arnaldojr/Cubesat/Diagrama em Blocos/Block Diagram.pptx

Solar Panel

Células Solares

Sensor Temperatura

+X

Solar Panel

Células Solares

Sensor Temperatura

-X

Board Charger

CH Ideal

Sensor Tensão/
Corrente

Board Control

Carregador bateria

BATERIA 8.4v
Ion-Lithium

Conversor Boost 12v/1A

Conversor Buck 5v/2A

Conversor Buck 3v3/3A

CH Ideal

Sensor tensão/
corrente

BUS
Power

Solar Panel

Células Solares

Sensor Temperatura

+Y

CH Ideal

CH Ideal

Sensor tensão/
corrente

Solar Panel

Células Solares

-Y

Sensor Temperatura

CH Ideal

Sensor temp.

CH Ideal

CH Ideal

DIODO

Sensor tensão/
corrente

Sensor tensão/
corrente

CH Ideal

MUX. Analógico

Conversor
Buck-Boost
Backup

CAM

Comunicação

Suporte para Desenvolvimento

Tx / Rx

LEDs

CHAVEs

PLACA CARREGADOR

Conversor Buck 5V uC

uC

PLACA DE CONTROLE

## Slide 2

Solar Cell

Temperature Sensor

+X

Solar Cell

Temperature Sensor

-X

Board Charger

CH Ideal

Sensor Tensão/
Corrente

Board Control

Carregador bateria

BATERIA 8.4v
Ion-Lithium

Conversor Boost 12v/1A

Conversor Buck 5v/2A

Conversor Buck 3v3/3A

CH Ideal

Sensor tensão/
corrente

BUS
Power

Solar Cell

Temperature Sensor

+Y

CH Ideal

CH Ideal

Sensor tensão/
corrente

Solar Cell

-Y

Temperature Sensor

CH Ideal

Sensor temp.

CH Ideal

CH Ideal

DIODO

Sensor tensão/
corrente

Sensor tensão/
corrente

CH Ideal

MUX. Analógico

Conversor
Buck-Boost
Backup

CAM

Comunicação

Suporte para Desenvolvimento

Tx / Rx

LEDs

CHAVEs

PLACA CARREGADOR

Conversor Buck 5V uC

uC

PLACA DE CONTROLE

## Slide 3

Solar Panel

Células Solares

Sensor Temperatura

+X

Solar Panel

Células Solares

Sensor Temperatura

-X

CH Ideal

Sensor voltage/ current

Board Control

Charger battery

BATTERY8.4v
Ion-Lithium

Conversor Boost 12v/1A

Conversor Buck 5v/2A

Conversor Buck 3v3/3A

CH Ideal

Sensor tensão/
corrente

BUS
Power

Solar Panel

Células Solares

Sensor Temperatura

+Y

CH Ideal

CH Ideal

Sensor tensão/
corrente

Solar Panel

Células Solares

-Y

Sensor Temperatura

CH Ideal

Sensor temp.

CH Ideal

CH Ideal

DIODO

Sensor tensão/
corrente

Sensor tensão/
corrente

CH Ideal

MUX. Analog

Converter
Buck-Boost
Backup

CAM

Comunicação

Suporte para Desenvolvimento

Tx / Rx

LEDs

CHAVEs

BOARD CHARGER

Conversor Buck 5V uC

uC

PLACA DE CONTROLE

## Slide 4

Solar Panel

Células Solares

Sensor Temperatura

+X

Solar Panel

Células Solares

Sensor Temperatura

-X

Board Charger

CH Ideal

Sensor Tensão/
Corrente

Carregador bateria

BATERIA 8.4v
Ion-Lithium

Boost Conberter 12v/1A

Buck Converter 5v/2A

Buck Converter 3v3/3A

CH Ideal

Sensor voltage/ current

BUS
Power

Solar Panel

Células Solares

Sensor Temperatura

+Y

CH Ideal

CH Ideal

Sensor voltage/ current

Solar Panel

Células Solares

-Y

Sensor Temperatura

CH Ideal

Sensor temp.

CH Ideal

CH Ideal

DIODE

Sensor voltage/ current

Sensor voltage/ current

CH Ideal

MUX. Analógico

Conversor
Buck-Boost
Backup

CAN

Comunication

Development Support

Tx / Rx

LEDs

Buttons

PLACA CARREGADOR

Buck Converter 5V uC

uC

BOARD CONTROL

## Slide 5

Solar Cell

Temperature Sensor

+X

Solar Cell

Temperature Sensor

-X

CH Ideal

Sensor voltage/ current

Charger battery

BATTERY8.4v
Ion-Lithium

Boost Conberter 12v/1A

Buck Converter 5v/2A

Buck Converter 3v3/3A

CH Ideal

Sensor voltage/ current

BUS
Power

Solar Cell

Temperature Sensor

+Y

CH Ideal

CH Ideal

Sensor voltage/ current

Células Solares

-Y

Sensor Temperatura

Temperature Sensor

CH Ideal

Sensor temp.

CH Ideal

CH Ideal

DIODE

Sensor voltage/ current

Sensor voltage/ current

Solar Cell

CH Ideal

MUX. Analog

Converter
Buck-Boost
Backup

CAN

Comunication

Development Support

Tx / Rx

LEDs

Buttons

BOARD CHARGER

Buck Converter 5V uC

uC

BOARD CONTROL

Analog Data

Digital Control

Comunication

Main Power

Backup Power

## Slide 6

+ Vfotocell

GND fotocell

VCC Sensor temp

Sinal Sensor temp

GND Sensor temp

+X

conector

+ Vfotocell

GND fotocell

VCC Sensor temp

Sinal Sensor temp

GND Sensor temp

Conector 1

-X

+ Vfotocell

GND fotocell

VCC Sensor temp

Sinal Sensor temp

GND Sensor temp

conector

+ Vfotocell

GND fotocell

VCC Sensor temp

Sinal Sensor temp

GND Sensor temp

Conector 2

+Y

+ Vfotocell

GND fotocell

VCC Sensor temp

Sinal Sensor temp

GND Sensor temp

conector

GND fotocell

+ Vfotocell

VCC Sensor temp

Sinal Sensor temp

GND Sensor temp

Conector 3

-Y

+ Vfotocell

GND fotocell

VCC Sensor temp

Sinal Sensor temp

GND Sensor temp

conector

+ Vfotocell

GND fotocell

VCC Sensor temp

Sinal Sensor temp

GND Sensor temp

Conector 4

12 V Backup

5 V Backup

Conector 5

CONECTOR BATERIA

12 V Backup

5 V Backup

3 V 3 backup

Vbat

Vcc

Aux_6

Aux

12 V

5 V

BUS saída

3 V 3

V nreg

GND

CAM H

CAM L

GND

CAM

CONTROLE

Conector 1

DEBUG BOT

Serial

3 V 3 backup

Vbat

GND

Vcc

GND

MUX_AD

Aux_6

MUX_AD

Aux_7

Aux

Aux_7

Aux_1

Aux_2

Bot1

Bot2

Aux_3

Bot3

GND

Aux_4

Tx

VCC

Aux_5

GND

Rx

+BAT

ICSP

GND

PGD

PGC

CARREGADOR

## Slide 7

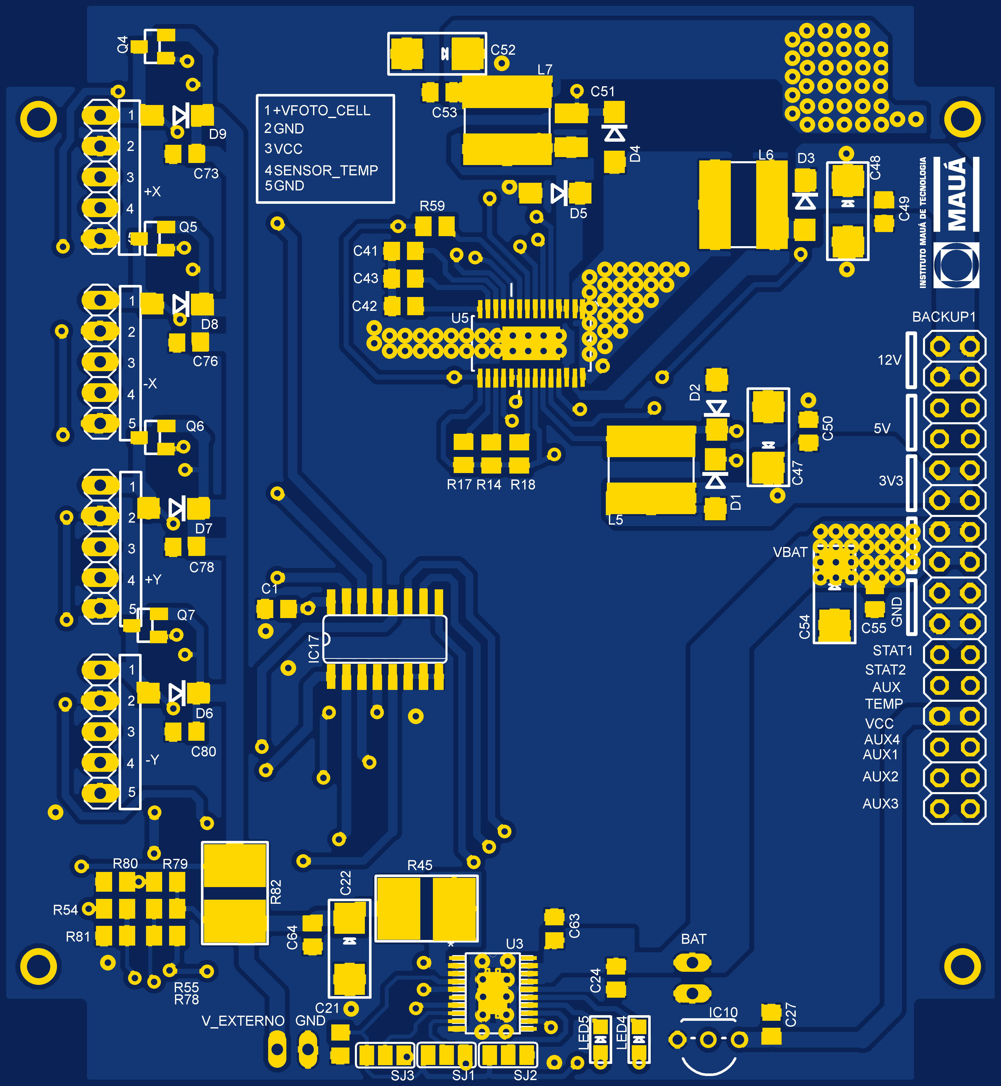
[picture p1: figure]

CH IDEIAL

DC/DC 5V

DC/DC Backup

DC/DC 12V

CH IDEIAL

BUS

DC/DC 3v3

CH IDEIAL

Mux. Analog

CH IDEIAL

Sensor
voltage/ current

Battery Charger

Sensor Temp.

## Slide 8

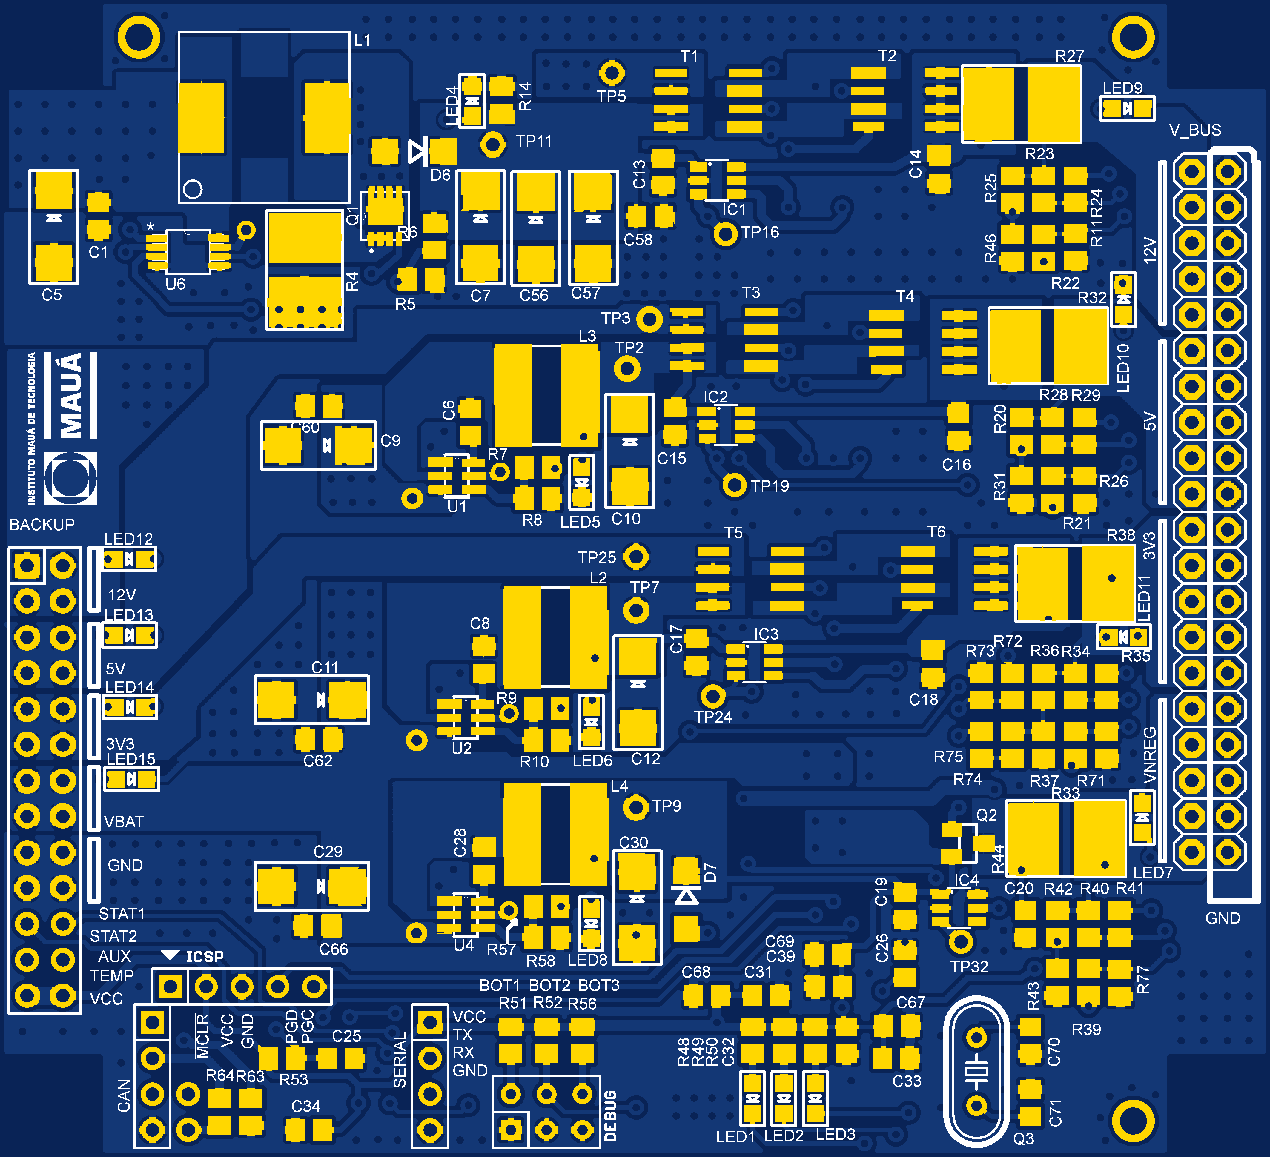
[picture p2: figure]

DC/DC 12V

DC/DC 5V

CH IDEIAL

Sensor
voltage/ current

BUS

CH IDEIAL

Sensor
voltage/ current

BACKUP

DC/DC 3V3

CH IDEIAL

Sensor
voltage/ current

DCDC 5V PIC

DIODE

CH IDEIAL

Sensor
voltage/ current

CAN
COMUNICATION

Development Support

PIC
