arnaldojr/Cubesat/Diagrama em Blocos/Diagrama em blocos.pptx

Painel Solar

Células Solares

Sensor Temperatura

+X

Painel Solar

Células Solares

Sensor Temperatura

-X

Placa do Carregador

CH Ideal

Sensor Tensão/
Corrente

Placa de Controle

Carregador bateria

BATERIA 8.4v
Ion-Lithium

Conversor Boost 12v/1A

Conversor Buck 5v/2A

Conversor Buck 3v3/3A

CH Ideal

Sensor tensão/
corrente

BUS
Power

Painel Solar

Células Solares

Sensor Temperatura

+Y

CH Ideal

CH Ideal

Sensor tensão/
corrente

Painel Solar

Células Solares

-Y

Sensor Temperatura

CH Ideal

Sensor temp.

CH Ideal

CH Ideal

DIODO

Sensor tensão/
corrente

Sensor tensão/
corrente

CH Ideal

MUX. Analógico

Conversor
Buck-Boost
Backup

CAM

Comunicação

Suporte para Desenvolvimento

Tx / Rx

LEDs

CHAVEs

PLACA CARREGADOR

Conversor Buck 5V uC

uC

PLACA DE CONTROLE

## Slide 2

Células Solares

Sensor Temperatura

+X

Células Solares

Sensor Temperatura

-X

Placa do Carregador

CH Ideal

Sensor Tensão/
Corrente

Placa de Controle

Carregador bateria

BATERIA 8.4v
Ion-Lithium

Conversor Boost 12v/1A

Conversor Buck 5v/2A

Conversor Buck 3v3/3A

CH Ideal

Sensor tensão/
corrente

BUS
Power

Células Solares

Sensor Temperatura

+Y

CH Ideal

CH Ideal

Sensor tensão/
corrente

Células Solares

-Y

Sensor Temperatura

CH Ideal

Sensor temp.

CH Ideal

CH Ideal

DIODO

Sensor tensão/
corrente

Sensor tensão/
corrente

CH Ideal

MUX. Analógico

Conversor
Buck-Boost
Backup

CAM

Comunicação

Suporte para Desenvolvimento

Tx / Rx

LEDs

CHAVEs

PLACA CARREGADOR

Conversor Buck 5V uC

uC

PLACA DE CONTROLE

## Slide 3

Painel Solar

Células Solares

Sensor Temperatura

+X

Painel Solar

Células Solares

Sensor Temperatura

-X

CH Ideal

Sensor Tensão/
Corrente

Placa de Controle

Carregador bateria

BATERIA 8.4v
Ion-Lithium

Conversor Boost 12v/1A

Conversor Buck 5v/2A

Conversor Buck 3v3/3A

CH Ideal

Sensor tensão/
corrente

BUS
Power

Painel Solar

Células Solares

Sensor Temperatura

+Y

CH Ideal

CH Ideal

Sensor tensão/
corrente

Painel Solar

Células Solares

-Y

Sensor Temperatura

CH Ideal

Sensor temp.

CH Ideal

CH Ideal

DIODO

Sensor tensão/
corrente

Sensor tensão/
corrente

CH Ideal

MUX. Analógico

Conversor
Buck-Boost
Backup

CAM

Comunicação

Suporte para Desenvolvimento

Tx / Rx

LEDs

CHAVEs

PLACA CARREGADOR

Conversor Buck 5V uC

uC

PLACA DE CONTROLE

## Slide 4

Painel Solar

Células Solares

Sensor Temperatura

+X

Painel Solar

Células Solares

Sensor Temperatura

-X

Placa do Carregador

CH Ideal

Sensor Tensão/
Corrente

Carregador bateria

BATERIA 8.4v
Ion-Lithium

Conversor Boost 12v/1A

Conversor Buck 5v/2A

Conversor Buck 3v3/3A

CH Ideal

Sensor tensão/
corrente

BUS
Power

Painel Solar

Células Solares

Sensor Temperatura

+Y

CH Ideal

CH Ideal

Sensor tensão/
corrente

Painel Solar

Células Solares

-Y

Sensor Temperatura

CH Ideal

Sensor temp.

CH Ideal

CH Ideal

DIODO

Sensor tensão/
corrente

Sensor tensão/
corrente

CH Ideal

MUX. Analógico

Conversor
Buck-Boost
Backup

CAM

Comunicação

Suporte para Desenvolvimento

Tx / Rx

LEDs

CHAVEs

PLACA CARREGADOR

Conversor Buck 5V uC

uC

PLACA DE CONTROLE

## Slide 5

Células Solares

Sensor Temperatura

+X

Células Solares

Sensor Temperatura

-X

CH Ideal

Sensor Tensão/
Corrente

Carregador bateria

BATERIA 8.4v
Ion-Lithium

Conversor Boost 12v/1A

Conversor Buck 5v/2A

Conversor Buck 3v3/3A

CH Ideal

Sensor tensão/
corrente

BUS
Power

Células Solares

Sensor Temperatura

+Y

CH Ideal

CH Ideal

Sensor tensão/
corrente

Células Solares

-Y

Sensor Temperatura

CH Ideal

Sensor temp.

CH Ideal

CH Ideal

DIODO

Sensor tensão/
corrente

Sensor tensão/
corrente

CH Ideal

MUX. Analógico

Conversor
Buck-Boost
Backup

CAM

Comunicação

Suporte para Desenvolvimento

Tx / Rx

LEDs

CHAVEs

PLACA CARREGADOR

Conversor Buck 5V uC

uC

PLACA DE CONTROLE

Dado Analógico

Controle Digital

Comunicação

Potência Principal

Potência Backup

## Slide 6

+ Vfotocell

GND fotocell

VCC Sensor temp

Sinal Sensor temp

GND Sensor temp

+X

conector

+ Vfotocell

GND fotocell

VCC Sensor temp

Sinal Sensor temp

GND Sensor temp

Conector 1

-X

+ Vfotocell

GND fotocell

VCC Sensor temp

Sinal Sensor temp

GND Sensor temp

conector

+ Vfotocell

GND fotocell

VCC Sensor temp

Sinal Sensor temp

GND Sensor temp

Conector 2

+Y

+ Vfotocell

GND fotocell

VCC Sensor temp

Sinal Sensor temp

GND Sensor temp

conector

GND fotocell

+ Vfotocell

VCC Sensor temp

Sinal Sensor temp

GND Sensor temp

Conector 3

-Y

+ Vfotocell

GND fotocell

VCC Sensor temp

Sinal Sensor temp

GND Sensor temp

conector

+ Vfotocell

GND fotocell

VCC Sensor temp

Sinal Sensor temp

GND Sensor temp

Conector 4

12 V Backup

5 V Backup

Conector 5

CONECTOR BATERIA

12 V Backup

5 V Backup

3 V 3 backup

Vbat

Vcc

Aux_6

Aux

12 V

5 V

BUS saída

3 V 3

V nreg

GND

CAM H

CAM L

GND

CAM

CONTROLE

Conector 1

DEBUG BOT

Serial

3 V 3 backup

Vbat

GND

Vcc

GND

MUX_AD

Aux_6

MUX_AD

Aux_7

Aux

Aux_7

Aux_1

Aux_2

Bot1

Bot2

Aux_3

Bot3

GND

Aux_4

Tx

VCC

Aux_5

GND

Rx

+BAT

ICSP

GND

PGD

PGC

CARREGADOR

## Slide 7


CH IDEIAL

DC/DC 5V

DC/DC Backup

DC/DC 12V

CH IDEIAL

BUS

DC/DC 3v3

CH IDEIAL

Mux. Analógico

CH IDEIAL

Sensor
tensão /corrente

Carregador de Bateria

Sensor Temp.

## Slide 8


DC/DC 12V

DC/DC 5V

CH IDEIAL

Sensor
tensão /corrente

BUS

CH IDEIAL

Sensor
tensão /corrente

BACKUP

DC/DC 3V3

CH IDEIAL

Sensor
tensão /corrente

DCDC 5V PIC

DIODO

CH IDEIAL

Sensor
tensão /corrente

CAM COMUNICAÇÃO

SUPORTE PARA DESENVOLVIMENTO

PIC
