arnaldojr/Cubesat/05. Cubesat_Potencia_Controle-rev1/eagleUp/eagleUp_Cubesat_Potencia_Controle-rev3_board_bottom.png

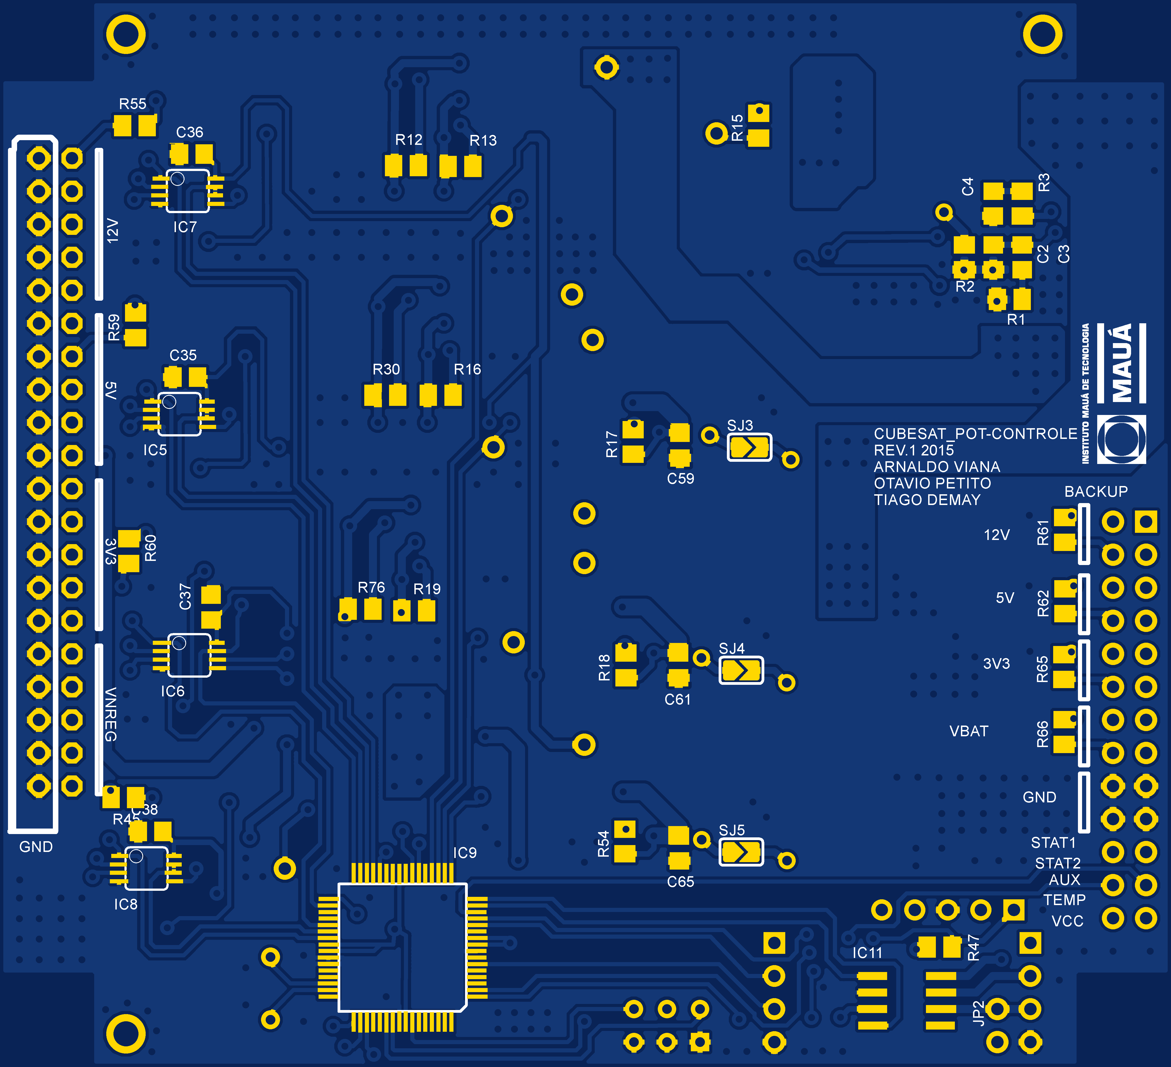
05. Cubesat_Potencia_Controle-rev1/eagleUp/eagleUp_Cubesat_Potencia_Controle-rev3_board_bottom.png
