arnaldojr/Cubesat/04. Cubesat_Potencia-rev1 #ESQUEMATICO COMPLETO#/BOM_Cubesat_Potencia-rev1.xlsx

LISTA DE COMPRA DE COMPONENTES ELETRÔNICOS |  |  |  |  |  |  |  |  |  |  | QUANTIDADE DE KITS
Qty UNITARIA | VALOR | COMPONENTE | Package | Parts | DESCRIÇÃO | FABRICANTE | PART_NUMBER | DATASHEET | VENDOR | QUANTIDADE | 4
1 | 3300pF | CAPACITOR | SMD 0805 | C40 | CERAMIC CAPACITOR 3300PF, 50V, X7R, 10%, 0805 | MULTICOMP | MC0805B332K500CT | http://www.newark.com/pdfs/datasheets/spc/Ta-1100.pdf | http://www.newark.com/multicomp/mc0805b332k500ct/ceramic-capacitor-3300pf-50v-x7r/dp/06R3830 | 4
1 | 0.022uF | CAPACITOR | SMD 0805 | C45 | CAP, MLCC, X7R, 0.022UF, 100V, 0805 | Vishay | VJ0805Y223KXBBC31 | http://www.farnell.com/datasheets/1805048.pdf | http://www.newark.com/vishay/vj0805y223kxbbc31/cap-mlcc-x7r-0-022uf-100v-0805/dp/52X6516 | 4
1 | 1000pF | CAPACITOR | SMD 0805 | C44 | CAPACITOR, European symbol | Vishay | VJ0805Y102KXBBC31 | http://www.farnell.com/datasheets/1805048.pdf | http://www.newark.com/vishay/vj0805y102kxbbc31/cap-mlcc-x7r-1000pf-100v-0805/dp/52X6506 | 4
37 | 100nF | CAPACITOR | SMD 0805 | C1, C6, C8, C13, C14, C15, C16, C17, C18, C19, C20, C21, C25, C27, C28, C31, C32, C33, C34, C35, C36, C37, C38, C39, C49, C50, C53, C55, C46, C51, C58, C59, C60, C61, C62, C63, C64, C65, C66 | CAP, MLCC, X7R, 0.1UF, 50V, 0805 | Vishay | VJ0805Y104KXABE31 | http://www.farnell.com/datasheets/1805048.pdf | http://uk.farnell.com/vishay/vj0805y104kxabe31/cap-mlcc-x7r-0-1uf-50v-0805/dp/2407376 | 148
1 | 10nF | CAPACITOR | SMD 0805 | C4 | CAP, MLCC, X7R, 0.01UF, 50V, 0805 | Vishay | VJ0805Y103KNAAO | http://www.farnell.com/datasheets/1805046.pdf | http://uk.farnell.com/vishay/vj0805y103knaao/cap-mlcc-x7r-0-01uf-50v-0805/dp/2407329 | 4
4 | 10uF | CAPACITOR | CASE R | C26, C67, C68, C69 | CAP, TANT, 10UF, 16V, CASE R | Vishay | TP8R106M016C | http://www.farnell.com/datasheets/1821045.pdf | http://uk.farnell.com/vishay/tp8r106m016c/cap-tant-10uf-16v-case-r/dp/2425577 | 16
3 | 1500pF | CAPACITOR | SMD 0805 | C41, C42, C43 | CAPACITOR, European symbol | Vishay | VJ0805A152JXBMT | http://www.farnell.com/datasheets/1706682.pdf | http://www.newark.com/vishay-vitramon/vj0805a152jxbmt/ceramic-capacitor-1500pf-100v/dp/46C8460 | 12
1 | 1uF | CAPACITOR | SMD 0805 | C24 | TANT, 1UF, 20V, CASE W | Vishay | TP8W105M020C | http://www.farnell.com/datasheets/1821045.pdf | http://www.newark.com/vishay/tp8w105m020c/cap-tant-1uf-20v-case-w/dp/79X2114?ost=TP8W105M020C | 4
1 | 2.2nF | CAPACITOR | SMD 0805 | C2 | CAP, MLCC, X7R, 2200PF, 100V, 0805 | Vishay | VJ0805Y222KXBBC31 | http://www.farnell.com/datasheets/1805048.pdf | http://www.newark.com/vishay/vj0805y222kxbbc31/cap-mlcc-x7r-2200pf-100v-0805/dp/52X6514?ost=VJ0805Y222KXBBC31 | 4
1 | 220nF | CAPACITOR | SMD 0805 | C23 | CAP, MLCC, X7R, 0.22UF, 25V, 0805 | Vishay | VJ0805Y224KNXAT | http://www.farnell.com/datasheets/1805046.pdf | http://www.newark.com/vishay/vj0805y224knxat/cap-mlcc-x7r-0-22uf-25v-0805/dp/52X6517?ost=VJ0805Y224KNXAT | 4
8 | 22uF | CAPACITOR | CASE C | C9, C11, C22, C29, C47, C48, C52, C54 | CAP, TANT, 22UF, 16V, CASE C | Vishay | TR3C226K016C0350 | http://www.farnell.com/datasheets/1923401.pdf | http://uk.farnell.com/vishay/tr3c226k016c0350/cap-tant-22uf-16v-case-c/dp/2353165 | 32
1 | 47nF | CAPACITOR | SMD 0805 | C3 | CAP, MLCC, X7R, 0.047UF, 50V, 0805 | Vishay | VJ0805Y473KXABC31 | http://www.farnell.com/datasheets/1805048.pdf | http://uk.farnell.com/vishay/vj0805y473kxabc31/cap-mlcc-x7r-0-047uf-50v-0805/dp/2407375 | 4
7 | 47uF | CAPACITOR | CASE C | C10, C12, C30, C5, C7, C56, C57 | CAP, TANT, 47UF, 16V, CASE C | Vishay | TR3C476K016C0350 | http://www.farnell.com/datasheets/1923401.pdf | http://uk.farnell.com/vishay-sprague/tr3c476k016c0350/cap-tant-47uf-16v-case-c/dp/1754090 | 28
1 | LT1941 | CIRCUITO INTEGRADO | TSSOP | U5 | IC, DC/DC CONVERTER, SMD, TSSOP28 | Linear Technology | LT1941EFE#PBF | http://www.farnell.com/datasheets/1717045.pdf | http://uk.farnell.com/linear-technology/lt1941efe-pbf/ic-dc-dc-converter-smd-tssop28/dp/1273793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 | 4
4 | LTC4412HV | CIRCUITO INTEGRADO | SOT-23 | IC1, IC2, IC3, IC4 | IC, POWER PATH CONTROLLER, TSOT23-6 | Linear Technology | LTC4412ES6#TRMPBF | http://www.farnell.com/datasheets/1898070.pdf | http://uk.farnell.com/linear-technology/ltc4412es6-trmpbf/ic-power-path-controller-tsot23/dp/1663917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 | 16
1 | MCP2551 | CIRCUITO INTEGRADO | 8-SOIC | IC11 | CAN TRANSCEIVER, 1MBPS, 1/1, 5.5V, 8-SOIC | Microchip Technology | MCP2551-I/SN | http://www.farnell.com/datasheets/657417.pdf | http://www.newark.com/microchip/mcp2551-i-sn/can-transceiver-1mbps-1-1-5-5v/dp/69K7604 | 4
1 | PIC18F66K80 | CIRCUITO INTEGRADO | TQFP64-10X10X1MM | IC9 | MCU, 8BIT, PIC18, 64MHZ, TQFP-64 | Microchip Technology | PIC18F66K80-I/PT-ND | http://www.farnell.com/datasheets/1524494.pdf | http://uk.farnell.com/microchip/pic18f66k80-i-pt/mcu-8bit-pic18-64mhz-tqfp-64/dp/1823178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 | 4
1 | BQ24005_PWP_20C | CIRCUITO INTEGRADO | PWP20_2P4X3P4-M | U3 | CARREGADOR DE BATERIA | Texas Instruments | BQ24005PWP | http://www.farnell.com/datasheets/1762401.pdf | http://uk.farnell.com/texas-instruments/bq24005pwp/ic-battery-charger-liion-1-2a/dp/1106058?ost=BQ24005PWP | 4
1 | LM3488MM/NOPB | CIRCUITO INTEGRADO | VSSOP | U$1 | IC, N-CH CONTROLLER, VSSOP-8 | Texas Instruments | LM3488MM/NOPB | http://www.farnell.com/datasheets/1882647.pdf | Texas Instruments | 4
4 | LMP2012 | CIRCUITO INTEGRADO | VSSOP | IC5, IC6, IC7, IC8 | OP AMP, 3MHZ, 4V/US, VSSOP-8 | Texas Instruments | LMP2012MM/NOPB | http://www.farnell.com/datasheets/1882777.pdf | http://uk.farnell.com/texas-instruments/lmp2012mm-nopb/op-amp-3mhz-4v-us-vssop-8/dp/2382791 | 16
3 | TPS563209DDCT | CIRCUITO INTEGRADO | SOT-23 | U1, U2, U4 | SYNC BUCK REGULATOR, 650KHZ, SOT-23-6 | Texas Instruments | TPS563209DDCT | http://www.farnell.com/datasheets/1861870.pdf | http://uk.farnell.com/texas-instruments/tps563209ddct/sync-buck-regulator-650khz-sot/dp/2455147 | 12
6 | B340A-13-F | DIODO | DO-214AC | D1, D2, D3, D4, D5, D6 | SCHOTTKY DIODE, 3A, 40V, DO-214AC | DIODES INC. | B340A-13-F | http://www.farnell.com/datasheets/1911813.pdf | http://www.newark.com/diodes-inc/b340a-13-f/schottky-diode-3a-40v-do-214ac/dp/12T1465 | 24
1 | 10uH | INDUTOR | 6.86mm x 6.47mm x 3mm | L6 | INDUCTOR, 3A, 10UH | Vishay | IHLP2525CZER100M01 | http://www.farnell.com/datasheets/1911028.pdf | http://uk.farnell.com/vishay-dale/ihlp2525czer100m01/inductor-3a-10uh/dp/1692722 | 4
1 | 2.2uH | INDUTOR | 5.49mm x 5.18mm x 2mm | L2 | INDUCTOR, 2.2UH, 5.5A, 20% | Vishay | IHLP2020BZER2R2M11 | http://www.farnell.com/datasheets/1854284.pdf | http://uk.farnell.com/vishay-dale/ihlp2020bzer2r2m11/inductor-2-2uh-5-5a-20/dp/1741312 | 4
4 | 3.3uH | INDUTOR | 6.86mm x 6.47mm x 3mm | L3, L4, L7, L5 | NDUCTOR, SMD, 3.3UH | Vishay | IHLP2525CZER3R3M01 | http://www.farnell.com/datasheets/18204.pdf | http://uk.farnell.com/vishay-dale/ihlp2525czer3r3m01/inductor-smd-3-3uh/dp/1187066 | 16
1 | 33uH | INDUTOR | 10.8mm x 10.8mm x 4.16mm | L1 | SHIELDED, 33UH, 3.7A, 20% | Vishay | IHLE4040DCER330M5A | http://www.farnell.com/datasheets/1885593.pdf | http://uk.farnell.com/vishay/ihle4040dcer330m5a/inductor-shielded-33uh-3-7a-20/dp/2469472 | 4
3 | LED | LED | SMD 0805 | LED1, LED2, LED3 | LED VERDE | KINGBRIGHT | KP-2012CGCK | http://www.farnell.com/datasheets/1683496.pdf | http://uk.farnell.com/kingbright/kp-2012cgck/led-0805-50mcd-green/dp/2290331 | 12
1 | CSD16323Q3 | MOSFET CANAL N | 8SON | Q1 | MOSFET, N CH, 25V, 60A, 8SON | Texas Instruments | CSD16323Q3 | http://www.farnell.com/datasheets/1847549.pdf | http://uk.farnell.com/texas-instruments/csd16323q3/mosfet-n-ch-25v-60a-8son/dp/1778306 | 4
1 | FDN360P | MOSFET CANAL P | SUPER-SOT3 | Q2 | MOSFET, P, SMD, SSOT-3 | FAIRCHILD SEMICONDUCTOR | FDN306P | http://www.farnell.com/datasheets/264983.pdf | http://uk.farnell.com/fairchild-semiconductor/fdn306p/mosfet-p-smd-ssot-3/dp/1471047 | 4
6 | Si9933CDY | MOSFET DUPLO CANAL P | SO8 | T1, T2, T3, T4, T5, T6 | MOSFET, PP-CH, 20V, 4A, SO8 | Vishay | SI9933CDY-T1-GE3 | http://www.farnell.com/datasheets/1911736.pdf | http://uk.farnell.com/vishay/si9933cdy-t1-ge3/mosfet-pp-ch-20v-4a-so8/dp/1779275 | 24
5 | 0.1R | RESISTOR | SMD 2818 | R27, R32, R38, R44, R45 | METAL STRIP, 0.033OHM, 7W, 1% | Vishay | WSHM2818R0330FEB | http://www.farnell.com/datasheets/1885592.pdf | http://uk.farnell.com/vishay/wshm2818r0330feb/resistor-metal-strip-0-033ohm/dp/2469459 | 20
4 | 470R | RESISTOR | SMD 0805 | R47, R48, R49, R50 | 470R, 0.125W, 1%, 0805, SMD | Vishay | CRCW0805470RFKEA | http://www.farnell.com/datasheets/1720486.pdf | http://uk.farnell.com/vishay-draloric/crcw0805470rfkea/resistor-470r-0-125w-1-0805-smd/dp/1469932 | 16
1 | 100R | RESISTOR | SMD 0805 | R3 | Thick Film, 100R, 0.125W, 1%, 0805 | Vishay | CRCW0805100RFKEA | http://www.farnell.com/datasheets/1720486.pdf | http://uk.farnell.com/vishay-draloric/crcw0805100rfkea/resistor-100r-0-125w-1-0805-smd/dp/1469862 | 4
5 | 100k | RESISTOR | SMD 0805 | R14, R15, R17, R18, R59 | HICK FILM RESISTOR, 100KOHM, 125mW, 1% | Vishay | CRCW0805100KFKEB | http://www.farnell.com/datasheets/1824995.pdf | http://www.newark.com/vishay-dale/crcw0805100kfkeb/thick-film-resistor-100kohm-125mw/dp/65J1373 | 20
16 | 10k | RESISTOR | SMD 0805 | R8, R10, R31, R42, R43, R53, R54, R55, R58, R61, R36, R37, R73, R51, R52, R56 | THICK FILM, 0.125W, 1%, 0805 | Vishay | CRCW080510K0FKTA | http://www.farnell.com/datasheets/1533075.pdf | http://uk.farnell.com/vishay-draloric/crcw080510k0fkta/thick-film-chip-resistor/dp/1652909 | 64
1 | 10k7 | RESISTOR | SMD 0805 | R65 | THICK FILM RESISTOR, 10.7KOHM, 125mW, 1% | Vishay | CRCW080510K7FKEA | http://www.farnell.com/datasheets/1824995.pdf | http://www.newark.com/vishay-dale/crcw080510k7fkea/thick-film-resistor-10-7kohm-125mw/dp/52K9800 | 4
1 | 115k | RESISTOR | SMD 0805 | R67 | THICK FILM RESISTOR, 115KOHM, 125mW, 1% | Vishay | CRCW0805115KFKEA | http://www.farnell.com/datasheets/1824995.pdf | http://www.newark.com/vishay-dale/crcw0805115kfkea/thick-film-resistor-115kohm-125mw/dp/52K9832 | 4
1 | 120R | RESISTOR | SMD 0805 | R64 | THICK FILM RESISTOR, 120 OHM, 125mW, 1% | Vishay | CRCW0805120RFKEA | http://www.farnell.com/datasheets/1824995.pdf | http://www.newark.com/vishay-dale/crcw0805120rfkea/thick-film-resistor-120-ohm-125mw/dp/52K9845 | 4
1 | 13k3 | RESISTOR | SMD 0805 | R68 | THICK FILM RESISTOR, 13.3KOHM, 125mW, 1% | Vishay | CRCW080513K3FKEA | http://www.farnell.com/datasheets/1824995.pdf | http://www.newark.com/vishay-dale/crcw080513k3fkea/thick-film-resistor-13-3kohm-125mw/dp/52K9855 | 4
2 | 17K4 | RESISTOR | SMD 0805 | R69, R72 | THICK FILM RESISTOR, 17.4KOHM, 125mW, 1% | Vishay | CRCW080517K4FKEA | http://www.farnell.com/datasheets/1824995.pdf | http://www.newark.com/vishay-dale/crcw080517k4fkea/thick-film-resistor-17-4kohm-125mw/dp/52K9914 | 8
1 | 1k | RESISTOR | SMD 0805 | R5 | 1K, 0.125W, 1%, 0805 | Vishay | CRCW08051K00FKEA | http://www.farnell.com/datasheets/1720486.pdf | http://uk.farnell.com/vishay-draloric/crcw08051k00fkea/resistor-1k-0-125w-1-0805-smd/dp/1469847 | 4
2 | 1k5 | RESISTOR | SMD 0805 | R62, R20 | THICK FILM RESISTOR, 1.5KOHM, 125mW, 1% | Vishay | CRCW08051K50FKEB | http://www.farnell.com/datasheets/1824995.pdf | http://www.newark.com/vishay-dale/crcw08051k50fkeb/thick-film-resistor-1-5kohm-125mw/dp/65J1295 | 8
8 | 220k | RESISTOR | SMD 0805 | R24, R29, R35, R41, R11, R26, R71, R77 | THICK FILM, 0.125W, 1%, 0805 | Vishay | CRCW0805220KFKEA | http://www.farnell.com/datasheets/1697337.pdf | http://uk.farnell.com/vishay-draloric/crcw0805220kfkea/resistor-0805-220k-1/dp/1469653 | 32
8 | 22k | RESISTOR | SMD 0805 | R21, R22, R23, R28, R33, R34, R39, R40 | THICK FILM, 0.125W, 1%, 0805 | Vishay | CRCW080522K0FKEA | http://www.farnell.com/datasheets/1720486.pdf | http://uk.farnell.com/vishay-draloric/crcw080522k0fkea/resistor-22k-0-125w-1-0805-smd/dp/1469896 | 32
2 | 2K49 | RESISTOR | SMD 0805 | R66, R70 | THICK FILM RESISTOR, 2.49KOHM, 125mW, 1% | Vishay | CRCW08052K49FKEA | http://www.farnell.com/datasheets/1914725.pdf | http://www.newark.com/vishay-dale/crcw08052k49fkea/thick-film-resistor-2-49kohm-125mw/dp/52K9959 | 8
1 | 2k2 | RESISTOR | SMD 0805 | R60 | THICK FILM RESISTOR, 2.2KOHM, 125mW, 1% | Vishay | CRCW08052K20FKEA | http://www.farnell.com/datasheets/1824995.pdf | http://www.newark.com/vishay-dale/crcw08052k20fkea/thick-film-resistor-2-2kohm-125mw/dp/52K9951 | 4
3 | 3.4k | RESISTOR | SMD 0805 | R1, R74, R75 | THICK FILM, 0.125W, 1%, 0805 | Vishay | CRCW08053K40FKEA | http://www.farnell.com/datasheets/1697337.pdf | http://uk.farnell.com/vishay-draloric/crcw08053k40fkea/resistor-0805-3k4-1/dp/2138953 | 12
1 | 0.033R | RESISTOR | SMD 2818 | R4 | METAL STRIP, 0.033OHM, 7W, 1% | Vishay | WSHM2818R0330FEB | http://www.farnell.com/datasheets/1885592.pdf | http://uk.farnell.com/vishay/wshm2818r0330feb/resistor-metal-strip-0-033ohm/dp/2469459RL | 4
3 | 33.2k | RESISTOR | SMD 0805 | R9, R25, R46 | THICK FILM, 0.125W, 1%, 0805 | Vishay | CRCW080533K2FKEA | http://www.farnell.com/datasheets/1697337.pdf | http://uk.farnell.com/vishay-draloric/crcw080533k2fkea/resistor-0805-33k2-1/dp/1469917 | 12
2 | 56.2k | RESISTOR | SMD 0805 | R7, R57 | THICK FILM, 0.125W, 1%, 0805 | Vishay | CRCW080556K2FKEA | http://www.farnell.com/datasheets/1533075.pdf | http://uk.farnell.com/vishay-draloric/crcw080556k2fkea/resistor-0805-56k2-1/dp/1653020 | 8
6 | 680k | RESISTOR | SMD 0805 | R13, R16, R19, R12, R30, R76 | THICK FILM, 0.125W, 1%, 0805 | Vishay | CRCW0805680KFKEA | http://www.farnell.com/datasheets/1697337.pdf | http://uk.farnell.com/vishay-draloric/crcw0805680kfkea/resistor-0805-680k-1/dp/2139102 | 24
1 | 71.5k | RESISTOR | SMD 0805 | R2 | THICK FILM, 0.125W, 1%, 0805 | Vishay | CRCW080571K5FKEA | http://www.farnell.com/datasheets/1533075.pdf | http://uk.farnell.com/vishay-draloric/crcw080571k5fkea/resistor-0805-71k5-1/dp/1653034 | 4
1 | 8.45k | RESISTOR | SMD 0805 | R6 | THICK FILM, 0.125W, 1%, 0805 | Vishay | CRCW08058K45FKEA | http://www.farnell.com/datasheets/1697337.pdf | http://uk.farnell.com/vishay-draloric/crcw08058k45fkea/resistor-0805-8k45-1/dp/2138971 | 4
1 | TMP35 | SENSOR DE TEMPERATURA | SOT23-5 | IC10 | IC, SENSOR, TEMP, TO-92-3 | ANALOG DEVICES | TMP36GT9Z | http://www.farnell.com/datasheets/1793789.pdf | http://uk.farnell.com/analog-devices/tmp36gt9z/ic-sensor-temp-to-92-3/dp/1438760?ost=1438760 | 4
