arnaldojr/Cubesat/08. Cubesat_Potencia_Painel_Solar/Cubesat_Potencia_Painel_Solar.dxf

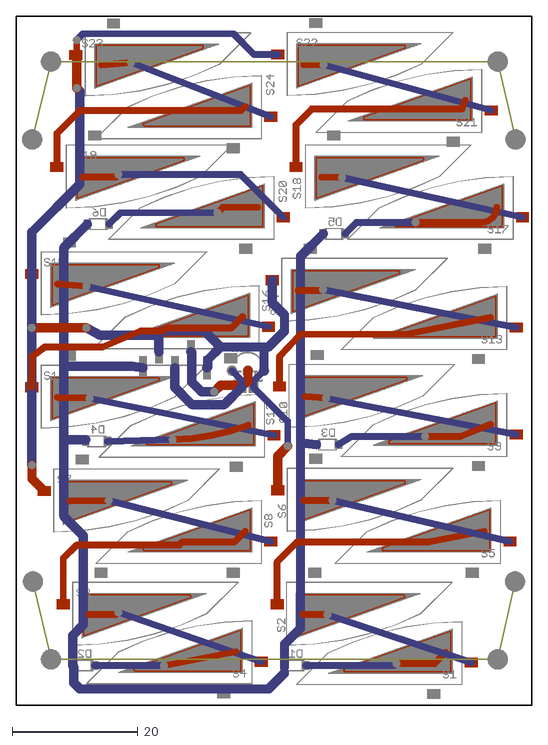
[picture p4: CAD file, 2018-11-02]
08. Cubesat_Potencia_Painel_Solar/Cubesat_Potencia_Painel_Solar.dxf
82.0 x 109.5
