arnaldojr/Cubesat/04. Cubesat_Potencia-rev1 #ESQUEMATICO COMPLETO#/Cubesat-rev1.pdf

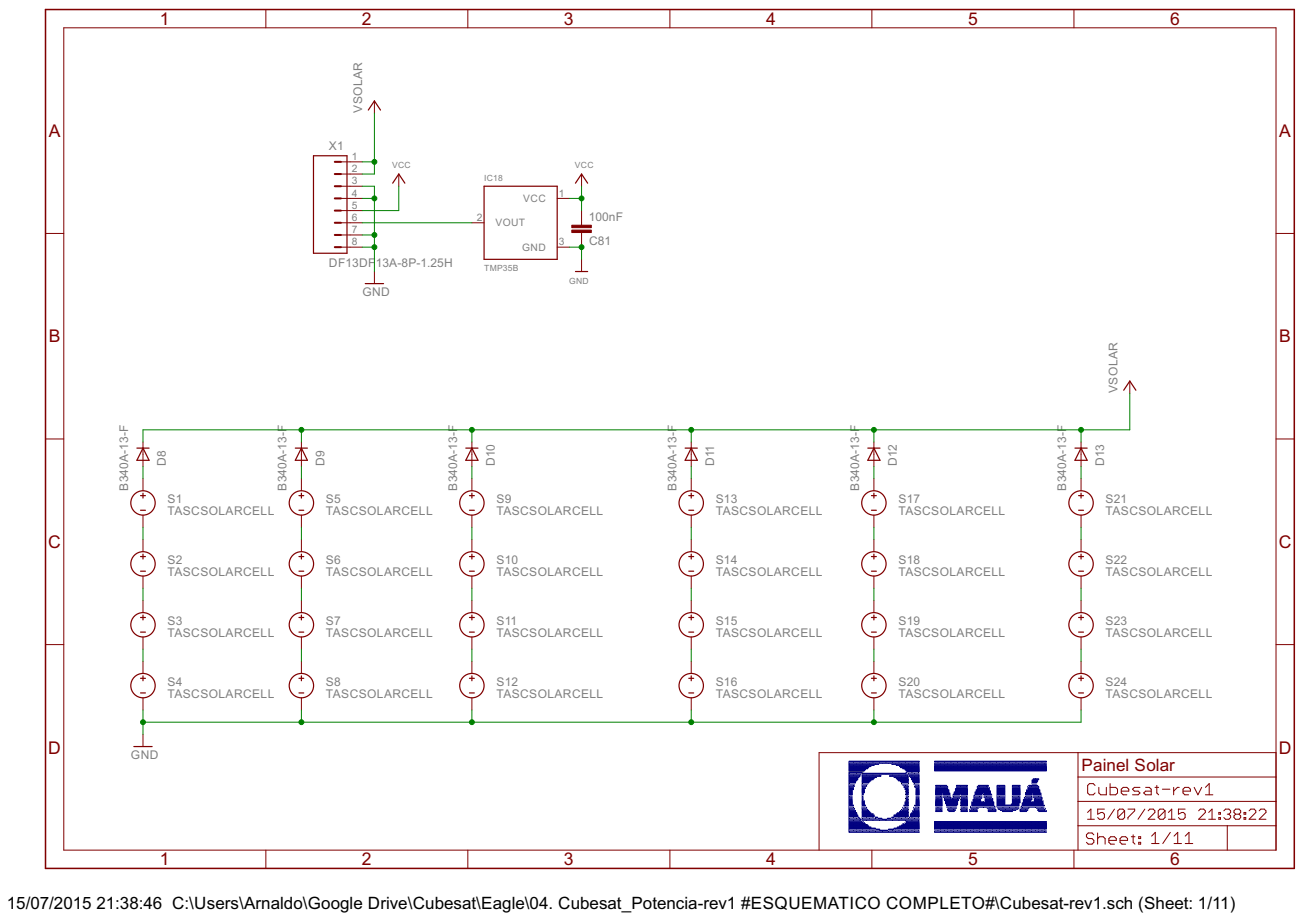
[picture p5: page 1]

15/07/2015 21:38:46 C:\Users\Arnaldo\Google Drive\Cubesat\Eagle\04. Cubesat_Potencia-rev1 #ESQUEMATICO COMPLETO#\Cubesat-rev1.sch (Sheet: 1/11)

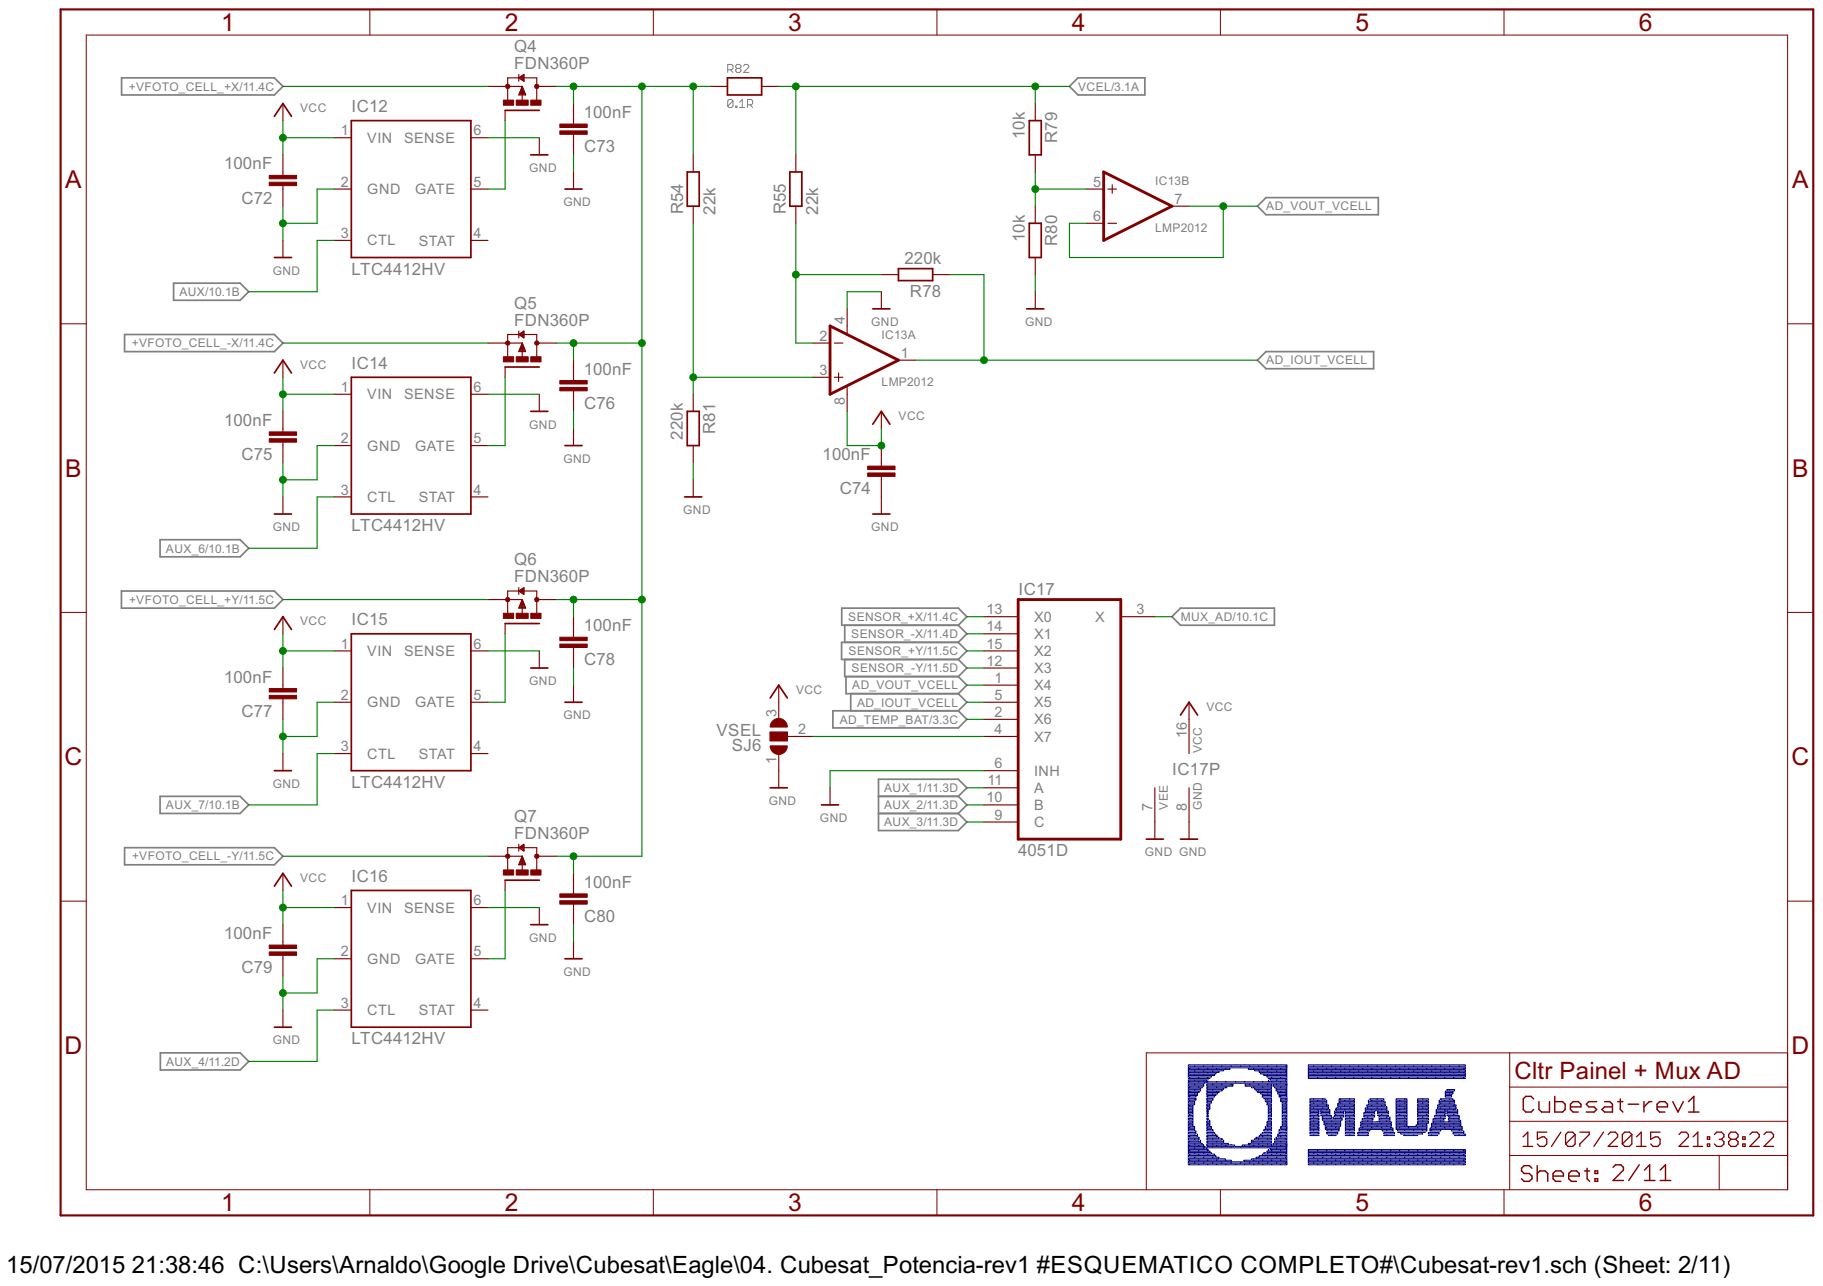
[picture p6: page 2]

15/07/2015 21:38:46 C:\Users\Arnaldo\Google Drive\Cubesat\Eagle\04. Cubesat_Potencia-rev1 #ESQUEMATICO COMPLETO#\Cubesat-rev1.sch (Sheet: 2/11)

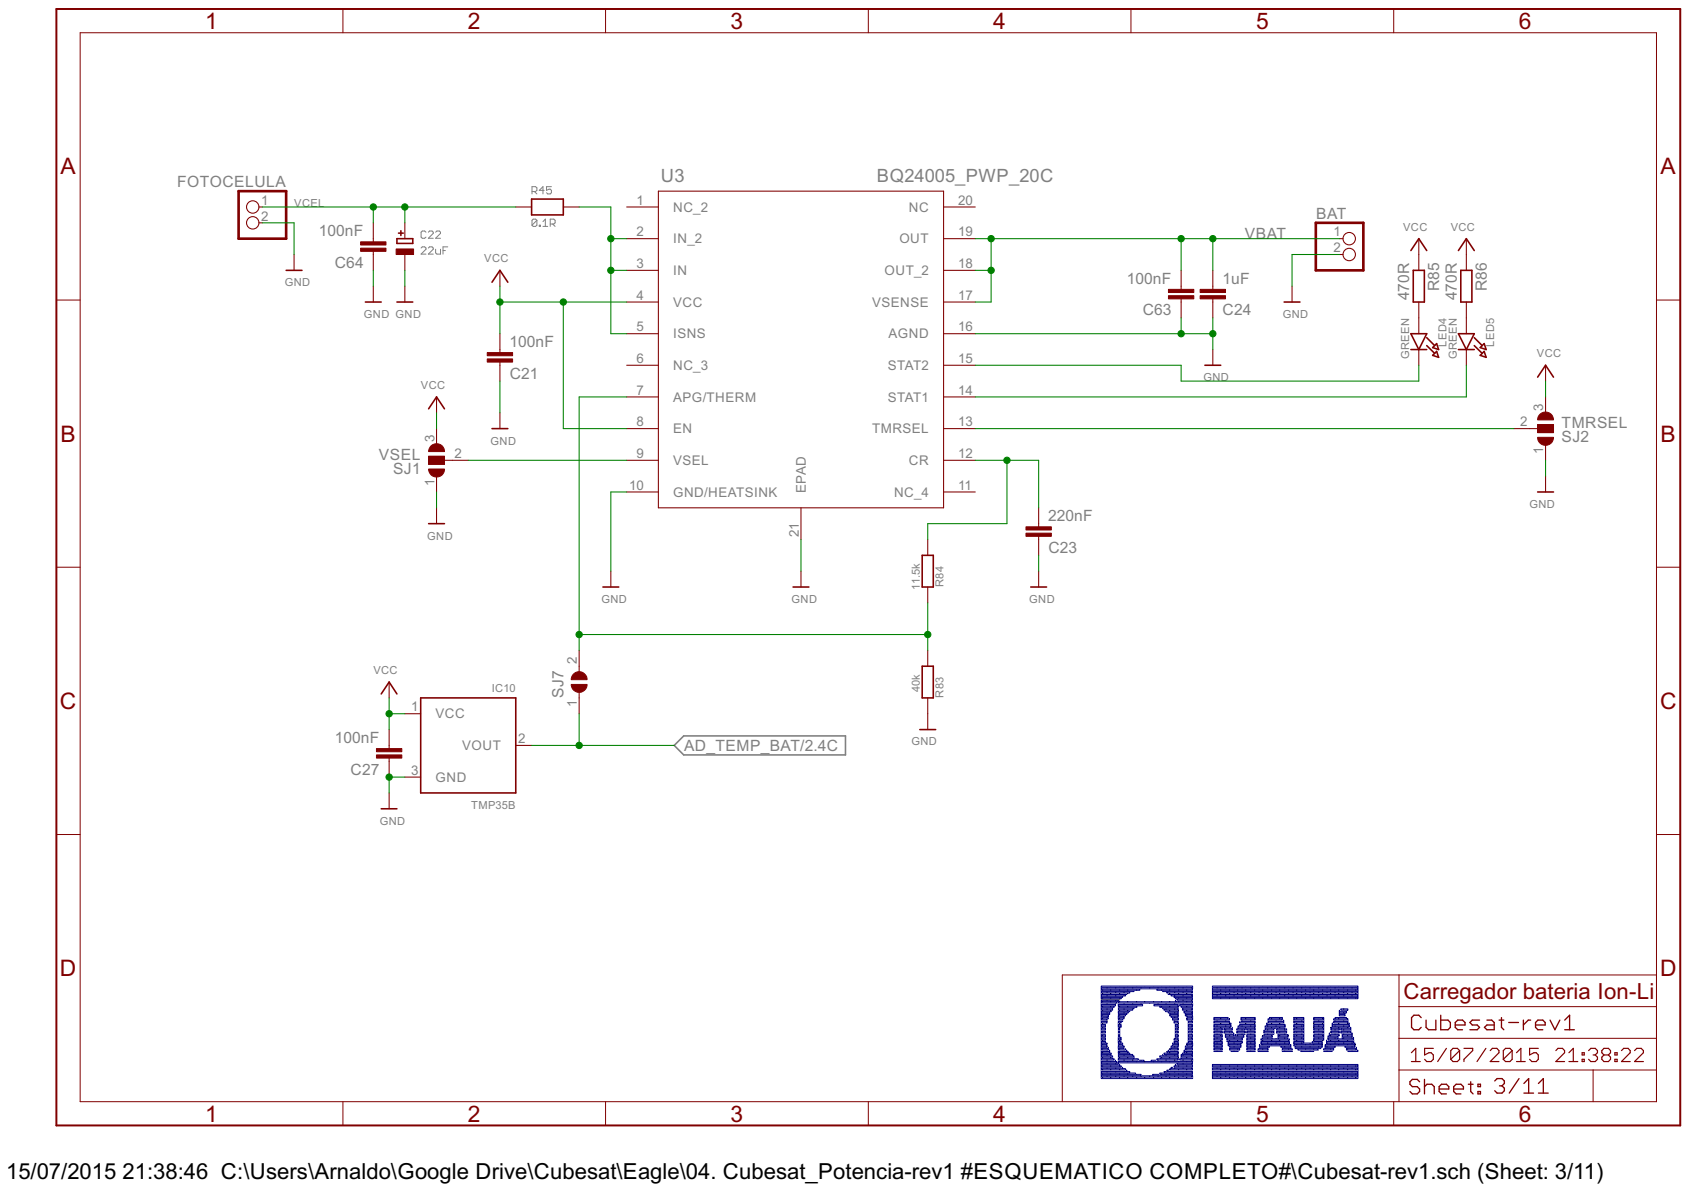
[picture p7: page 3]

Carregador bateria Ion-Li

15/07/2015 21:38:46 C:\Users\Arnaldo\Google Drive\Cubesat\Eagle\04. Cubesat_Potencia-rev1 #ESQUEMATICO COMPLETO#\Cubesat-rev1.sch (Sheet: 3/11)

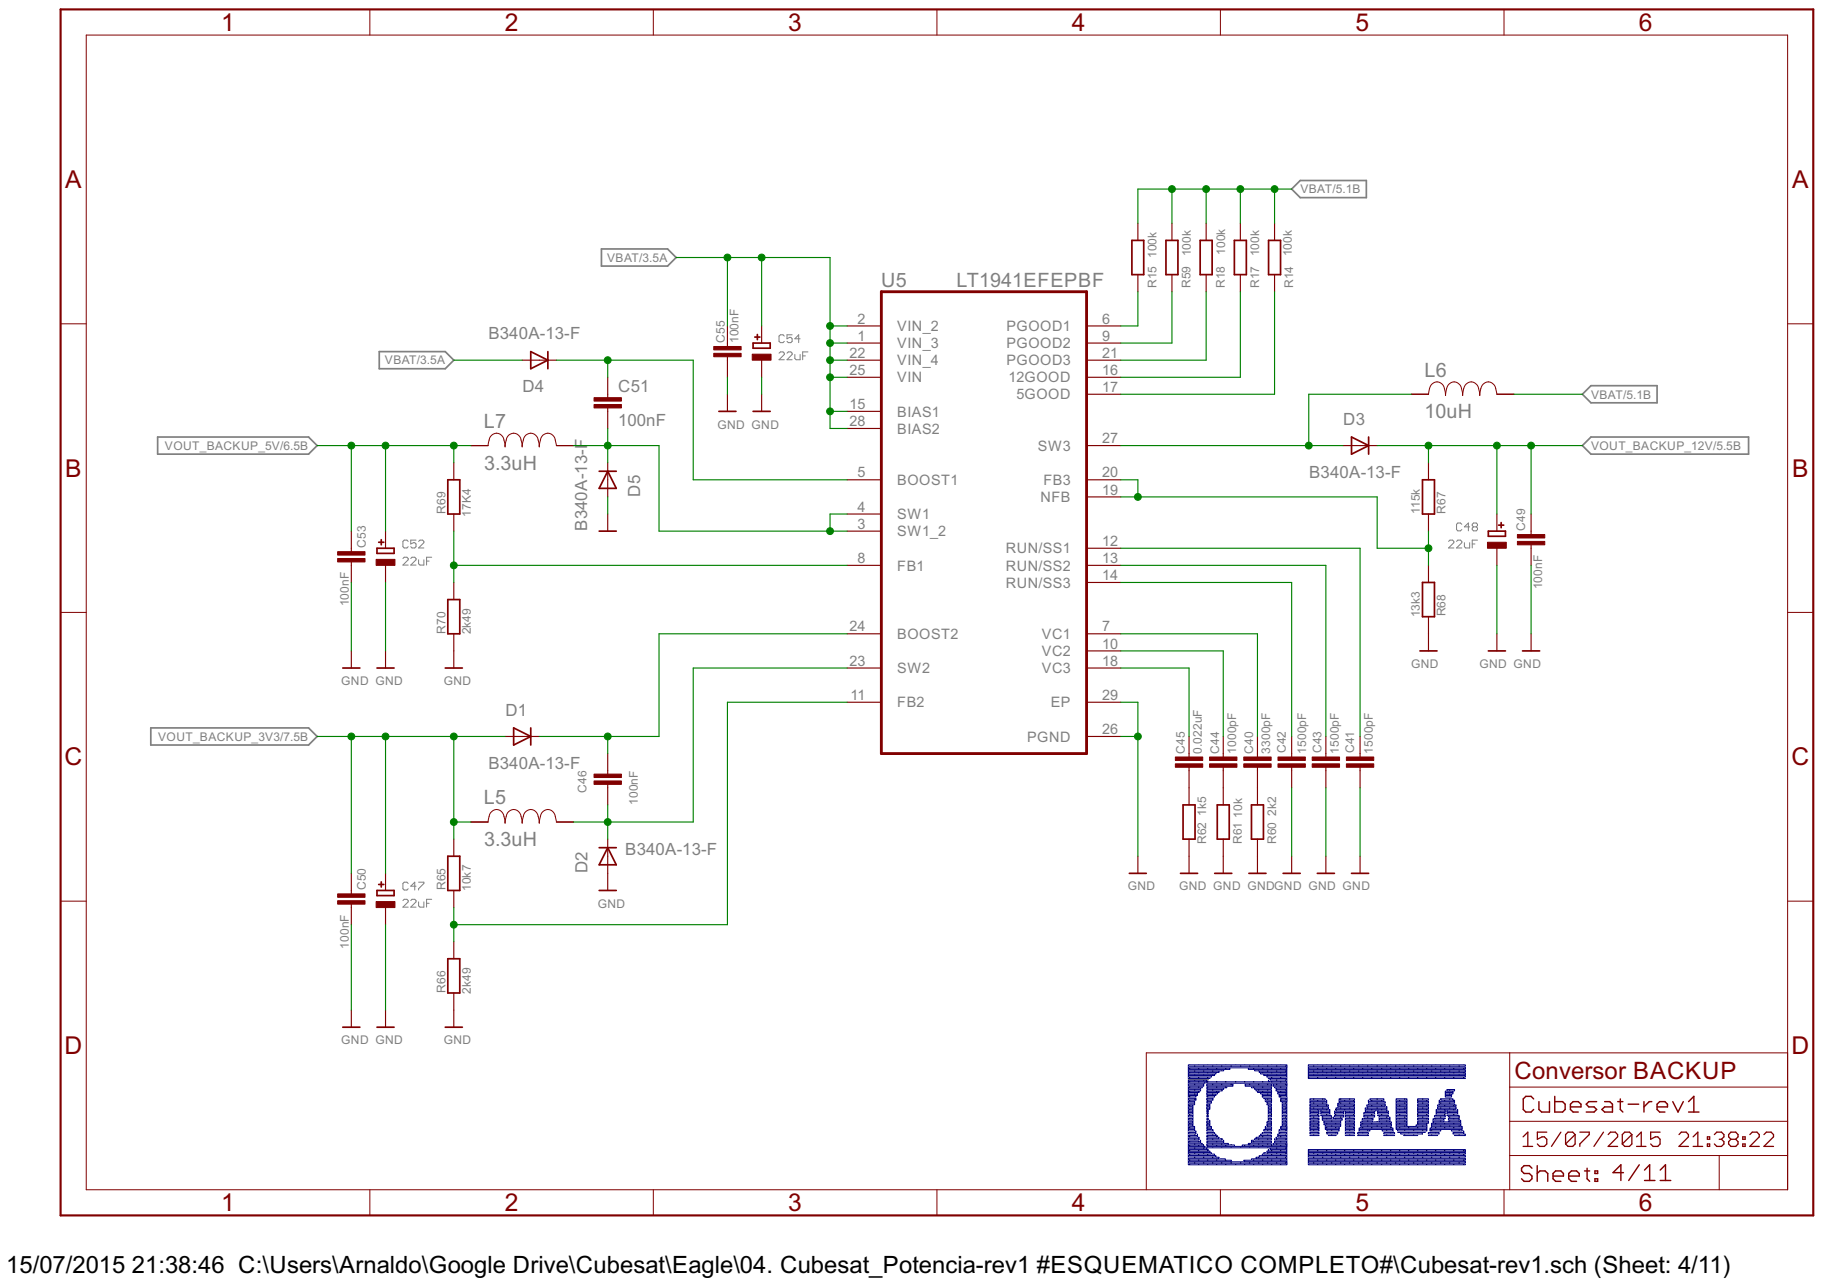
[picture p8: page 4]

15/07/2015 21:38:46 C:\Users\Arnaldo\Google Drive\Cubesat\Eagle\04. Cubesat_Potencia-rev1 #ESQUEMATICO COMPLETO#\Cubesat-rev1.sch (Sheet: 4/11)

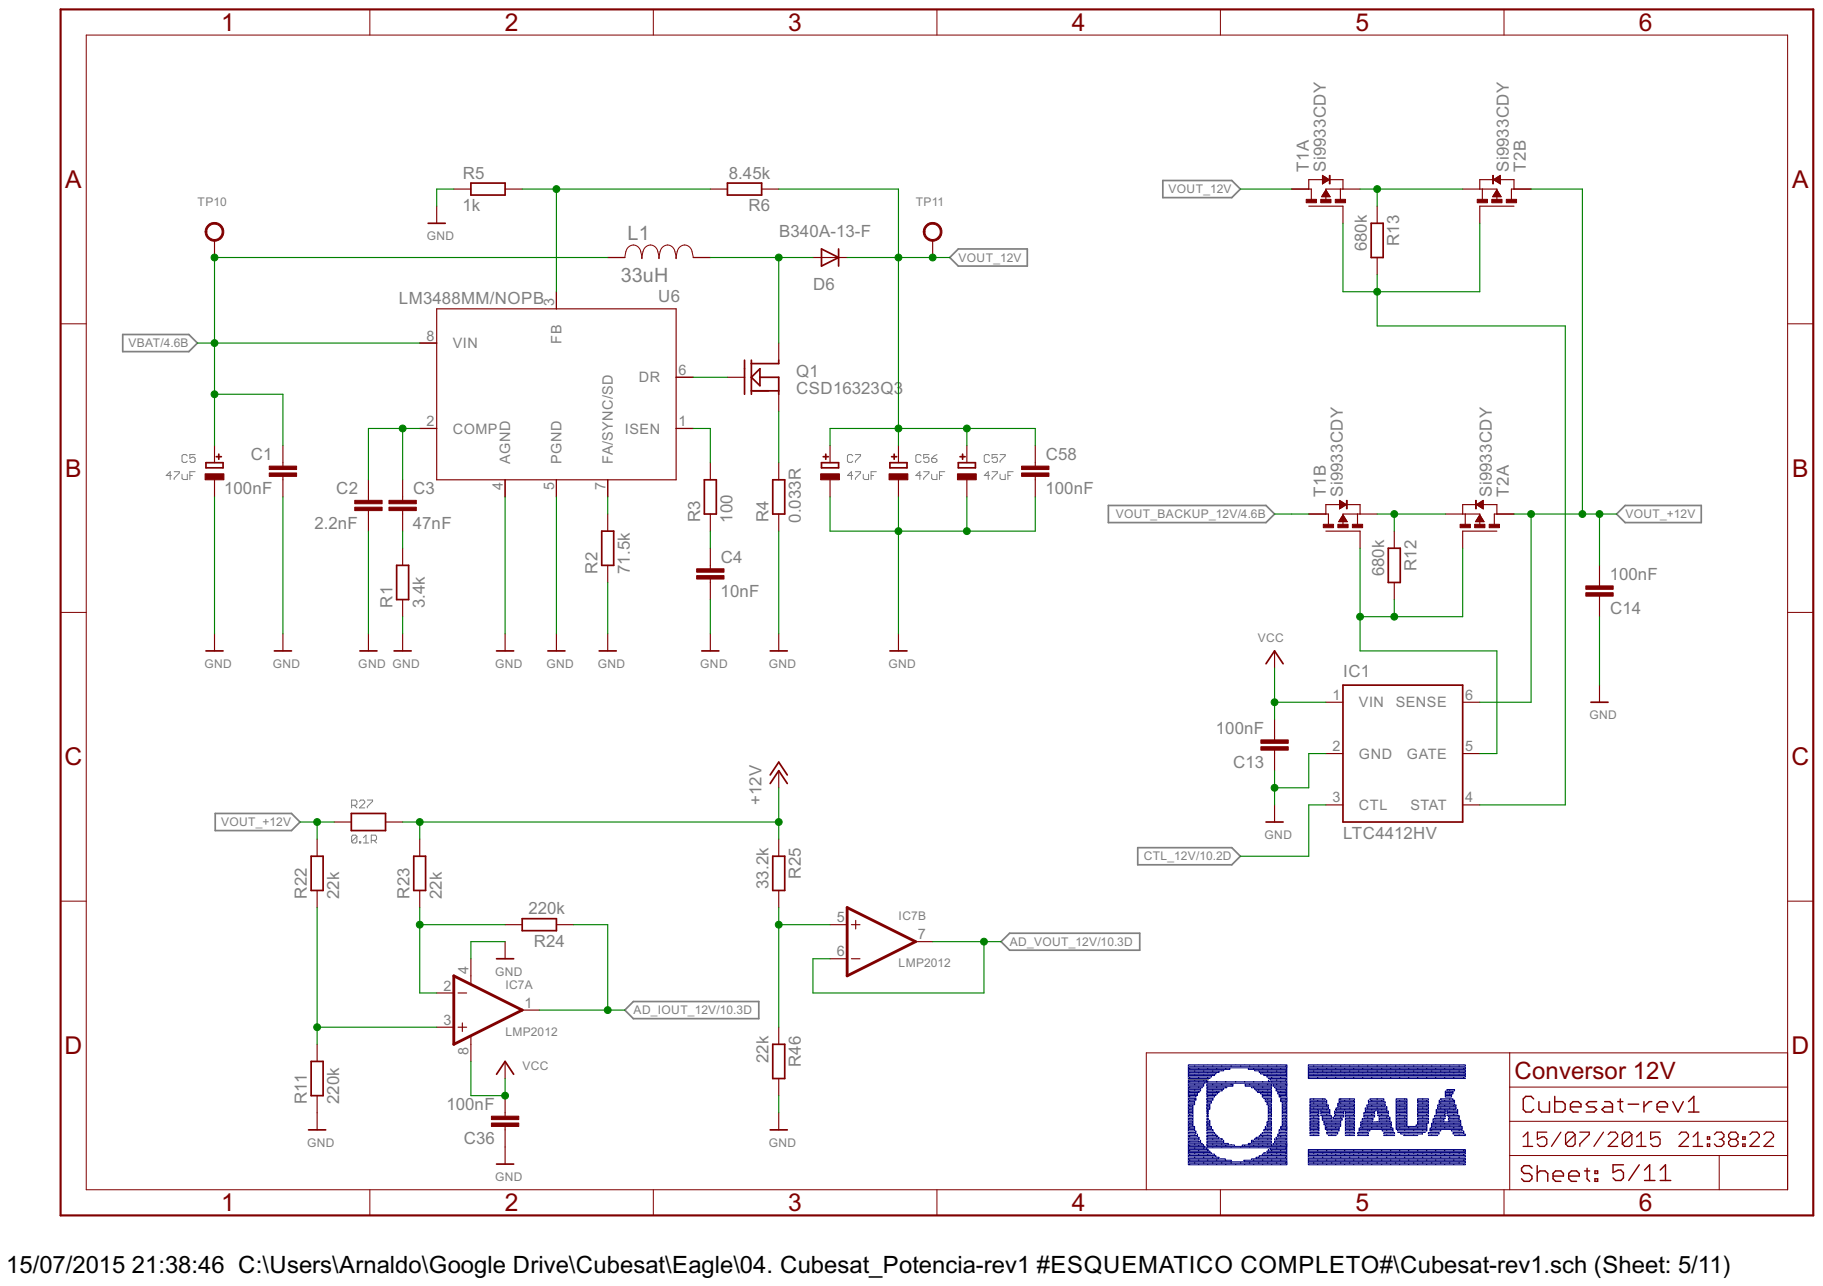
[picture p9: page 5]

15/07/2015 21:38:46 C:\Users\Arnaldo\Google Drive\Cubesat\Eagle\04. Cubesat_Potencia-rev1 #ESQUEMATICO COMPLETO#\Cubesat-rev1.sch (Sheet: 5/11)

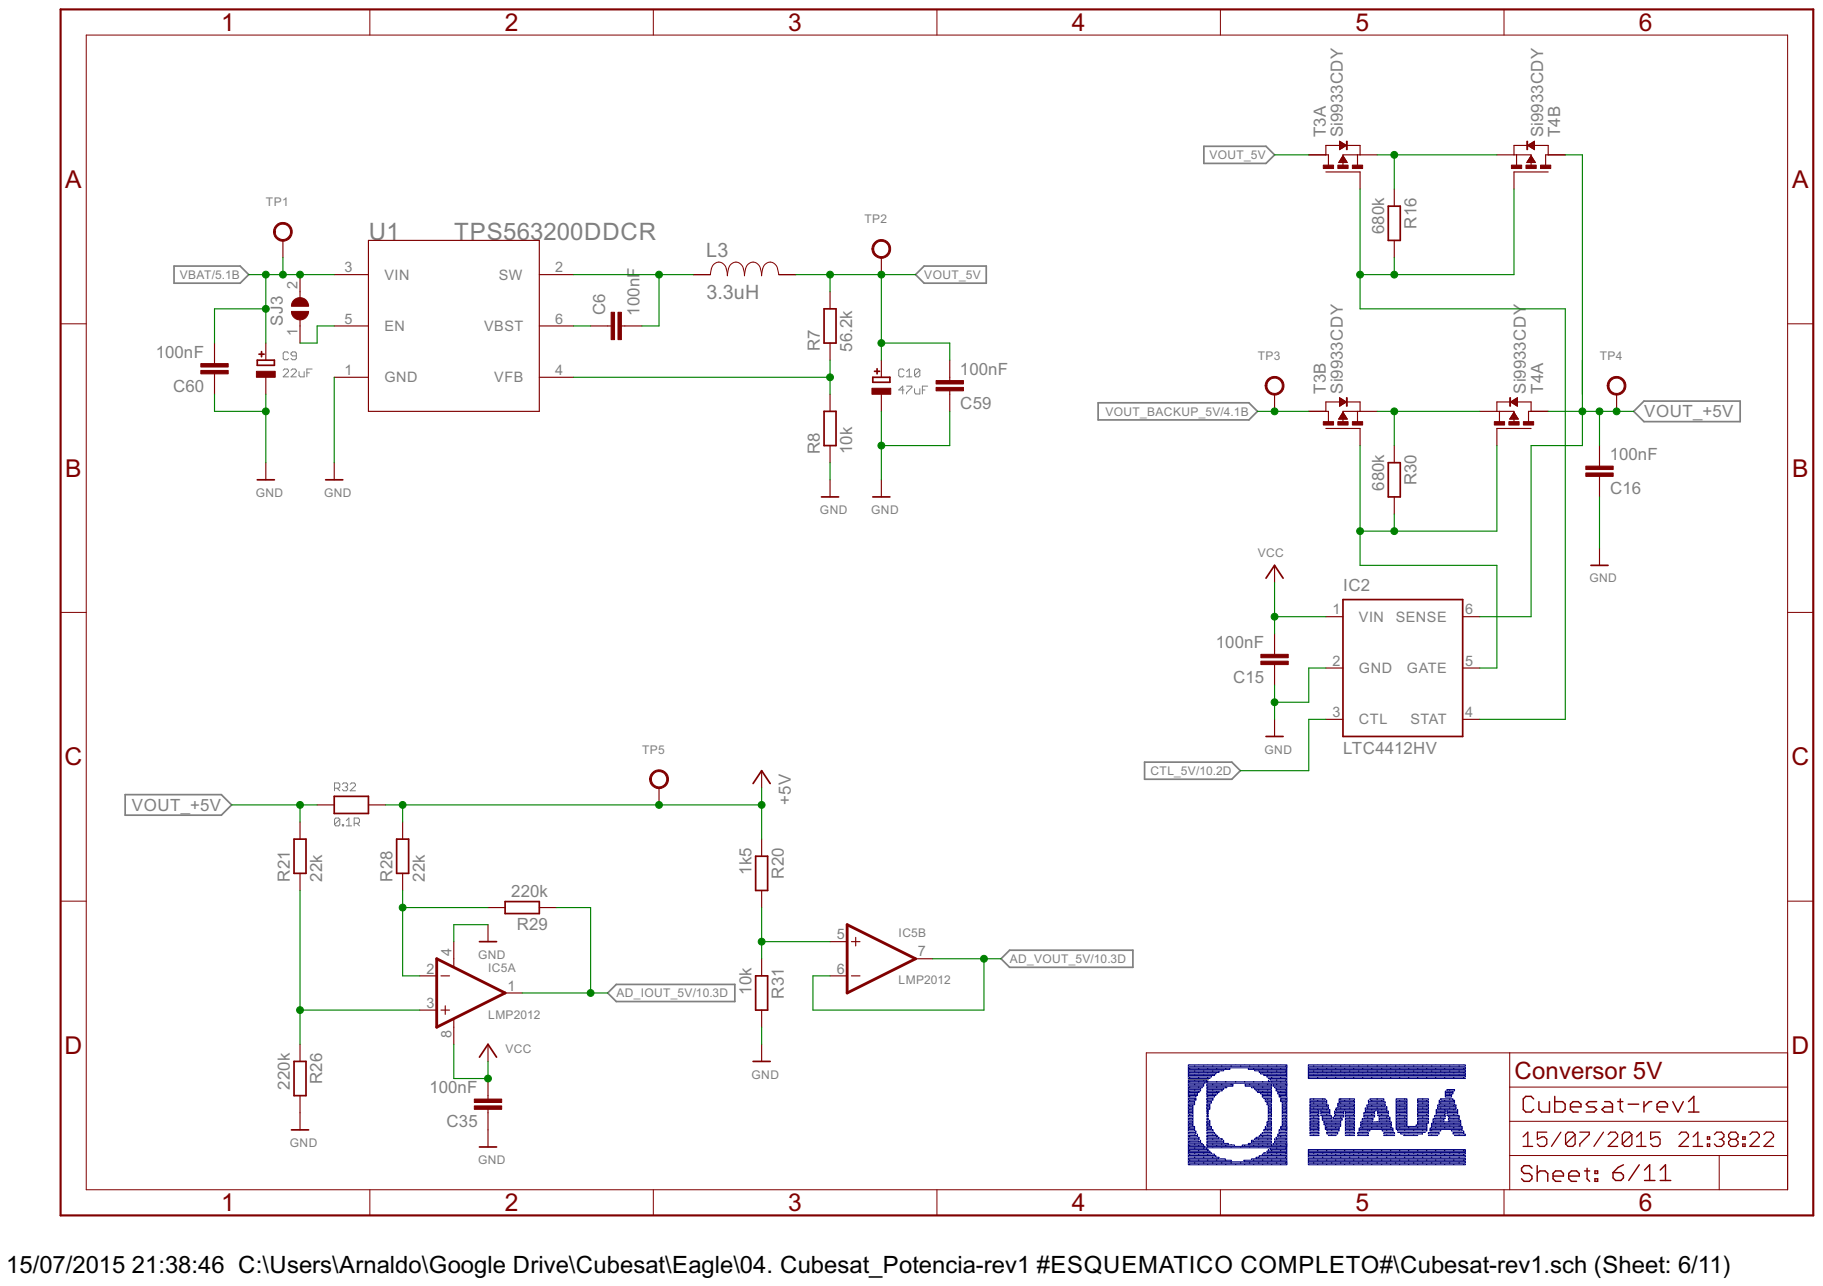
[picture p10: page 6]

15/07/2015 21:38:46 C:\Users\Arnaldo\Google Drive\Cubesat\Eagle\04. Cubesat_Potencia-rev1 #ESQUEMATICO COMPLETO#\Cubesat-rev1.sch (Sheet: 6/11)

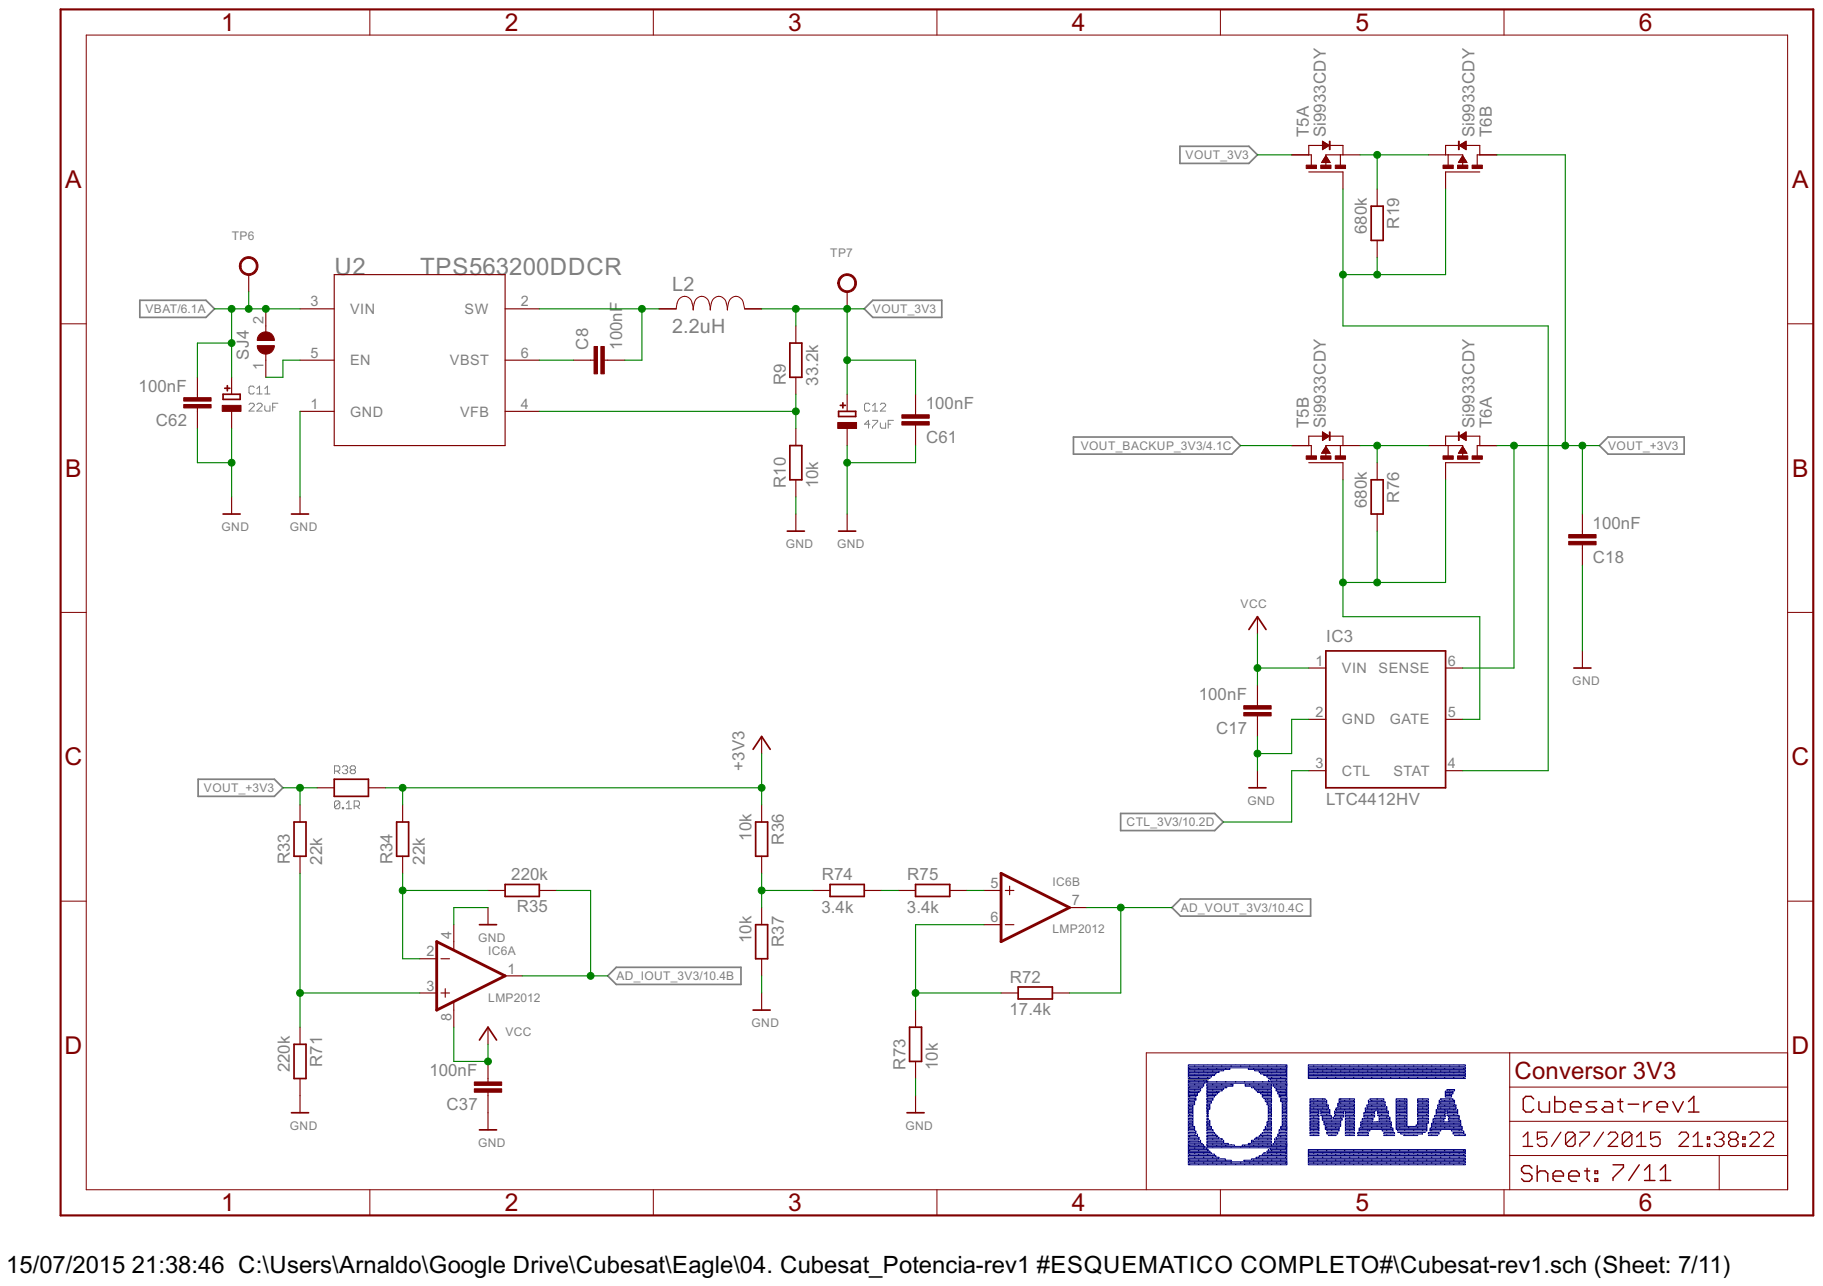
[picture p11: page 7]

15/07/2015 21:38:46 C:\Users\Arnaldo\Google Drive\Cubesat\Eagle\04. Cubesat_Potencia-rev1 #ESQUEMATICO COMPLETO#\Cubesat-rev1.sch (Sheet: 7/11)

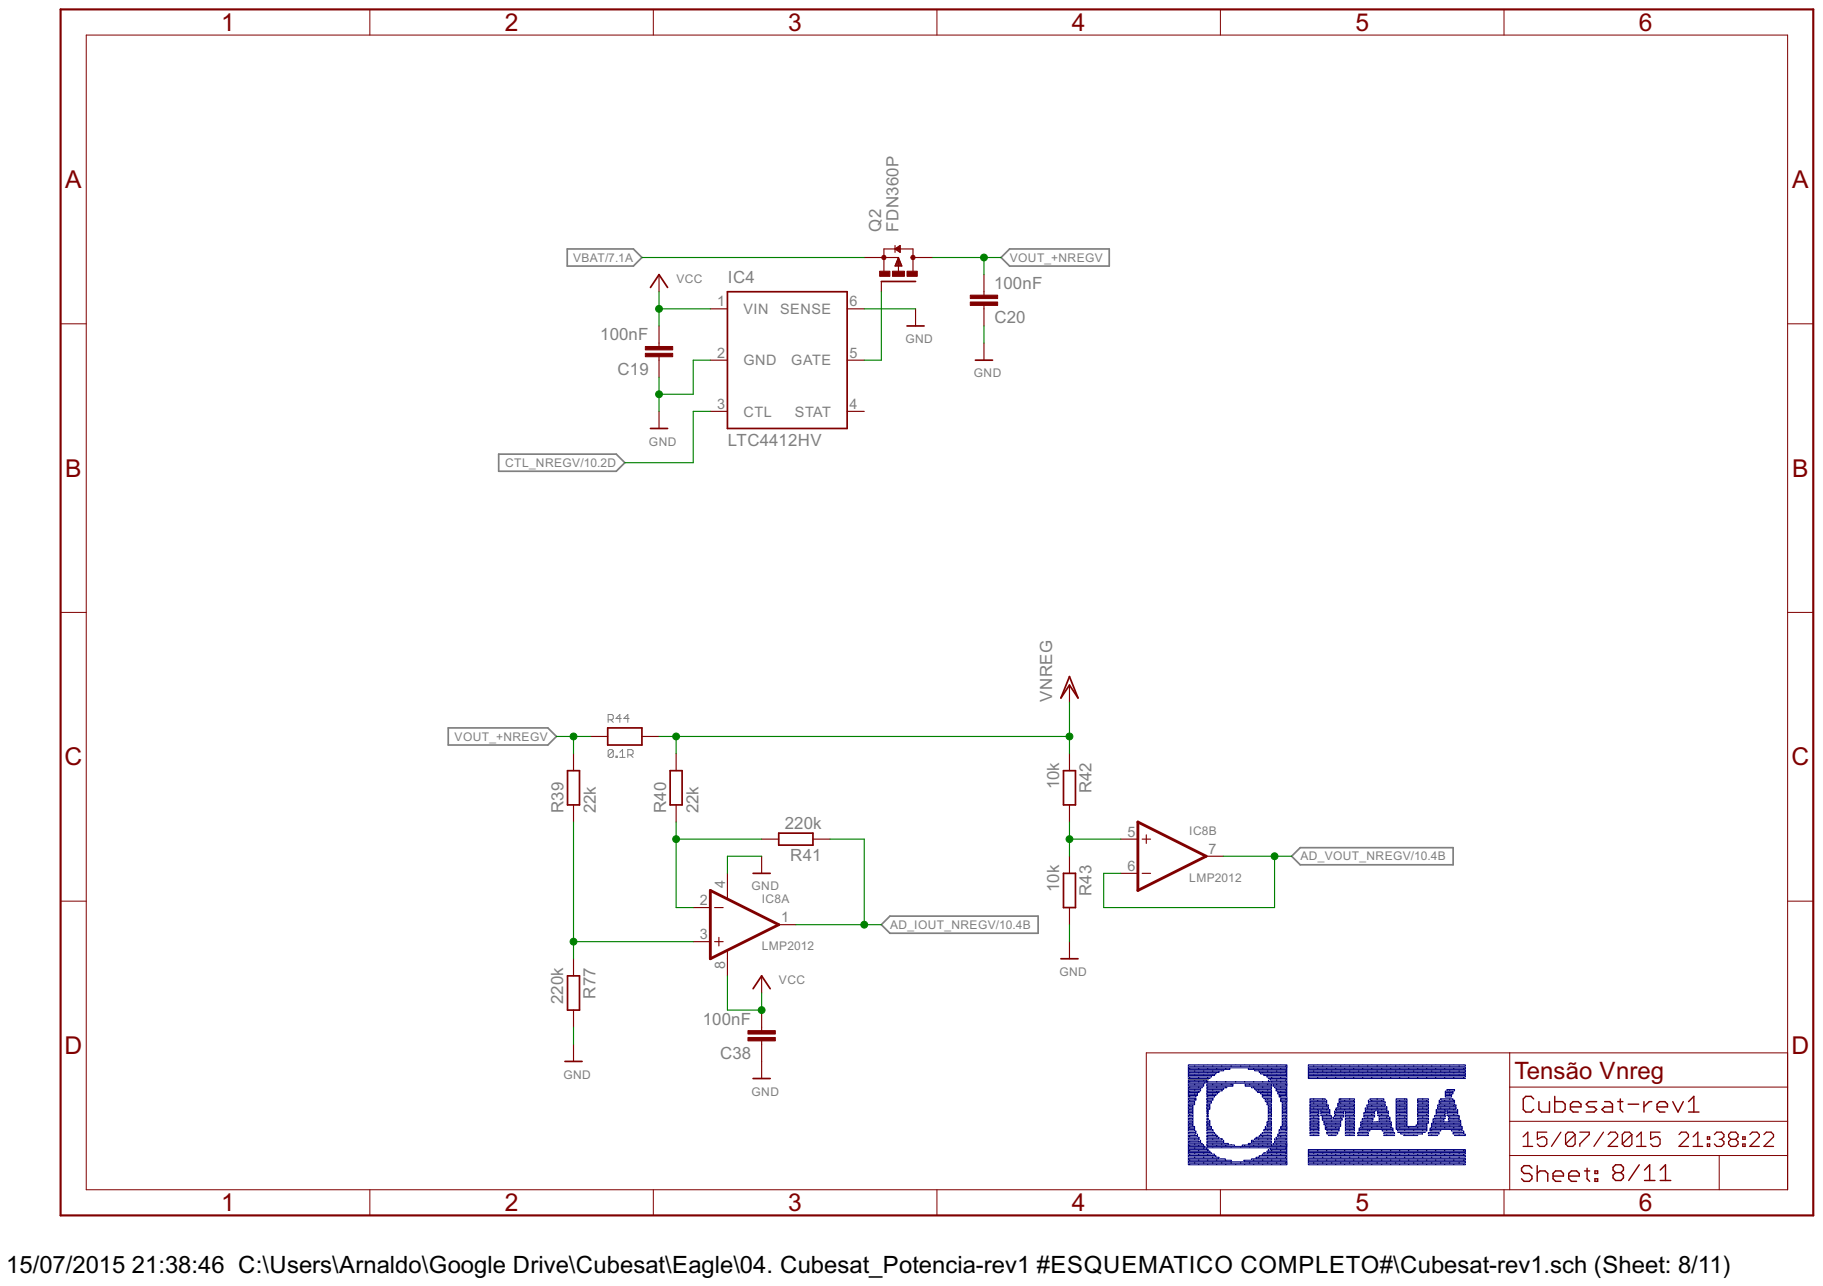
[picture p12: page 8]

15/07/2015 21:38:46 C:\Users\Arnaldo\Google Drive\Cubesat\Eagle\04. Cubesat_Potencia-rev1 #ESQUEMATICO COMPLETO#\Cubesat-rev1.sch (Sheet: 8/11)

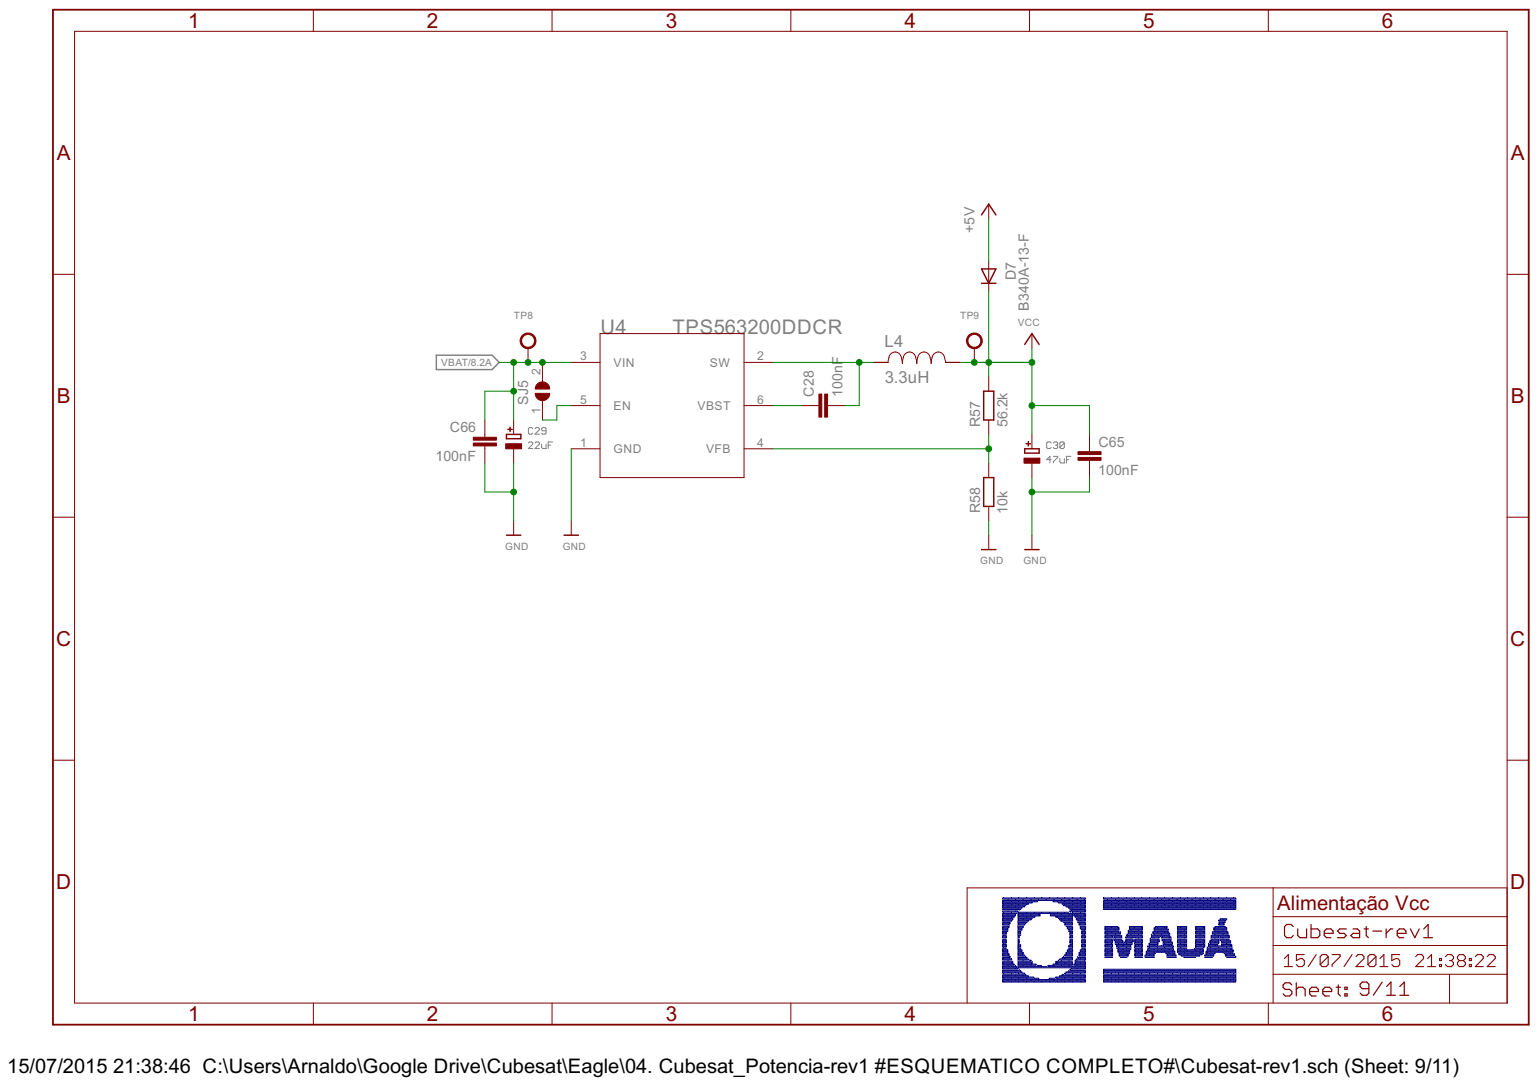
[picture p13: page 9]

15/07/2015 21:38:46 C:\Users\Arnaldo\Google Drive\Cubesat\Eagle\04. Cubesat_Potencia-rev1 #ESQUEMATICO COMPLETO#\Cubesat-rev1.sch (Sheet: 9/11)

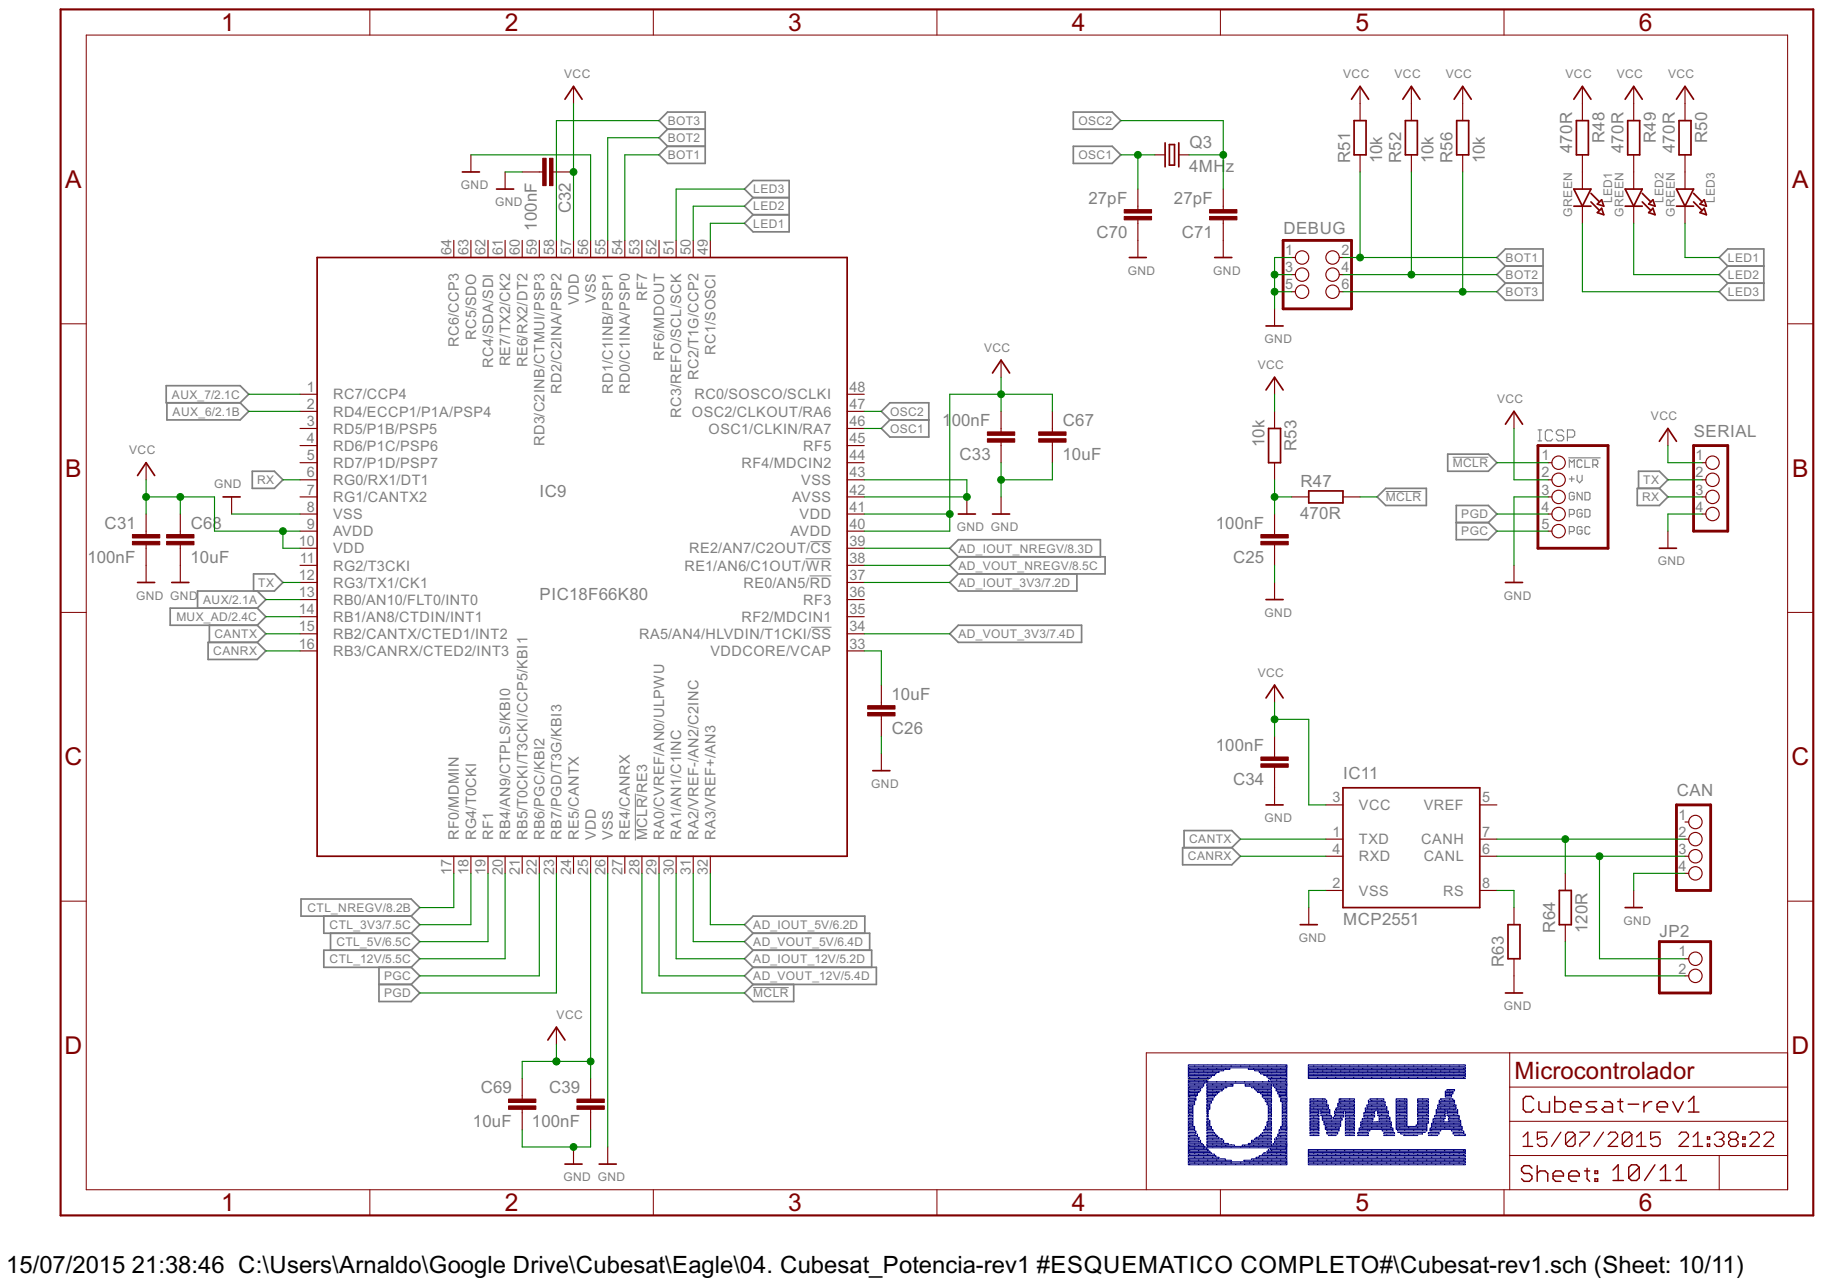
[picture p14: page 10]

VCC

15/07/2015 21:38:46 C:\Users\Arnaldo\Google Drive\Cubesat\Eagle\04. Cubesat_Potencia-rev1 #ESQUEMATICO COMPLETO#\Cubesat-rev1.sch (Sheet: 10/11)

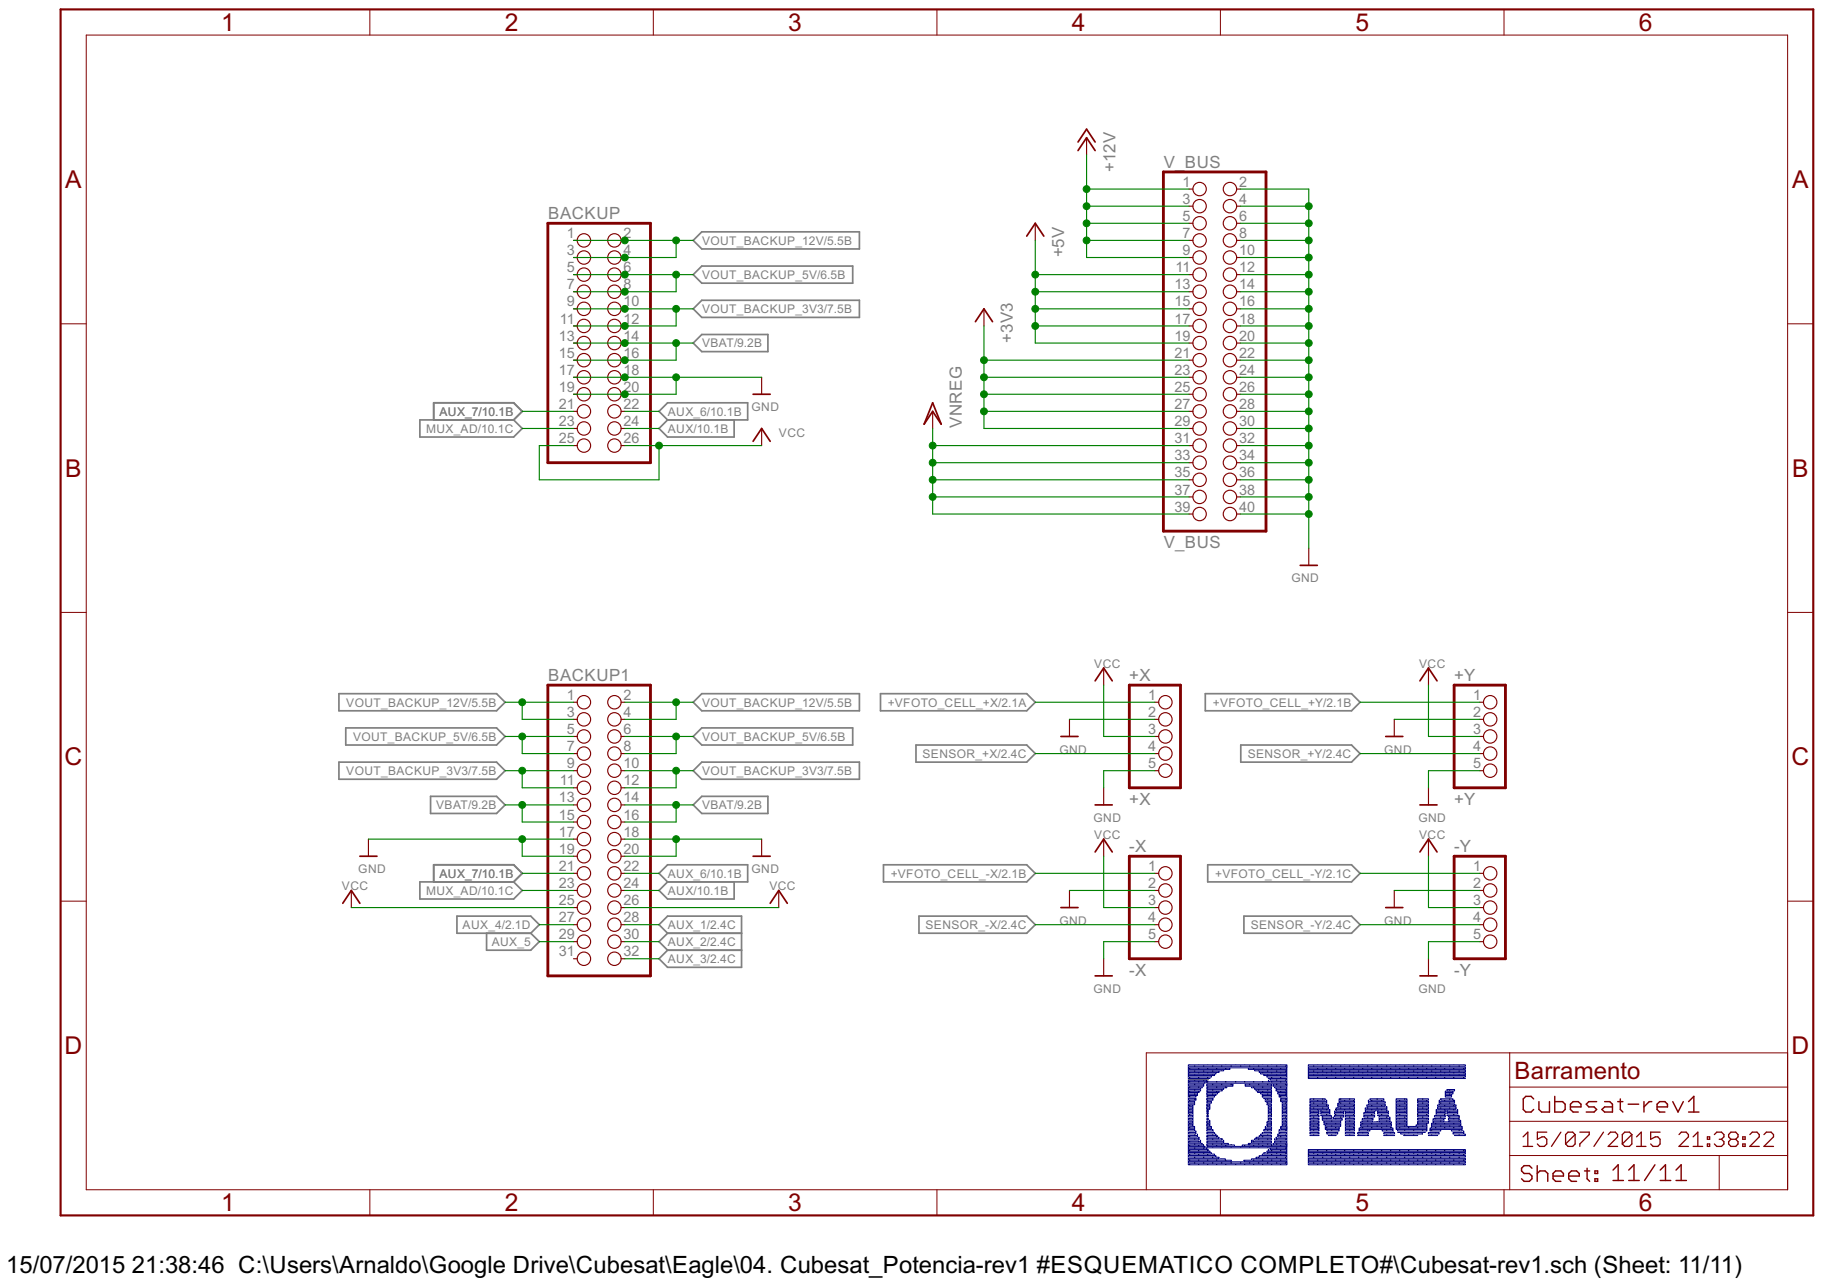
[picture p15: page 11]

15/07/2015 21:38:46 C:\Users\Arnaldo\Google Drive\Cubesat\Eagle\04. Cubesat_Potencia-rev1 #ESQUEMATICO COMPLETO#\Cubesat-rev1.sch (Sheet: 11/11)
