arnaldojr/Cubesat/06. Cubesat_Potencia_Backup-rev1/Cubesat_Potencia_Backup-rev2.brd

## EAGLE design 06. Cubesat_Potencia_Backup-rev1/Cubesat_Potencia_Backup-rev2.brd (2018-11-02)

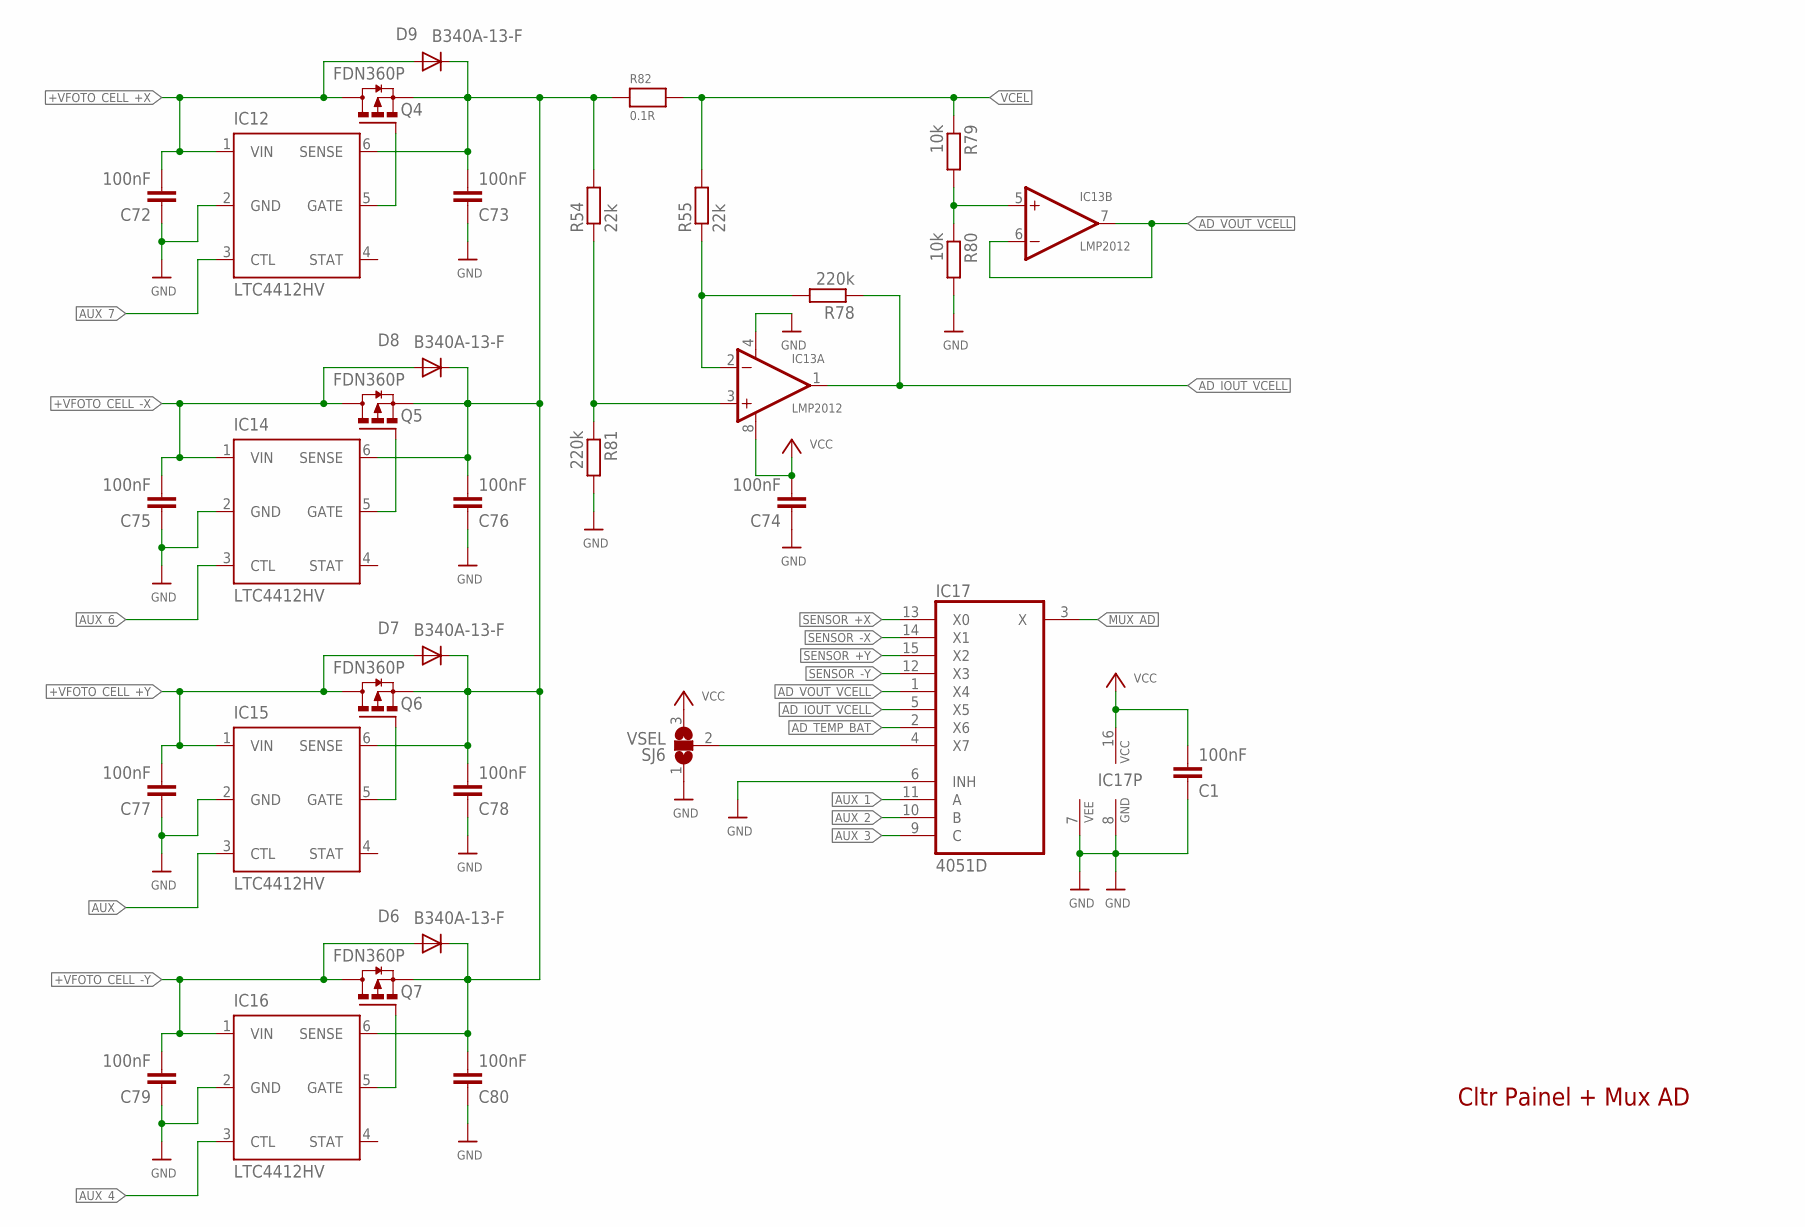
[picture p16: schematic Cubesat_Potencia_Backup-rev2.sch, sheet 1, Controle Painel Solar+ Mux AD]

Parts:
C1, C72, C73, C74, C75, C76, C77, C78, C79, C80: 100nF; C0805
D6, D7, D8, D9: B340A-13-F; DO214AC
IC12, IC14, IC15, IC16: LTC4412HV; TSOT23-6
IC13: LMP2012; MSOP08; MPN OPA2237EA/250
IC17: 4051D; SO16
Q4, Q5, Q6, Q7: FDN360P; SUPER-SOT3
R54, R55: 22k; M0805
R78, R81: 220k; M0805
R79, R80: 10k; M0805
R82: 0.1R; _2818
SJ6: VSEL; SJ_2

Connections:
+VFOTO_CELL_+X: C72.2, D9.A, IC12.1 (VIN), Q4.3 (D); also elsewhere on the board
+VFOTO_CELL_+Y: C77.2, D7.A, IC15.1 (VIN), Q6.3 (D); also elsewhere on the board
+VFOTO_CELL_-X: C75.2, D8.A, IC14.1 (VIN), Q5.3 (D); also elsewhere on the board
+VFOTO_CELL_-Y: C79.2, D6.A, IC16.1 (VIN), Q7.3 (D); also elsewhere on the board
AD_IOUT_VCELL: IC13.1 (OUT), IC17.5 (X5), R78.1
AD_TEMP_BAT: IC17.2 (X6); also elsewhere on the board
AD_VOUT_VCELL: IC13.6 (-IN), IC13.7 (OUT), IC17.1 (X4)
AUX: IC15.3 (CTL); also elsewhere on the board
AUX_1: IC17.11 (A); also elsewhere on the board
AUX_2: IC17.10 (B); also elsewhere on the board
AUX_3: IC17.9 (C); also elsewhere on the board
AUX_4: IC16.3 (CTL); also elsewhere on the board
AUX_6: IC14.3 (CTL); also elsewhere on the board
AUX_7: IC12.3 (CTL); also elsewhere on the board
GND: C1.1, C72.1, C73.1, C74.1, C75.1, C76.1, C77.1, C78.1, C79.1, C80.1, IC12.2 (GND), IC13.4 (V-), IC14.2 (GND), IC15.2 (GND), IC16.2 (GND), IC17.6 (INH), IC17.7 (VEE), IC17.8 (GND), R80.2, R81.2, SJ6.1; also elsewhere on the board
MUX_AD: IC17.3 (X); also elsewhere on the board
unnamed: IC12.5 (GATE), Q4.1 (G)
unnamed: IC13.5 (+IN), R79.2, R80.1
unnamed: IC13.2 (-IN), R55.1, R78.2
unnamed: IC13.3 (+IN), R54.1, R81.1
unnamed: C73.2, C76.2, C78.2, C80.2, D6.C, D7.C, D8.C, D9.C, IC12.6 (SENSE), IC14.6 (SENSE), IC15.6 (SENSE), IC16.6 (SENSE), Q4.2 (S), Q5.2 (S), Q6.2 (S), Q7.2 (S), R54.2, R82.1
unnamed: IC17.4 (X7), SJ6.2
unnamed: IC14.5 (GATE), Q5.1 (G)
unnamed: IC15.5 (GATE), Q6.1 (G)
unnamed: IC16.5 (GATE), Q7.1 (G)
SENSOR_+X: IC17.13 (X0); also elsewhere on the board
SENSOR_+Y: IC17.15 (X2); also elsewhere on the board
SENSOR_-X: IC17.14 (X1); also elsewhere on the board
SENSOR_-Y: IC17.12 (X3); also elsewhere on the board
VCC: C1.2, C74.2, IC13.8 (V+), IC17.16 (VCC), SJ6.3; also elsewhere on the board
VCEL: R55.2, R79.1, R82.2; also elsewhere on the board

Notes on the sheet:
Cltr Painel + Mux AD

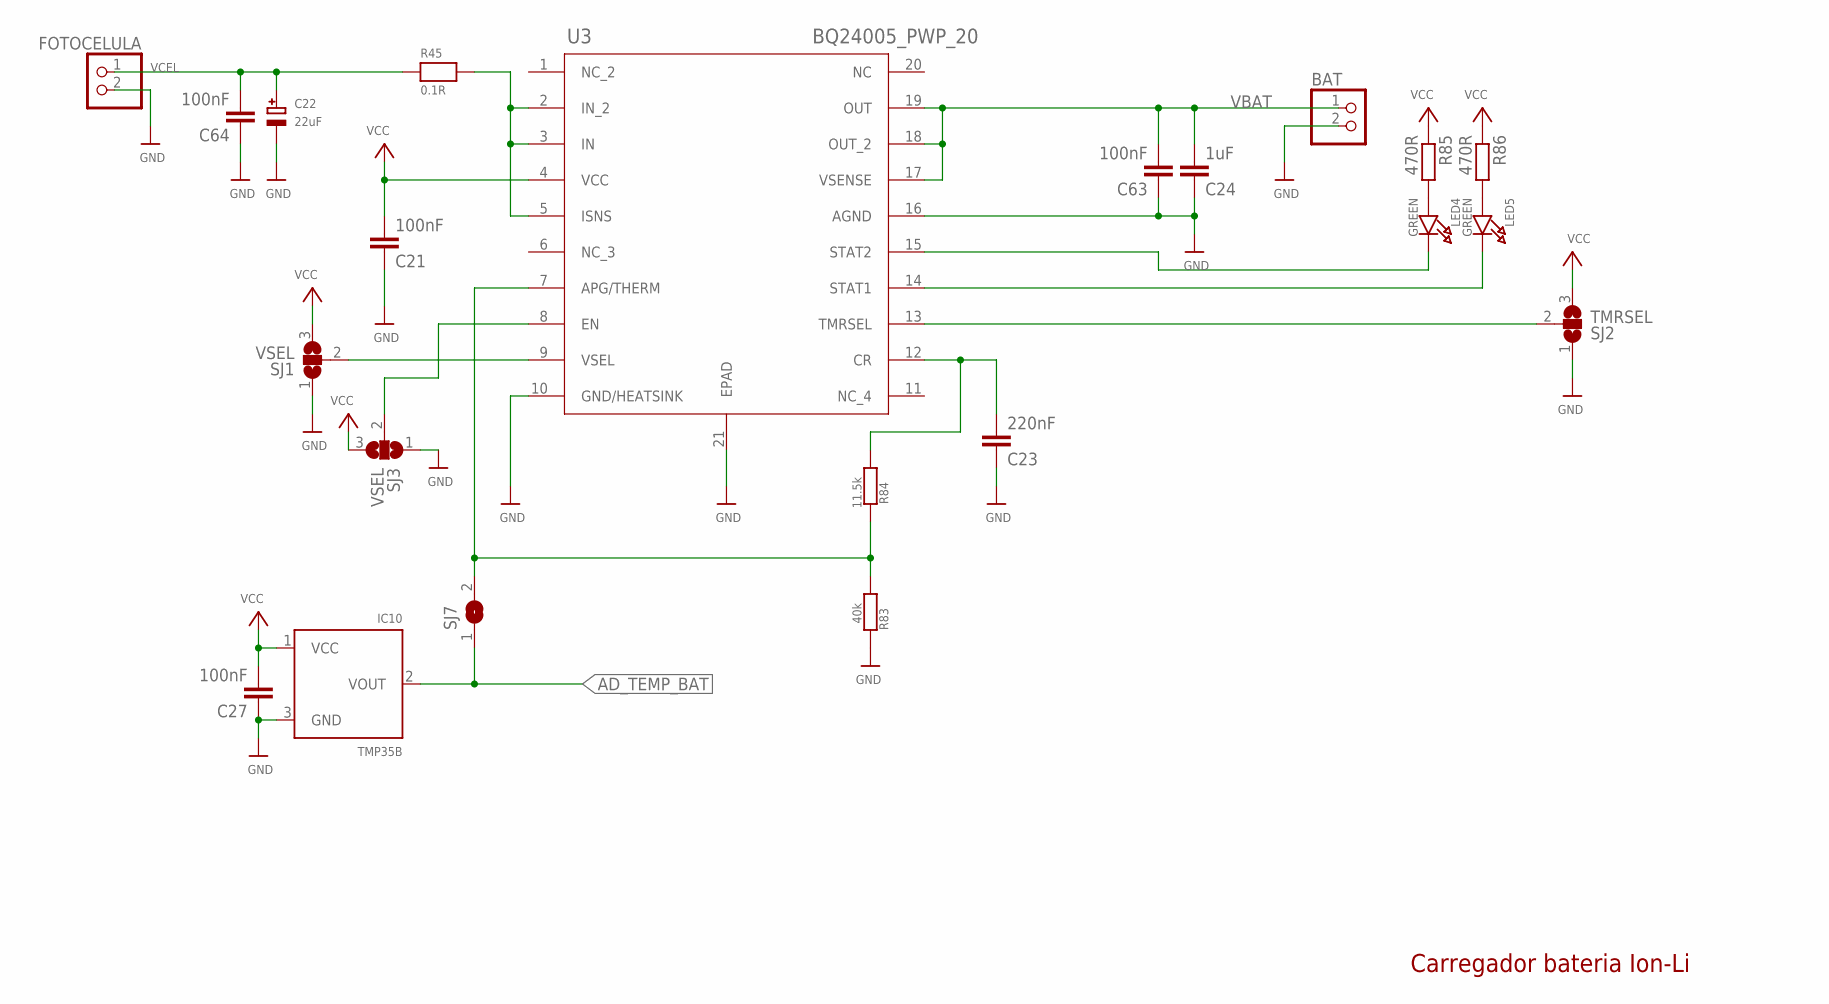
[picture p17: schematic Cubesat_Potencia_Backup-rev2.sch, sheet 2, Carregador de Bateria]

Parts:
BAT: HEADER-1X2; 1X02_OVAL
C21, C27, C63, C64: 100nF; C0805
C22: 22uF; EIA6032-28/C-R
C23: 220nF; C0805
C24: 1uF; C0805
FOTOCELULA: HEADER-1X2; 1X02_OVAL
IC10: TMP35B; TO92-LINE
LED4, LED5: GREEN; CHIPLED_0805
R45: 0.1R; _2818
R83: 40k; M0805
R84: 11.5k; M0805
R85, R86: 470R; M0805
SJ1, SJ3: VSEL; SJ_2
SJ2: TMRSEL; SJ_2
SJ7: SOLDERJUMPER; SOLDERJUMPER_ARROW_NOPASTE
U3: BQ24005_PWP_20; PWP20_2P4X3P4

Connections:
AD_TEMP_BAT: IC10.2 (VOUT), SJ7.1; also elsewhere on the board
GND: BAT.2, C21.1, C22.-, C23.1, C24.1, C27.1, C63.1, C64.1, FOTOCELULA.2, IC10.3 (GND), R83.2, SJ1.1, SJ2.1, SJ3.1, U3.10 (GND/HEATSINK), U3.16 (AGND), U3.21 (EPAD); also elsewhere on the board
unnamed: SJ3.2, U3.8 (EN)
unnamed: R45.2, U3.2 (IN_2), U3.3 (IN), U3.5 (ISNS)
unnamed: SJ2.2, U3.13 (TMRSEL)
unnamed: SJ1.2, U3.9 (VSEL)
unnamed: C23.2, R84.1, U3.12 (CR)
unnamed: LED4.A, R85.2
unnamed: R83.1, R84.2, SJ7.2, U3.7 (APG/THERM)
unnamed: LED5.A, R86.2
unnamed: LED5.C, U3.14 (STAT1)
unnamed: LED4.C, U3.15 (STAT2)
VBAT: BAT.1, C24.2, C63.2, U3.17 (VSENSE), U3.18 (OUT_2), U3.19 (OUT); also elsewhere on the board
VCC: C21.2, C27.2, IC10.1 (VCC), R85.1, R86.1, SJ1.3, SJ2.3, SJ3.3, U3.4 (VCC); also elsewhere on the board
VCEL: C22.+, C64.2, FOTOCELULA.1, R45.1; also elsewhere on the board

Notes on the sheet:
Carregador bateria Ion-Li

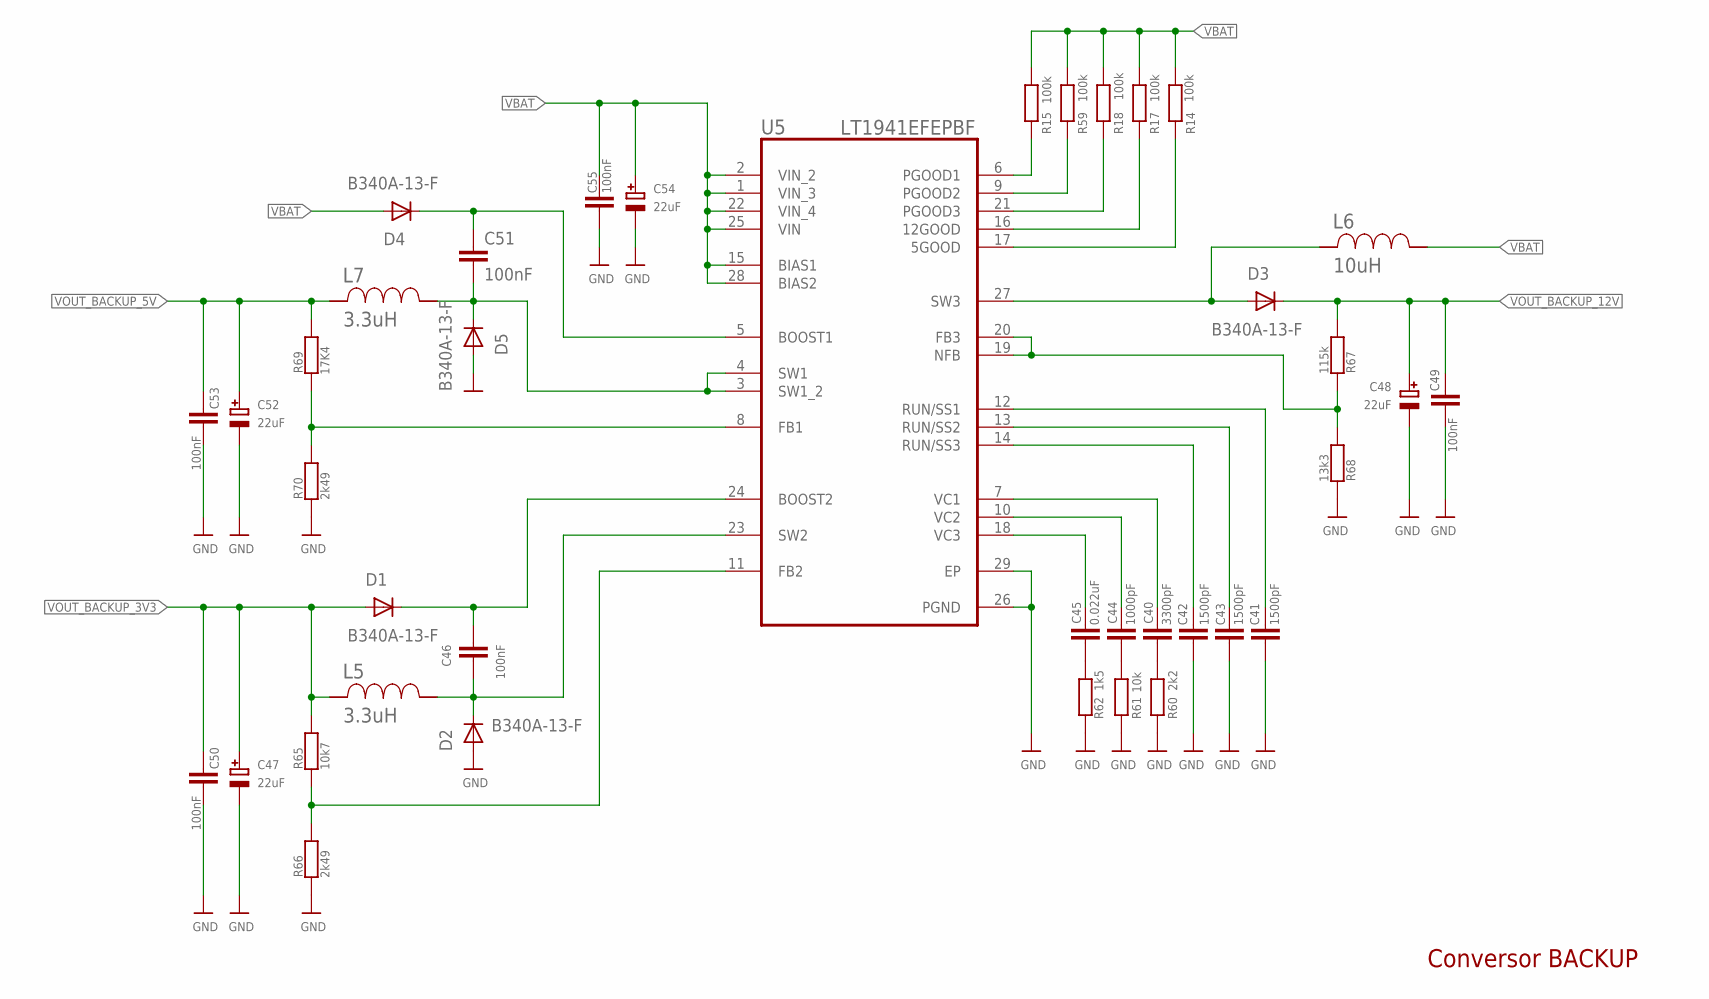
[picture p18: schematic Cubesat_Potencia_Backup-rev2.sch, sheet 3, Conversor BACKUP]

Parts:
C40: 3300pF; C0805
C41, C42, C43: 1500pF; C0805
C44: 1000pF; C0805
C45: 0.022uF; C0805
C46, C49, C50, C53, C55: 100nF; C0805
C47, C48, C52, C54: 22uF; EIA6032-28/C-R
C51: 100nF; C1210
D1, D2, D3, D4, D5: B340A-13-F; DO214AC
L5, L7: 3.3uH; SRR6038
L6: 10uH; SRR6038
R14, R15, R17, R18, R59: 100k; M0805
R60: 2k2; M0805
R61: 10k; M0805
R62: 1k5; M0805
R65: 10k7; M0805
R66, R70: 2k49; M0805
R67: 115k; M0805
R68: 13k3; M0805
R69: 17K4; M0805
U5: LT1941EFEPBF; SOP65P640X120-29N

Connections:
BOOST1: C51.1, D4.C, U5.5 (BOOST1)
FB1: R69.2, R70.1, U5.8 (FB1)
FB2: R65.2, R66.1, U5.11 (FB2)
FB3: R67.2, R68.1, U5.19 (NFB), U5.20 (FB3)
GND: C41.2, C42.2, C43.2, C47.-, C48.-, C49.2, C50.2, C52.-, C53.2, C54.-, C55.2, D2.A, D5.A, R60.1, R61.1, R62.1, R66.2, R68.2, R70.2, U5.26 (PGND), U5.29 (EP); also elsewhere on the board
unnamed: R14.2, U5.17 (5GOOD)
unnamed: R17.2, U5.16 (12GOOD)
unnamed: R18.2, U5.21 (PGOOD3)
unnamed: R59.2, U5.9 (PGOOD2)
unnamed: R15.2, U5.6 (PGOOD1)
unnamed: C41.1, U5.12 (RUN/SS1)
unnamed: C43.1, U5.13 (RUN/SS2)
unnamed: C42.1, U5.14 (RUN/SS3)
unnamed: C40.1, R60.2
unnamed: C44.2, U5.10 (VC2)
unnamed: C45.2, U5.18 (VC3)
unnamed: C44.1, R61.2
unnamed: C45.1, R62.2
unnamed: C40.2, U5.7 (VC1)
unnamed: C46.1, D1.C, U5.24 (BOOST2)
SW1: C51.2, D5.C, L7.2, U5.3 (SW1_2), U5.4 (SW1)
SW2: C46.2, D2.C, L5.2, U5.23 (SW2)
SW3: D3.A, L6.1, U5.27 (SW3)
VBAT: C54.+, C55.1, D4.A, L6.2, R14.1, R15.1, R17.1, R18.1, R59.1, U5.1 (VIN_3), U5.2 (VIN_2), U5.15 (BIAS1), U5.22 (VIN_4), U5.25 (VIN), U5.28 (BIAS2); also elsewhere on the board
VOUT_BACKUP_3V3: C47.+, C50.1, D1.A, L5.1, R65.1; also elsewhere on the board
VOUT_BACKUP_5V: C52.+, C53.1, L7.1, R69.1; also elsewhere on the board
VOUT_BACKUP_12V: C48.+, C49.1, D3.C, R67.1; also elsewhere on the board

Notes on the sheet:
Conversor BACKUP

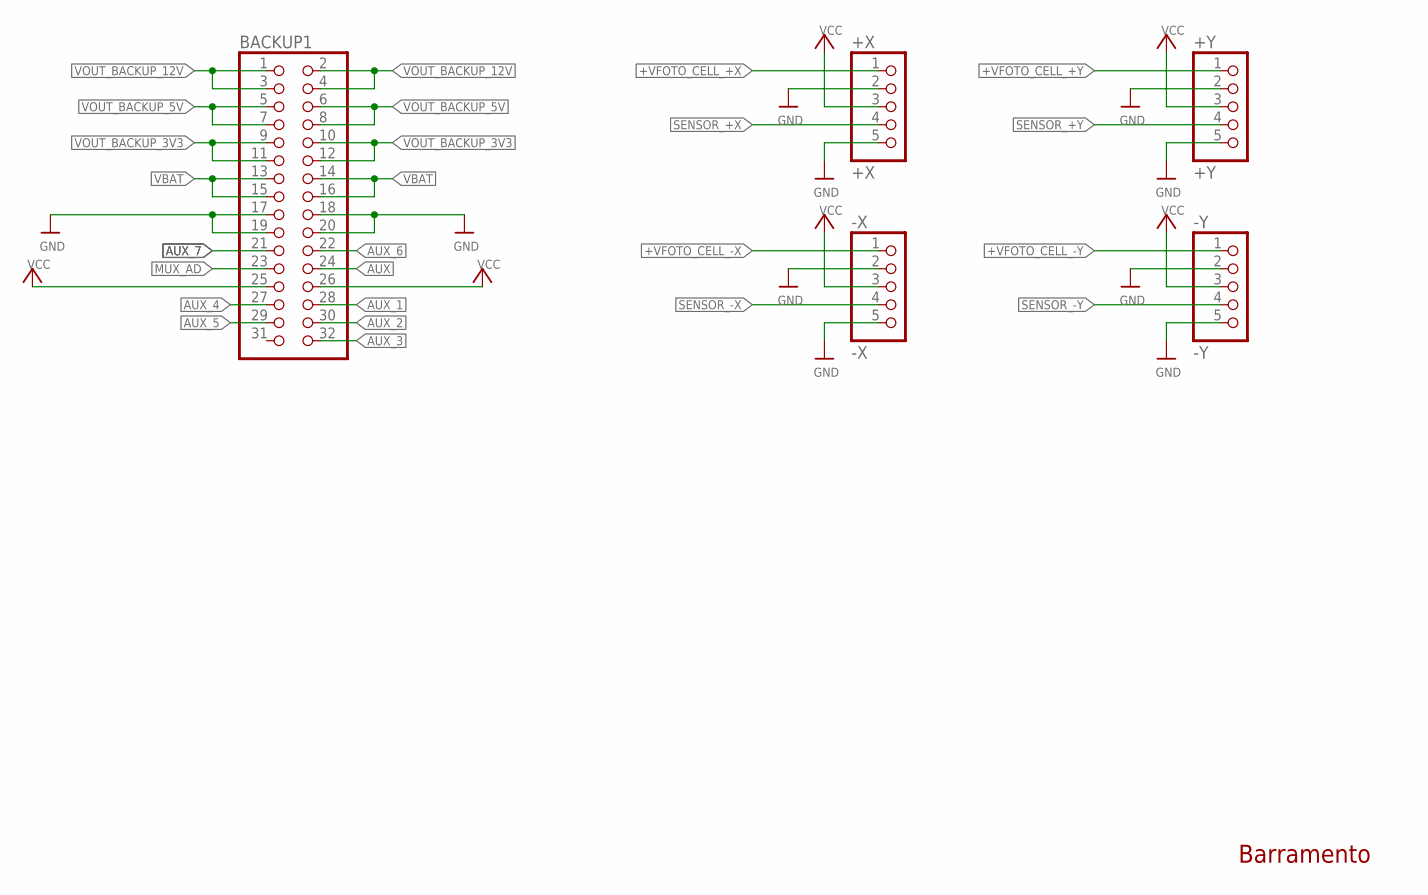
[picture p19: schematic Cubesat_Potencia_Backup-rev2.sch, sheet 4, Barramento]

Parts:
+X: +X; 1X05
+Y: +Y; 1X05
-X: -X; 1X05
-Y: -Y; 1X05
BACKUP1: PINHD-2X16; 2X16

Connections:
+VFOTO_CELL_+X: +X.1; also elsewhere on the board
+VFOTO_CELL_+Y: +Y.1; also elsewhere on the board
+VFOTO_CELL_-X: -X.1; also elsewhere on the board
+VFOTO_CELL_-Y: -Y.1; also elsewhere on the board
AUX: BACKUP1.24; also elsewhere on the board
AUX_1: BACKUP1.28; also elsewhere on the board
AUX_2: BACKUP1.30; also elsewhere on the board
AUX_3: BACKUP1.32; also elsewhere on the board
AUX_4: BACKUP1.27; also elsewhere on the board
AUX_5: BACKUP1.29
AUX_6: BACKUP1.22; also elsewhere on the board
AUX_7: BACKUP1.21; also elsewhere on the board
GND: +X.2, +X.5, +Y.2, +Y.5, -X.2, -X.5, -Y.2, -Y.5, BACKUP1.17, BACKUP1.18, BACKUP1.19, BACKUP1.20; also elsewhere on the board
MUX_AD: BACKUP1.23; also elsewhere on the board
SENSOR_+X: +X.4; also elsewhere on the board
SENSOR_+Y: +Y.4; also elsewhere on the board
SENSOR_-X: -X.4; also elsewhere on the board
SENSOR_-Y: -Y.4; also elsewhere on the board
VBAT: BACKUP1.13, BACKUP1.14, BACKUP1.15, BACKUP1.16; also elsewhere on the board
VCC: +X.3, +Y.3, -X.3, -Y.3, BACKUP1.25, BACKUP1.26; also elsewhere on the board
VOUT_BACKUP_3V3: BACKUP1.9, BACKUP1.10, BACKUP1.11, BACKUP1.12; also elsewhere on the board
VOUT_BACKUP_5V: BACKUP1.5, BACKUP1.6, BACKUP1.7, BACKUP1.8; also elsewhere on the board
VOUT_BACKUP_12V: BACKUP1.1, BACKUP1.2, BACKUP1.3, BACKUP1.4; also elsewhere on the board

Notes on the sheet:
Barramento

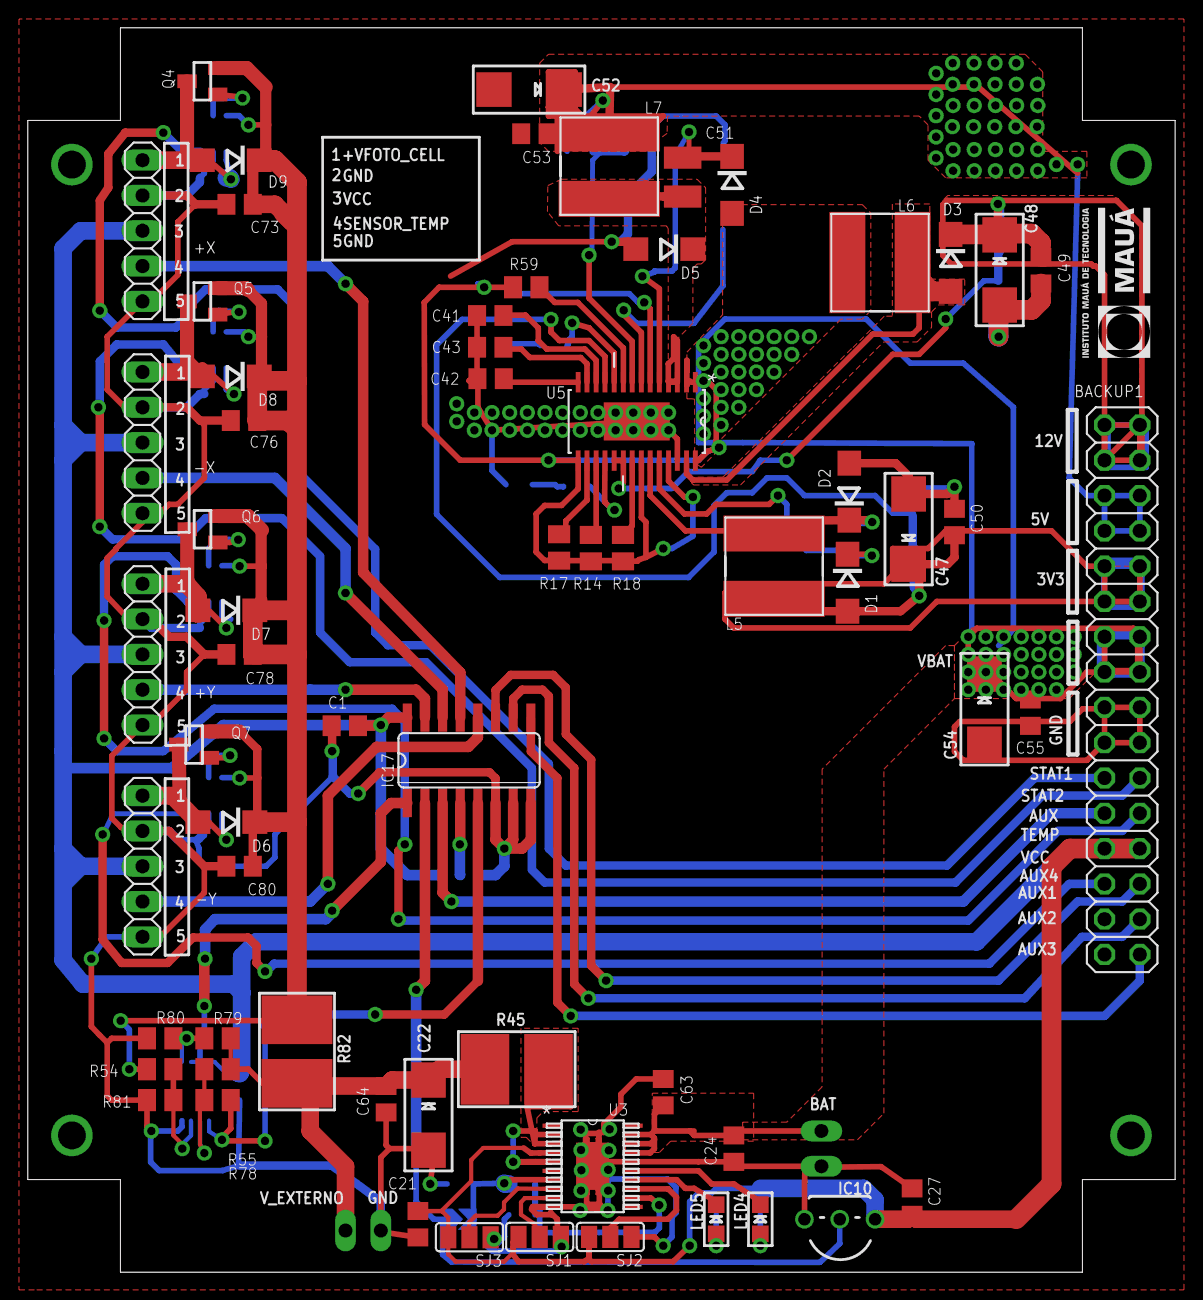
[picture p20: board Cubesat_Potencia_Backup-rev2.brd from above]

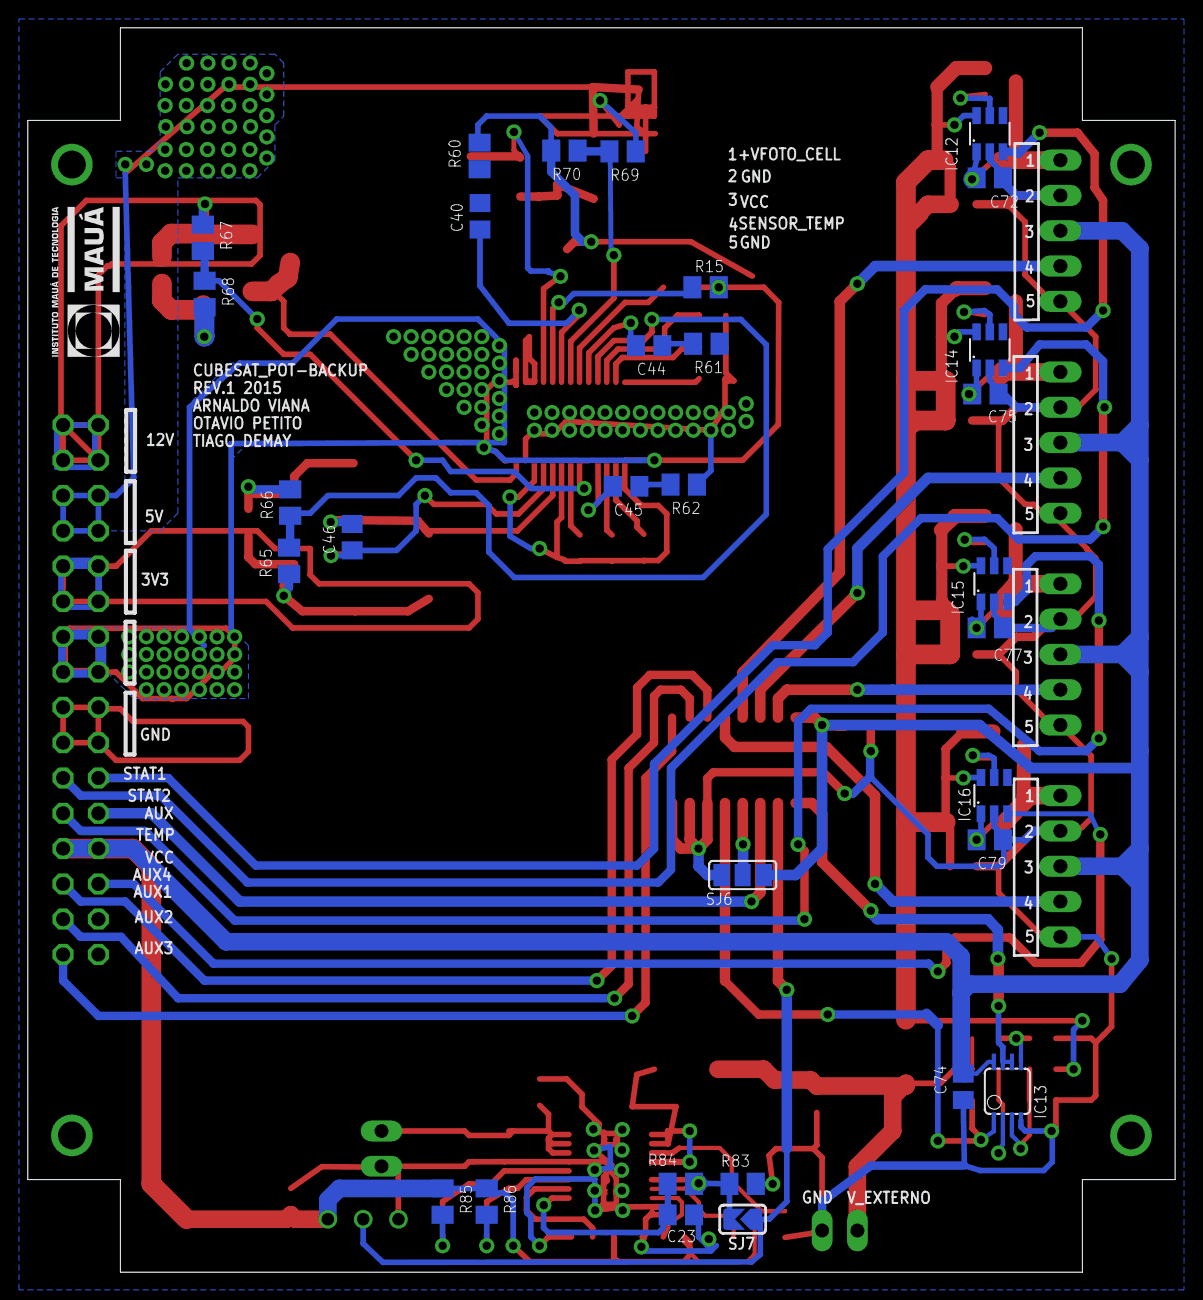
[picture p21: board Cubesat_Potencia_Backup-rev2.brd from below]

Board: 2 copper layers, 82.5 x 89.5 mm, 100 parts (32 on the bottom side), 67 nets.

Other parts of the board:
U$2, U$112: LOGO_MAUA
