arnaldojr/Cubesat/05. Cubesat_Potencia_Controle-rev1/Cubesat_Potencia_Controle-rev3.brd

## EAGLE design 05. Cubesat_Potencia_Controle-rev1/Cubesat_Potencia_Controle-rev3.brd (2018-11-02)

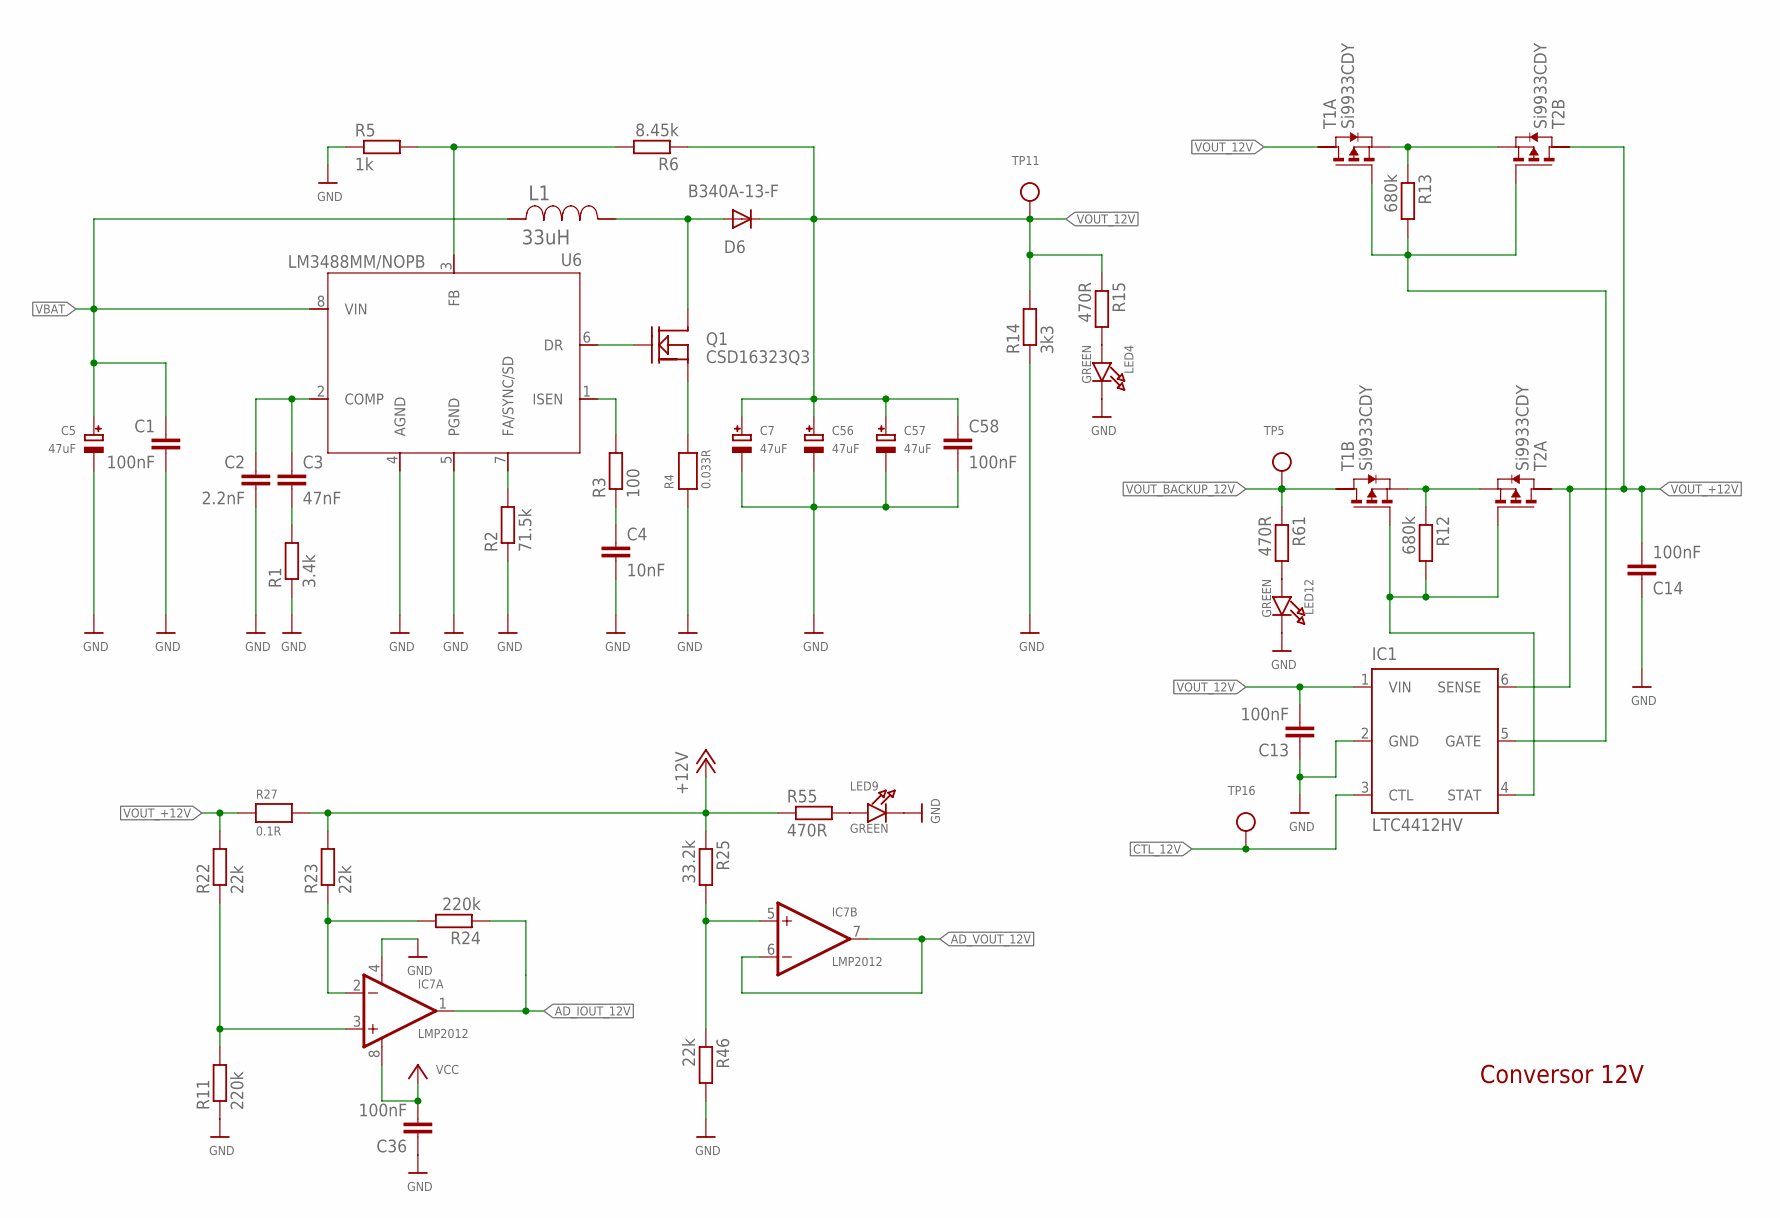
[picture p22: schematic Cubesat_Potencia_Controle-rev3.sch, sheet 1, Conversor 12v]

Parts:
C1, C13, C14, C36, C58: 100nF; C0805
C2: 2.2nF; C0805
C3: 47nF; C0805
C4: 10nF; C0805
C5, C7, C56, C57: 47uF; EIA6032-28/C-R
D6: B340A-13-F; DO214AC
IC1: LTC4412HV; TSOT23-6
IC7: LMP2012; MSOP08; MPN OPA2237EA/250
L1: 33uH; SDR1307
LED4, LED9, LED12: GREEN; CHIPLED_0805
Q1: CSD16323Q3; TRANS_NEXFET_Q3
R1: 3.4k; M0805
R2: 71.5k; M0805
R3: 100; M0805
R4: 0.033R; _2818
R5: 1k; M0805
R6: 8.45k; M0805
R11, R24: 220k; M0805
R12, R13: 680k; M0805
R14: 3k3; M0805
R15, R55, R61: 470R; M0805
R22, R23, R46: 22k; M0805
R25: 33.2k; M0805
R27: 0.1R; _2818
T1, T2: Si9933CDY; SO8
TP5, TP11, TP16: TESTPOINT0.1"; 1X01_ROUND
U6: LM3488MM/NOPB; MUA08A

Connections:
6: D6.A, L1.2, Q1.5 (DRAIN)
+12V: R23.2, R25.1, R27.2, R55.1; also elsewhere on the board
AD_IOUT_12V: IC7.1 (OUT), R24.1; also elsewhere on the board
AD_VOUT_12V: IC7.6 (-IN), IC7.7 (OUT); also elsewhere on the board
CTL_12V: IC1.3 (CTL), TP16.1; also elsewhere on the board
GND: C1.2, C2.2, C4.2, C5.-, C7.-, C13.1, C14.1, C36.1, C56.-, C57.-, C58.2, IC1.2 (GND), IC7.4 (V-), LED4.C, LED9.C, LED12.C, R1.1, R2.1, R4.1, R5.1, R11.1, R14.1, R46.2, U6.4 (AGND), U6.5 (PGND); also elsewhere on the board
unnamed: Q1.1 (SOURCE), R4.2
unnamed: Q1.4 (GATE), U6.6 (DR)
unnamed: R2.2, U6.7 (FA/SYNC/SD)
unnamed: R3.2, U6.1 (ISEN)
unnamed: C4.1, R3.1
unnamed: R5.2, R6.2, U6.3 (FB)
unnamed: C2.1, C3.1, U6.2 (COMP)
unnamed: C3.2, R1.2
unnamed: R13.1, T1.1 (S), T2.3 (S)
unnamed: R12.1, T1.3 (S), T2.1 (S)
unnamed: IC1.4 (STAT), R12.2, T1.4 (G), T2.2 (G)
unnamed: LED4.A, R15.2
unnamed: IC7.5 (+IN), R25.2, R46.1
unnamed: IC7.2 (-IN), R23.1, R24.2
unnamed: IC7.3 (+IN), R11.2, R22.1
unnamed: LED9.A, R55.2
unnamed: LED12.A, R61.2
STAT_12V: IC1.5 (GATE), R13.2, T1.2 (G), T2.4 (G)
VBAT: C1.1, C5.+, L1.1, U6.8 (VIN); also elsewhere on the board
VCC: C36.2, IC7.8 (V+); also elsewhere on the board
VOUT_12V: C7.+, C13.2, C56.+, C57.+, C58.1, D6.C, IC1.1 (VIN), R6.1, R14.2, R15.1, T1.7 (D), TP11.1
VOUT_+12V: C14.2, IC1.6 (SENSE), R22.2, R27.1, T2.6 (D), T2.7 (D)
VOUT_BACKUP_12V: R61.1, T1.6 (D), TP5.1; also elsewhere on the board

Notes on the sheet:
Conversor 12V

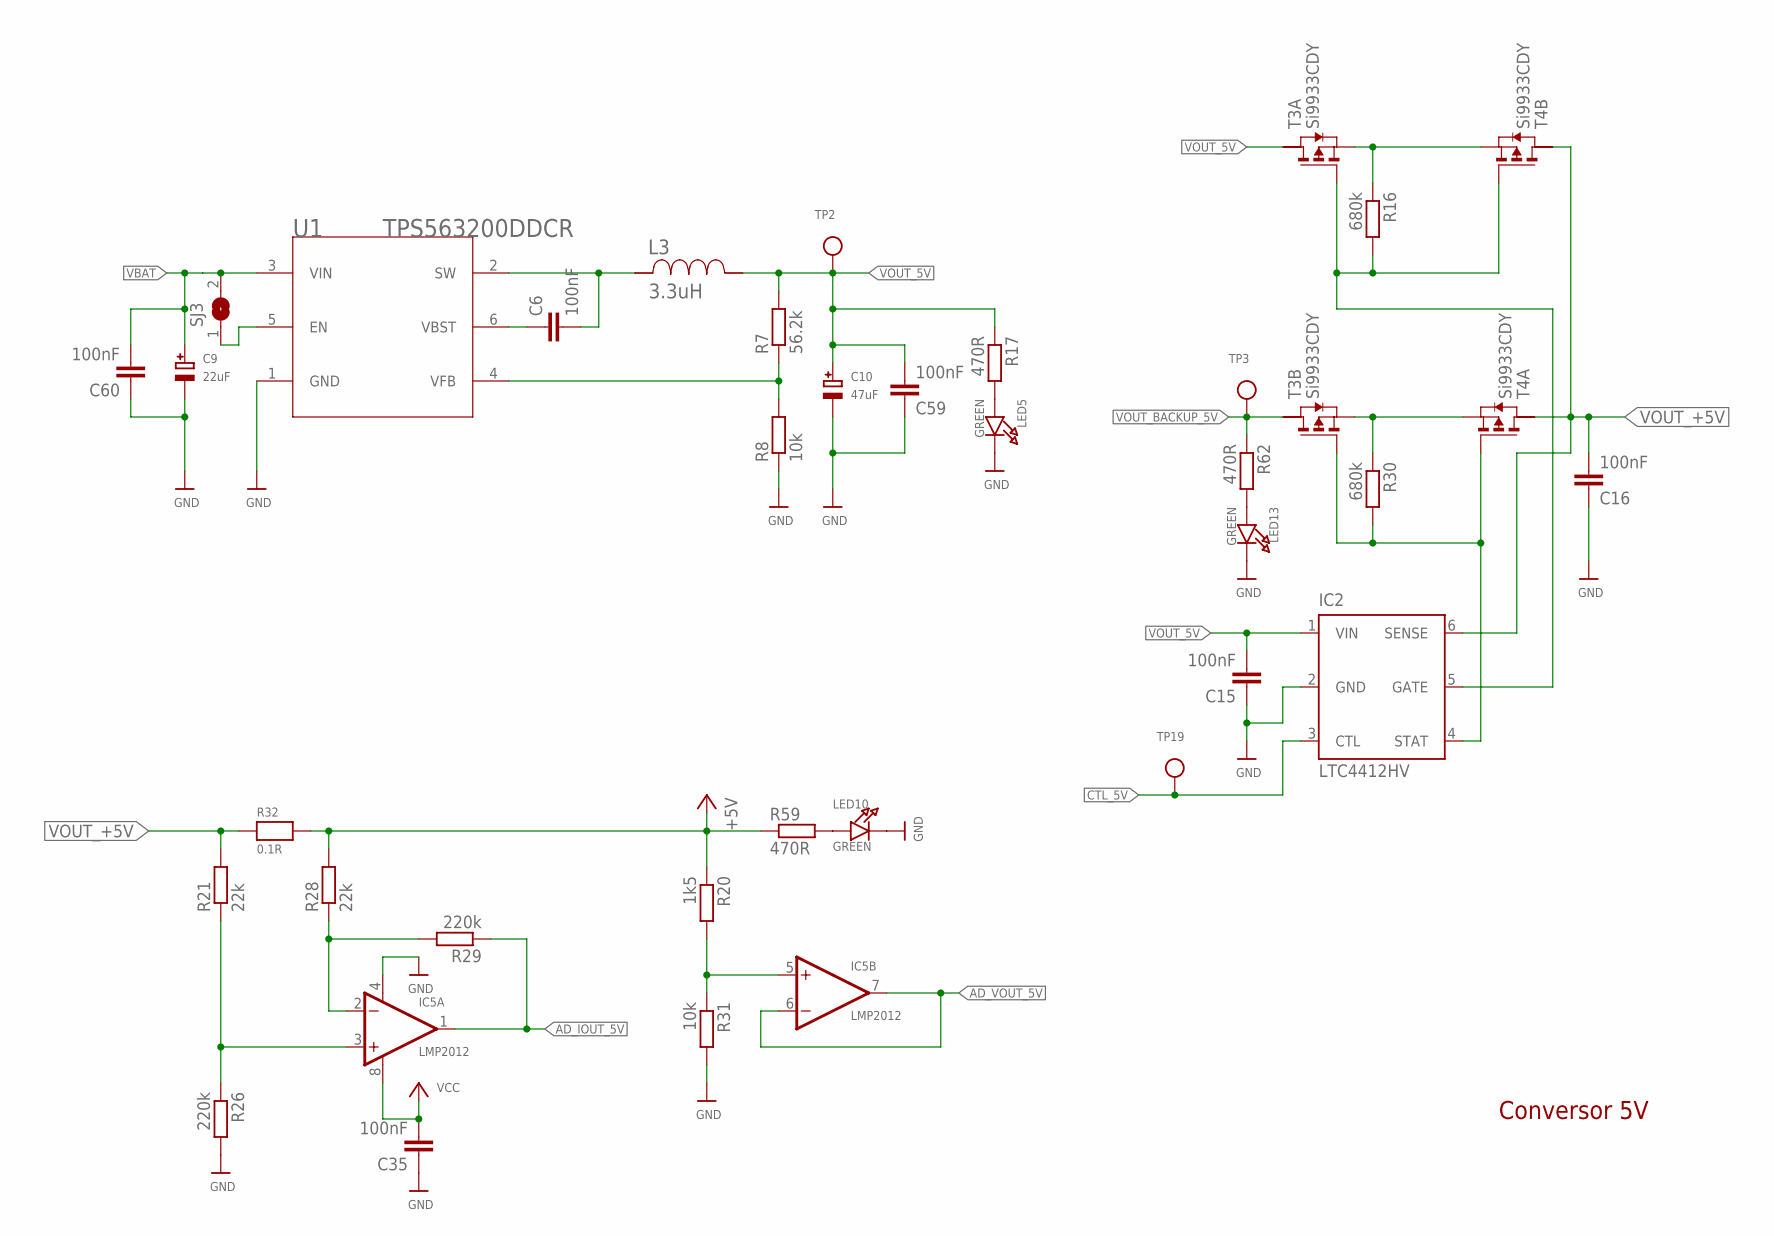
[picture p23: schematic Cubesat_Potencia_Controle-rev3.sch, sheet 2, Conversor 5v]

Parts:
C6, C15, C16, C35, C59, C60: 100nF; C0805
C9: 22uF; EIA6032-28/C-R
C10: 47uF; EIA6032-28/C-R
IC2: LTC4412HV; TSOT23-6
IC5: LMP2012; MSOP08; MPN OPA2237EA/250
L3: 3.3uH; SRR6038
LED5, LED10, LED13: GREEN; CHIPLED_0805
R7: 56.2k; M0805
R8, R31: 10k; M0805
R16, R30: 680k; M0805
R17, R59, R62: 470R; M0805
R20: 1k5; M0805
R21, R28: 22k; M0805
R26, R29: 220k; M0805
R32: 0.1R; _2818
SJ3: SOLDERJUMPER; SOLDERJUMPER_ARROW_NOPASTE
T3, T4: Si9933CDY; SO8
TP2, TP3, TP19: TESTPOINT0.1"; 1X01_ROUND
U1: TPS563200DDCR; DDC0006A

Connections:
+5V: R20.1, R28.2, R32.2, R59.1; also elsewhere on the board
AD_IOUT_5V: IC5.1 (OUT), R29.1; also elsewhere on the board
AD_VOUT_5V: IC5.6 (-IN), IC5.7 (OUT); also elsewhere on the board
CTL_5V: IC2.3 (CTL), TP19.1; also elsewhere on the board
GND: C9.-, C10.-, C15.1, C16.1, C35.1, C59.1, C60.1, IC2.2 (GND), IC5.4 (V-), LED5.C, LED10.C, LED13.C, R8.1, R26.2, R31.2, U1.1 (GND); also elsewhere on the board
unnamed: C6.1, U1.6 (VBST)
unnamed: C6.2, L3.1, U1.2 (SW)
unnamed: R7.1, R8.2, U1.4 (VFB)
unnamed: R16.1, T3.1 (S), T4.3 (S)
unnamed: R30.1, T3.3 (S), T4.1 (S)
unnamed: IC2.4 (STAT), R30.2, T3.4 (G), T4.2 (G)
unnamed: IC5.5 (+IN), R20.2, R31.1
unnamed: LED5.A, R17.2
unnamed: IC5.2 (-IN), R28.1, R29.2
unnamed: IC5.3 (+IN), R21.1, R26.1
unnamed: LED10.A, R59.2
unnamed: LED13.A, R62.2
unnamed: SJ3.1, U1.5 (EN)
STAT_5V: IC2.5 (GATE), R16.2, T3.2 (G), T4.4 (G)
VBAT: C9.+, C60.2, SJ3.2, U1.3 (VIN); also elsewhere on the board
VCC: C35.2, IC5.8 (V+); also elsewhere on the board
VOUT_5V: C10.+, C15.2, C59.2, IC2.1 (VIN), L3.2, R7.2, R17.1, T3.7 (D), TP2.1
VOUT_+5V: C16.2, IC2.6 (SENSE), R21.2, R32.1, T4.6 (D), T4.7 (D)
VOUT_BACKUP_5V: R62.1, T3.6 (D), TP3.1; also elsewhere on the board

Notes on the sheet:
Conversor 5V
