arnaldojr/Cubesat/05. Cubesat_Potencia_Controle-rev1/Cubesat_Potencia_Controle-rev3.brd

## EAGLE design 05. Cubesat_Potencia_Controle-rev1/Cubesat_Potencia_Controle-rev3.brd (continued)

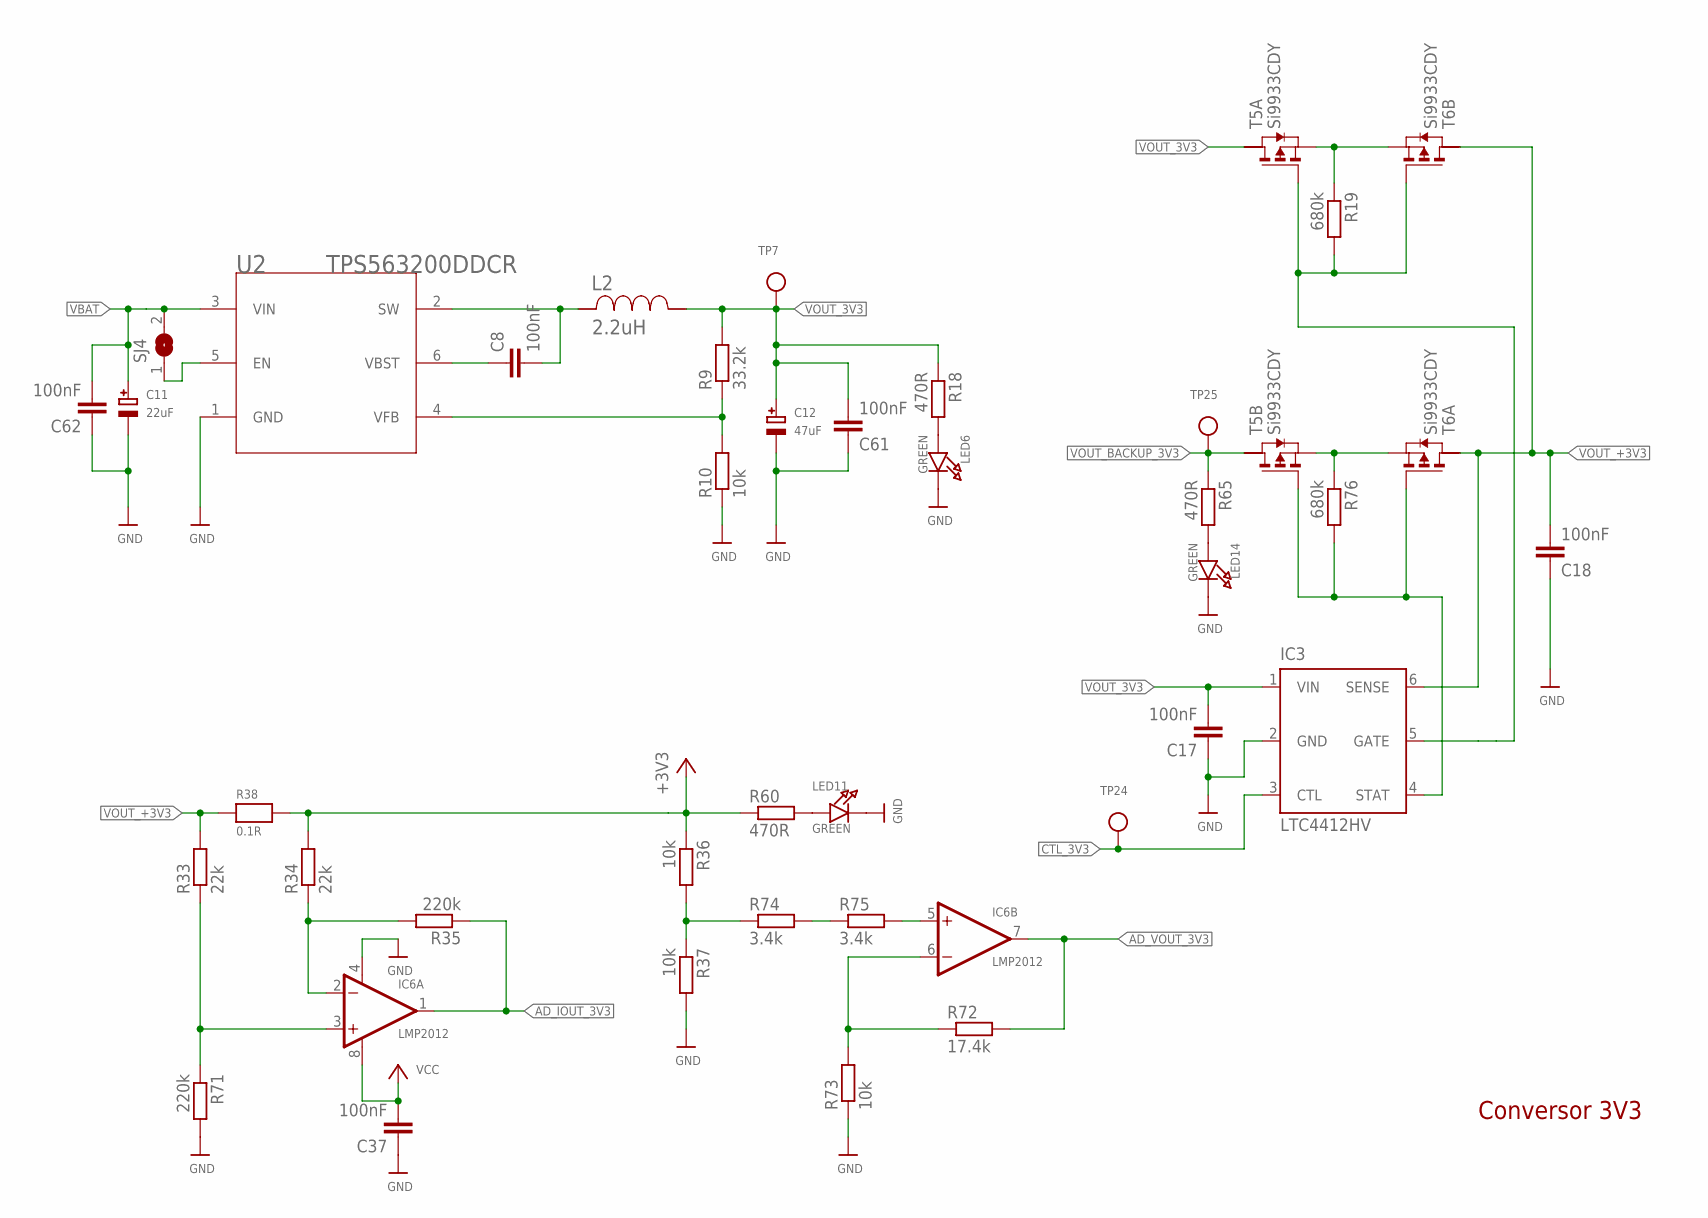
[picture p24: schematic Cubesat_Potencia_Controle-rev3.sch, sheet 3, Conversor 3v3]

Parts:
C8, C17, C18, C37, C61, C62: 100nF; C0805
C11: 22uF; EIA6032-28/C-R
C12: 47uF; EIA6032-28/C-R
IC3: LTC4412HV; TSOT23-6
IC6: LMP2012; MSOP08; MPN OPA2237EA/250
L2: 2.2uH; SRR6038
LED6, LED11, LED14: GREEN; CHIPLED_0805
R9: 33.2k; M0805
R10, R36, R37, R73: 10k; M0805
R18, R60, R65: 470R; M0805
R19, R76: 680k; M0805
R33, R34: 22k; M0805
R35, R71: 220k; M0805
R38: 0.1R; _2818
R72: 17.4k; M0805
R74, R75: 3.4k; M0805
SJ4: SOLDERJUMPER; SOLDERJUMPER_ARROW_NOPASTE
T5, T6: Si9933CDY; SO8
TP7, TP24, TP25: TESTPOINT0.1"; 1X01_ROUND
U2: TPS563200DDCR; DDC0006A

Connections:
+3V3: R34.2, R36.1, R38.2, R60.1; also elsewhere on the board
AD_IOUT_3V3: IC6.1 (OUT), R35.1; also elsewhere on the board
AD_VOUT_3V3: IC6.7 (OUT), R72.2; also elsewhere on the board
CTL_3V3: IC3.3 (CTL), TP24.1; also elsewhere on the board
GND: C11.-, C12.-, C17.1, C18.1, C37.1, C61.1, C62.1, IC3.2 (GND), IC6.4 (V-), LED6.C, LED11.C, LED14.C, R10.1, R37.2, R71.2, R73.1, U2.1 (GND); also elsewhere on the board
unnamed: C8.1, U2.6 (VBST)
unnamed: C8.2, L2.1, U2.2 (SW)
unnamed: R9.1, R10.2, U2.4 (VFB)
unnamed: IC6.6 (-IN), R72.1, R73.2
unnamed: R74.2, R75.1
unnamed: R19.1, T5.1 (S), T6.3 (S)
unnamed: R76.1, T5.3 (S), T6.1 (S)
unnamed: IC3.4 (STAT), R76.2, T5.4 (G), T6.2 (G)
unnamed: IC6.5 (+IN), R75.2
unnamed: LED6.A, R18.2
unnamed: R36.2, R37.1, R74.1
unnamed: IC6.2 (-IN), R34.1, R35.2
unnamed: IC6.3 (+IN), R33.1, R71.1
unnamed: LED11.A, R60.2
unnamed: LED14.A, R65.2
unnamed: SJ4.1, U2.5 (EN)
STAT_3V3: IC3.5 (GATE), R19.2, T5.2 (G), T6.4 (G)
VBAT: C11.+, C62.2, SJ4.2, U2.3 (VIN); also elsewhere on the board
VCC: C37.2, IC6.8 (V+); also elsewhere on the board
VOUT_3V3: C12.+, C17.2, C61.2, IC3.1 (VIN), L2.2, R9.2, R18.1, T5.7 (D), TP7.1
VOUT_+3V3: C18.2, IC3.6 (SENSE), R33.2, R38.1, T6.6 (D), T6.7 (D)
VOUT_BACKUP_3V3: R65.1, T5.6 (D), TP25.1; also elsewhere on the board

Notes on the sheet:
Conversor 3V3

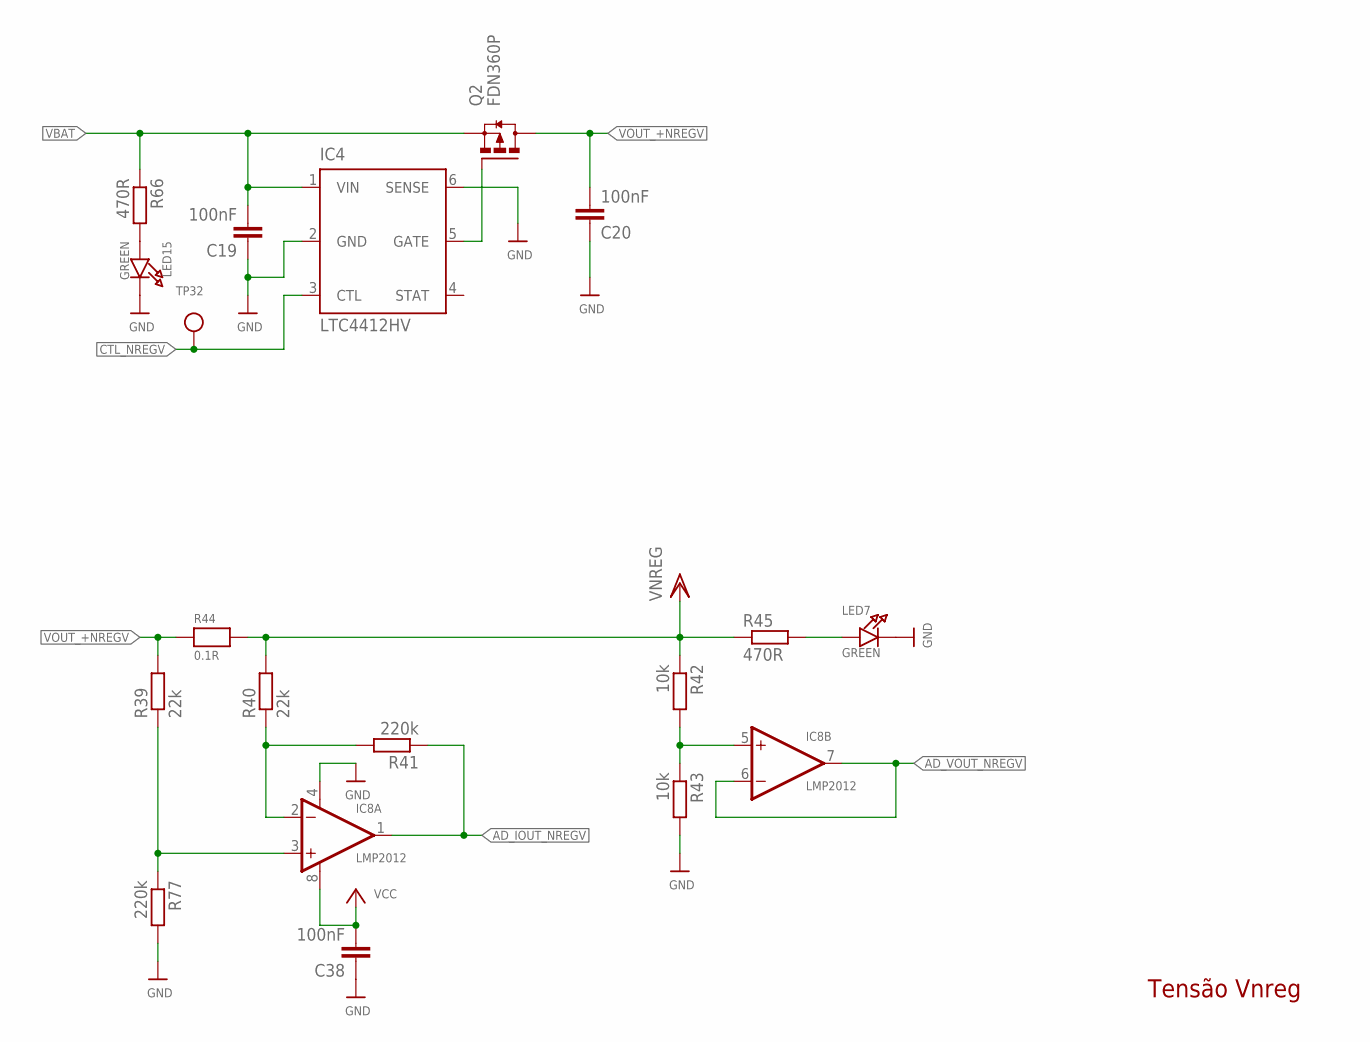
[picture p25: schematic Cubesat_Potencia_Controle-rev3.sch, sheet 4, Tensão Vnerg]

Parts:
C19, C20, C38: 100nF; C0805
IC4: LTC4412HV; TSOT23-6
IC8: LMP2012; MSOP08; MPN OPA2237EA/250
LED7, LED15: GREEN; CHIPLED_0805
Q2: FDN360P; SUPER-SOT3
R39, R40: 22k; M0805
R41, R77: 220k; M0805
R42, R43: 10k; M0805
R44: 0.1R; _2818
R45, R66: 470R; M0805
TP32: TESTPOINT0.1"; 1X01_ROUND

Connections:
AD_IOUT_NREGV: IC8.1 (OUT), R41.1; also elsewhere on the board
AD_VOUT_NREGV: IC8.6 (-IN), IC8.7 (OUT); also elsewhere on the board
CTL_NREGV: IC4.3 (CTL), TP32.1; also elsewhere on the board
GND: C19.1, C20.1, C38.1, IC4.2 (GND), IC4.6 (SENSE), IC8.4 (V-), LED7.C, LED15.C, R43.2, R77.2; also elsewhere on the board
unnamed: IC4.5 (GATE), Q2.1 (G)
unnamed: IC8.5 (+IN), R42.2, R43.1
unnamed: IC8.2 (-IN), R40.1, R41.2
unnamed: IC8.3 (+IN), R39.1, R77.1
unnamed: LED7.A, R45.2
unnamed: LED15.A, R66.2
VBAT: C19.2, IC4.1 (VIN), Q2.2 (S), R66.1; also elsewhere on the board
VCC: C38.2, IC8.8 (V+); also elsewhere on the board
VNREG: R40.2, R42.1, R44.2, R45.1; also elsewhere on the board
VOUT_+NREGV: C20.2, Q2.3 (D), R39.2, R44.1

Notes on the sheet:
Tensão Vnreg

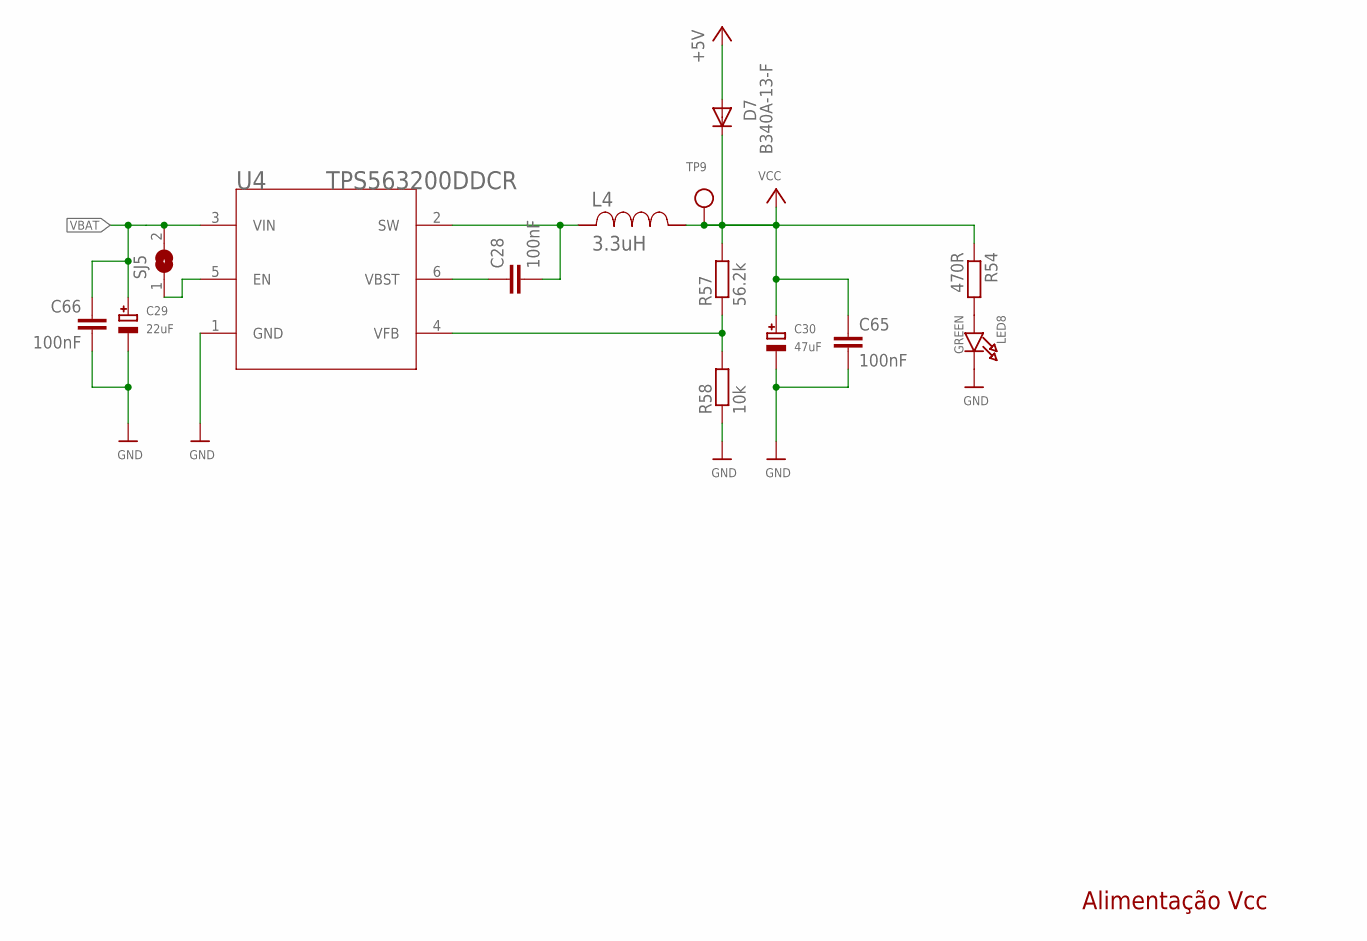
[picture p26: schematic Cubesat_Potencia_Controle-rev3.sch, sheet 5, Alimentação PCB Potência]

Parts:
C28, C65, C66: 100nF; C0805
C29: 22uF; EIA6032-28/C-R
C30: 47uF; EIA6032-28/C-R
D7: B340A-13-F; DO214AC
L4: 3.3uH; SRR6038
LED8: GREEN; CHIPLED_0805
R54: 470R; M0805
R57: 56.2k; M0805
R58: 10k; M0805
SJ5: SOLDERJUMPER; SOLDERJUMPER_ARROW_NOPASTE
TP9: TESTPOINT0.1"; 1X01_ROUND
U4: TPS563200DDCR; DDC0006A

Connections:
+5V: D7.A; also elsewhere on the board
GND: C29.-, C30.-, C65.2, C66.2, LED8.C, R58.1, U4.1 (GND); also elsewhere on the board
unnamed: C28.1, U4.6 (VBST)
unnamed: C28.2, L4.1, U4.2 (SW)
unnamed: R57.1, R58.2, U4.4 (VFB)
unnamed: LED8.A, R54.2
unnamed: SJ5.1, U4.5 (EN)
VBAT: C29.+, C66.1, SJ5.2, U4.3 (VIN); also elsewhere on the board
VCC: C30.+, C65.1, D7.C, L4.2, R54.1, R57.2, TP9.1; also elsewhere on the board

Notes on the sheet:
Alimentação Vcc

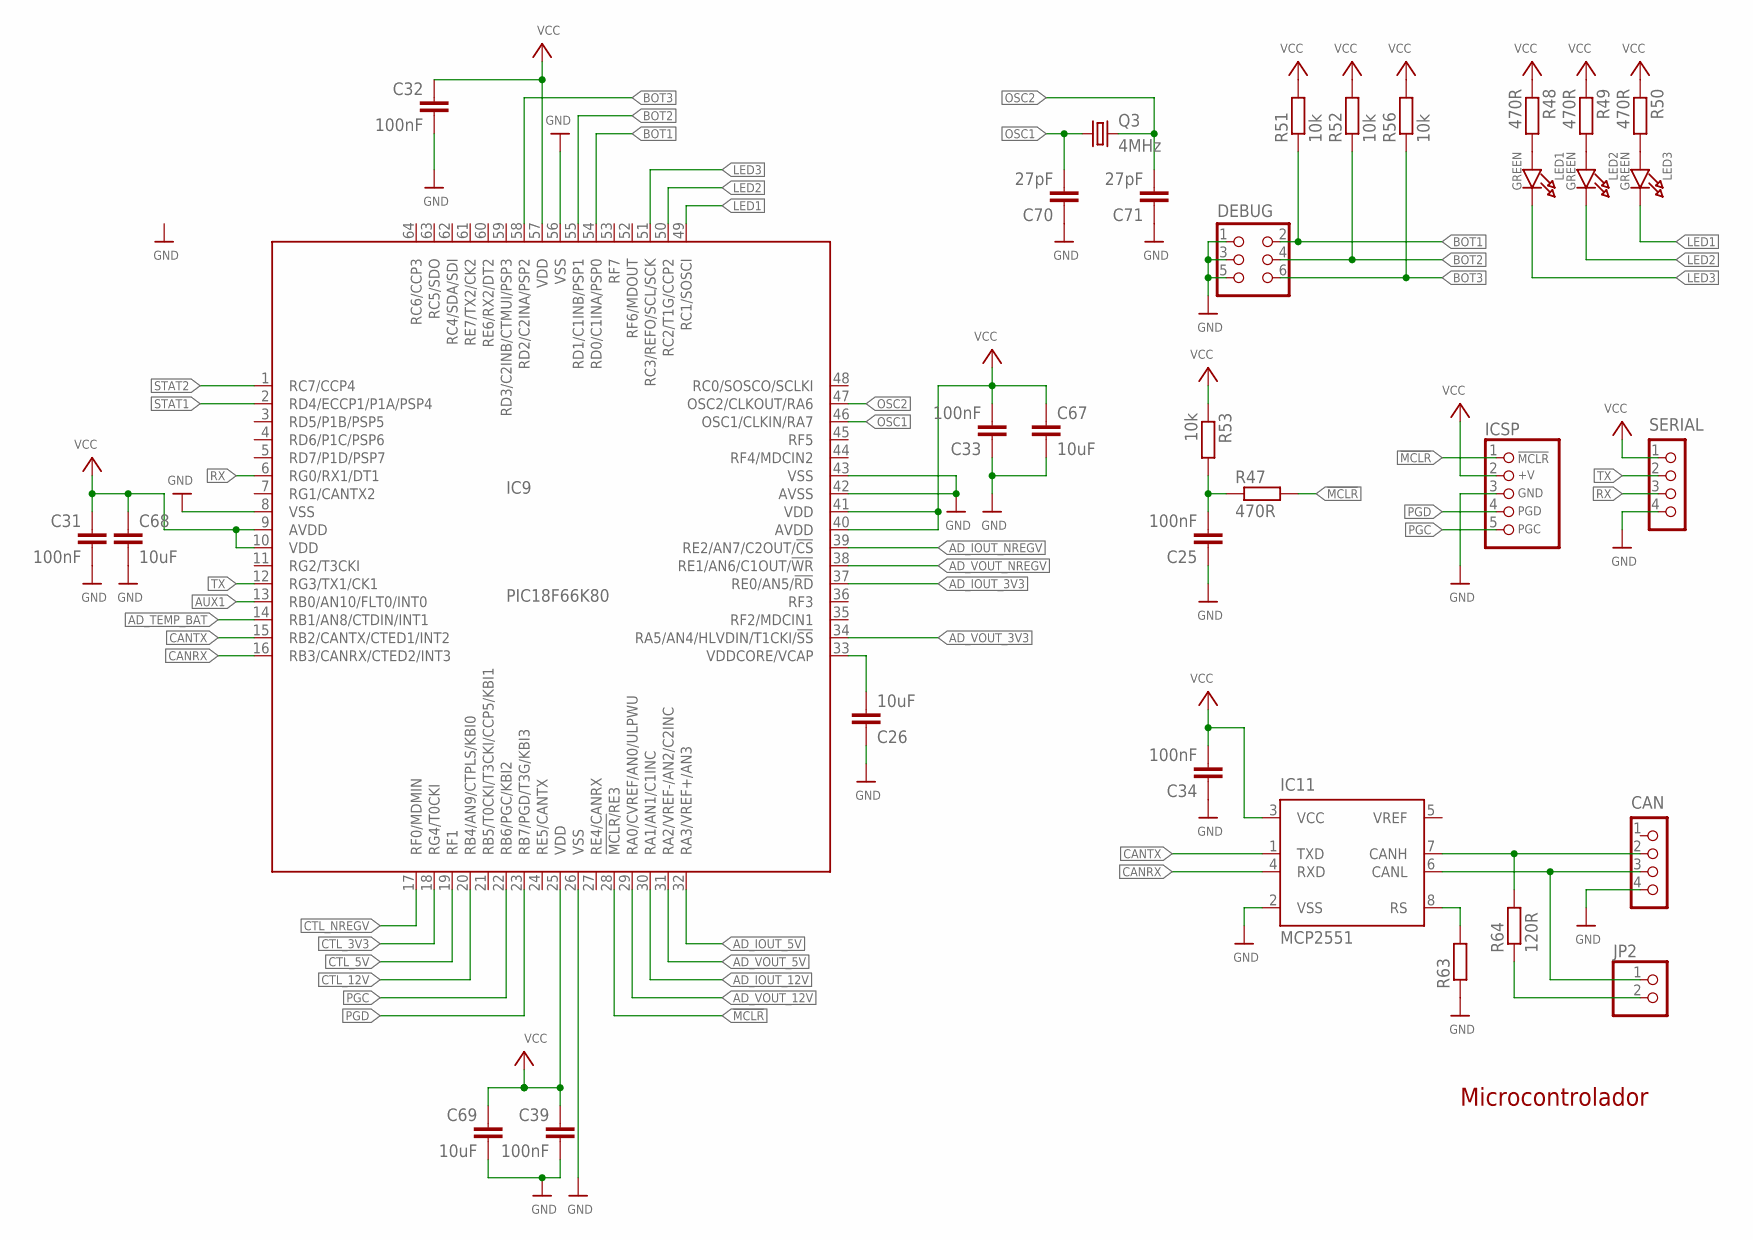
[picture p27: schematic Cubesat_Potencia_Controle-rev3.sch, sheet 6, Microcontrolador]

Parts:
C25, C31, C32, C33, C34, C39: 100nF; C0805
C26, C67, C68, C69: 10uF; C0805
C70, C71: 27pF; C0805
CAN: CON_HEADER_1X04; M1X4
DEBUG: CON_HEADER_2X03-PTH; M2X3
IC9: PIC18F66K80; TQFP64-10X10X1MM
IC11: MCP2551; SO-08
ICSP: CON_HEADER_PRG_PIC_ICSP0.1INCH_B; HEADER_PRG_1X05_ICSP_B
JP2: HEADER-1X2ROUND; 1X02_ROUND
LED1, LED2, LED3: GREEN; CHIPLED_0805
Q3: 4MHz; HC49/S
R47, R48, R49, R50: 470R; M0805
R51, R52, R53, R56: 10k; M0805
R63: R-EU_M0805; M0805
R64: 120R; M0805
SERIAL: CON_HEADER_1X04; M1X4

Connections:
!MCLR: IC9.28 (!MCLR/!RE3), ICSP.1 (/MCLR), R47.2
AD_IOUT_3V3: IC9.37 (RE0/AN5/!RD); also elsewhere on the board
AD_IOUT_5V: IC9.32 (RA3/VREF+/AN3); also elsewhere on the board
AD_IOUT_12V: IC9.30 (RA1/AN1/C1INC); also elsewhere on the board
AD_IOUT_NREGV: IC9.39 (RE2/AN7/C2OUT/!CS); also elsewhere on the board
AD_TEMP_BAT: IC9.14 (RB1/AN8/CTDIN/INT1); also elsewhere on the board
AD_VOUT_3V3: IC9.34 (RA5/AN4/HLVDIN/T1CKI/!SS); also elsewhere on the board
AD_VOUT_5V: IC9.31 (RA2/VREF-/AN2/C2INC); also elsewhere on the board
AD_VOUT_12V: IC9.29 (RA0/CVREF/AN0/ULPWU); also elsewhere on the board
AD_VOUT_NREGV: IC9.38 (RE1/AN6/C1OUT/!WR); also elsewhere on the board
AUX1: IC9.13 (RB0/AN10/FLT0/INT0); also elsewhere on the board
BOT1: DEBUG.2, IC9.54 (RD0/C1INA/PSP0), R51.1
BOT2: DEBUG.4, IC9.55 (RD1/C1INB/PSP1), R52.1
BOT3: DEBUG.6, IC9.58 (RD2/C2INA/PSP2), R56.1
CANRX: IC9.16 (RB3/CANRX/CTED2/INT3), IC11.4 (RXD)
CANTX: IC9.15 (RB2/CANTX/CTED1/INT2), IC11.1 (TXD)
CTL_3V3: IC9.18 (RG4/T0CKI); also elsewhere on the board
CTL_5V: IC9.19 (RF1); also elsewhere on the board
CTL_12V: IC9.20 (RB4/AN9/CTPLS/KBI0); also elsewhere on the board
CTL_NREGV: IC9.17 (RF0/MDMIN); also elsewhere on the board
GND: C25.1, C26.1, C31.2, C32.2, C33.1, C34.1, C39.2, C67.2, C68.2, C69.2, C70.1, C71.1, CAN.4, DEBUG.1, DEBUG.3, DEBUG.5, IC9.8 (VSS), IC9.26 (VSS), IC9.42 (AVSS), IC9.43 (VSS), IC9.56 (VSS), IC11.2 (VSS), ICSP.3 (GND), R63.1, SERIAL.4; also elsewhere on the board
LED1: IC9.49 (RC1/SOSCI), LED3.C
LED2: IC9.50 (RC2/T1G/CCP2), LED2.C
LED3: IC9.51 (RC3/REFO/SCL/SCK), LED1.C
unnamed: LED1.A, R48.2
unnamed: LED2.A, R49.2
unnamed: LED3.A, R50.2
unnamed: C25.2, R47.1, R53.2
unnamed: C26.2, IC9.33 (VDDCORE/VCAP)
unnamed: JP2.2, R64.1
unnamed: CAN.2, IC11.7 (CANH), R64.2
unnamed: CAN.3, IC11.6 (CANL), JP2.1
unnamed: IC11.8 (RS), R63.2
OSC1: C70.2, IC9.46 (OSC1/CLKIN/RA7), Q3.1
OSC2: C71.2, IC9.47 (OSC2/CLKOUT/RA6), Q3.2
PGC: IC9.22 (RB6/PGC/KBI2), ICSP.5 (PGC)
PGD: IC9.23 (RB7/PGD/T3G/KBI3), ICSP.4 (PGD)
RX: IC9.6 (RG0/RX1/DT1), SERIAL.3
STAT1: IC9.2 (RD4/ECCP1/P1A/PSP4); also elsewhere on the board
STAT2: IC9.1 (RC7/CCP4); also elsewhere on the board
TX: IC9.12 (RG3/TX1/CK1), SERIAL.2
VCC: C31.1, C32.1, C33.2, C34.2, C39.1, C67.1, C68.1, C69.1, IC9.9 (AVDD), IC9.10 (VDD), IC9.25 (VDD), IC9.40 (AVDD), IC9.41 (VDD), IC9.57 (VDD), IC11.3 (VCC), ICSP.2 (+V), R48.1, R49.1, R50.1, R51.2, R52.2, R53.1, R56.2, SERIAL.1; also elsewhere on the board

Notes on the sheet:
Microcontrolador

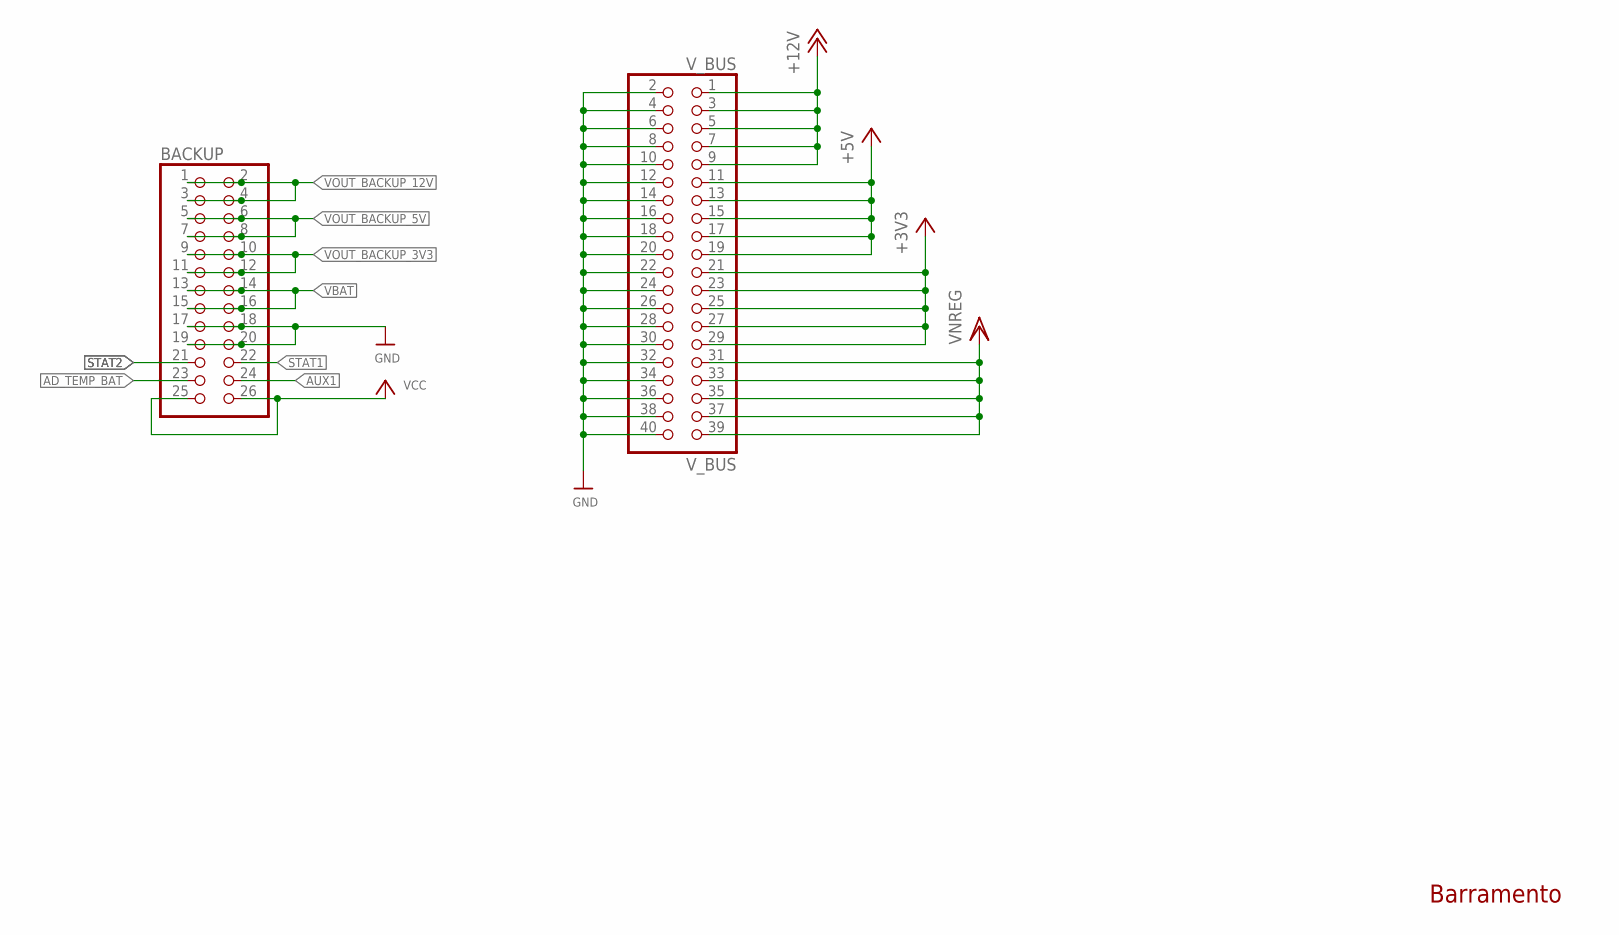
[picture p28: schematic Cubesat_Potencia_Controle-rev3.sch, sheet 7, Barramento]

Parts:
BACKUP: HEADER-2X13; 2X13
V_BUS: V_BUS; 2X20

Connections:
+3V3: V_BUS.21, V_BUS.23, V_BUS.25, V_BUS.27, V_BUS.29; also elsewhere on the board
+5V: V_BUS.11, V_BUS.13, V_BUS.15, V_BUS.17, V_BUS.19; also elsewhere on the board
+12V: V_BUS.1, V_BUS.3, V_BUS.5, V_BUS.7, V_BUS.9; also elsewhere on the board
AD_TEMP_BAT: BACKUP.23; also elsewhere on the board
AUX1: BACKUP.24; also elsewhere on the board
GND: BACKUP.17, BACKUP.18, BACKUP.19, BACKUP.20, V_BUS.2, V_BUS.4, V_BUS.6, V_BUS.8, V_BUS.10, V_BUS.12, V_BUS.14, V_BUS.16, V_BUS.18, V_BUS.20, V_BUS.22, V_BUS.24, V_BUS.26, V_BUS.28, V_BUS.30, V_BUS.32, V_BUS.34, V_BUS.36, V_BUS.38, V_BUS.40; also elsewhere on the board
STAT1: BACKUP.22; also elsewhere on the board
STAT2: BACKUP.21; also elsewhere on the board
VBAT: BACKUP.13, BACKUP.14, BACKUP.15, BACKUP.16; also elsewhere on the board
VCC: BACKUP.25, BACKUP.26; also elsewhere on the board
VNREG: V_BUS.31, V_BUS.33, V_BUS.35, V_BUS.37, V_BUS.39; also elsewhere on the board
VOUT_BACKUP_3V3: BACKUP.9, BACKUP.10, BACKUP.11, BACKUP.12; also elsewhere on the board
VOUT_BACKUP_5V: BACKUP.5, BACKUP.6, BACKUP.7, BACKUP.8; also elsewhere on the board
VOUT_BACKUP_12V: BACKUP.1, BACKUP.2, BACKUP.3, BACKUP.4; also elsewhere on the board

Notes on the sheet:
Barramento

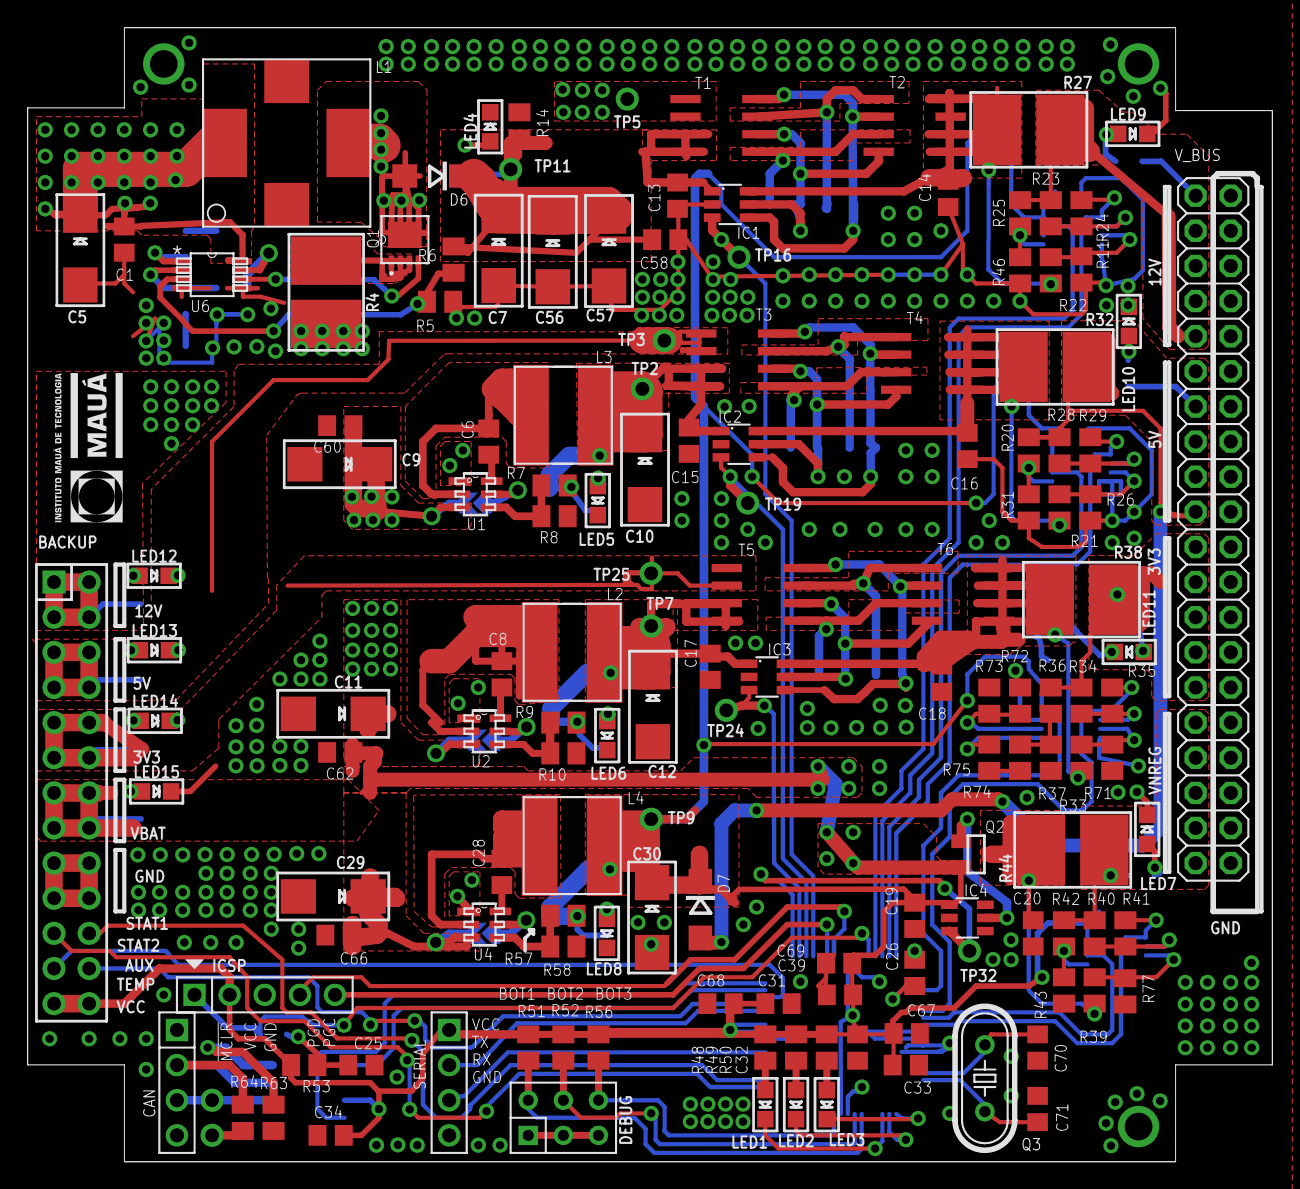
[picture p29: board Cubesat_Potencia_Controle-rev3.brd from above]

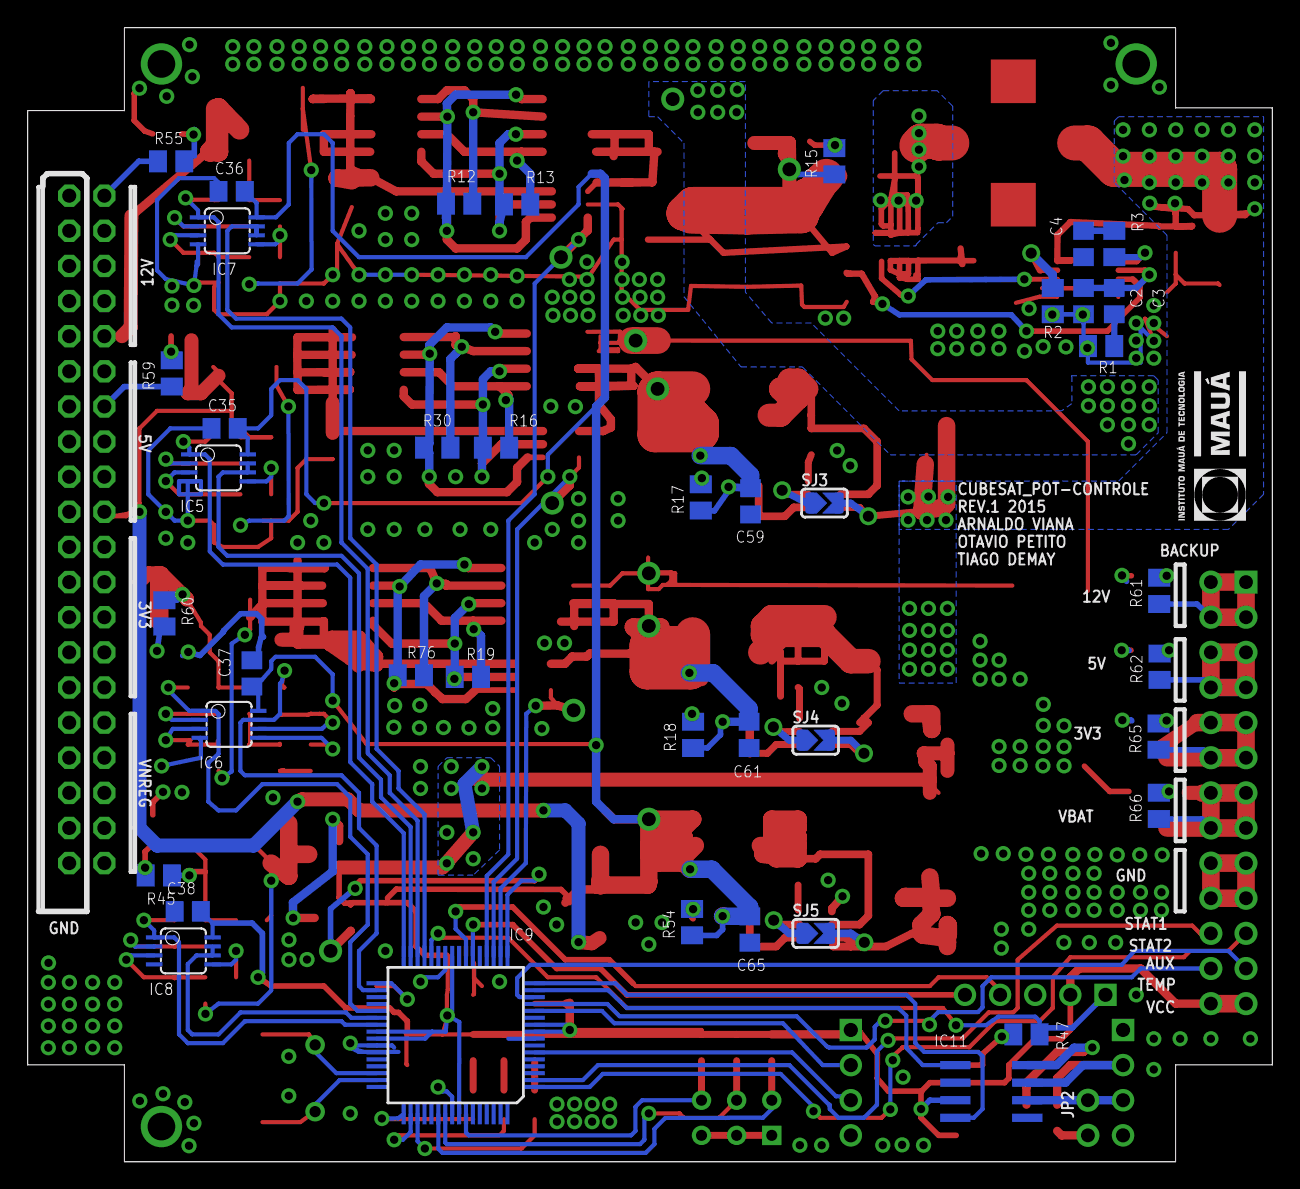
[picture p30: board Cubesat_Potencia_Controle-rev3.brd from below]

Board: 2 copper layers, 90.0 x 82.0 mm, 188 parts (43 on the bottom side), 118 nets.

Other parts of the board:
U$112, U$113: LOGO_MAUA
