arnaldojr/Cubesat/08. Cubesat_Potencia_Painel_Solar/Cubesat_Potencia_Painel_Solar.brd

## EAGLE design 08. Cubesat_Potencia_Painel_Solar/Cubesat_Potencia_Painel_Solar.brd (2018-11-02)

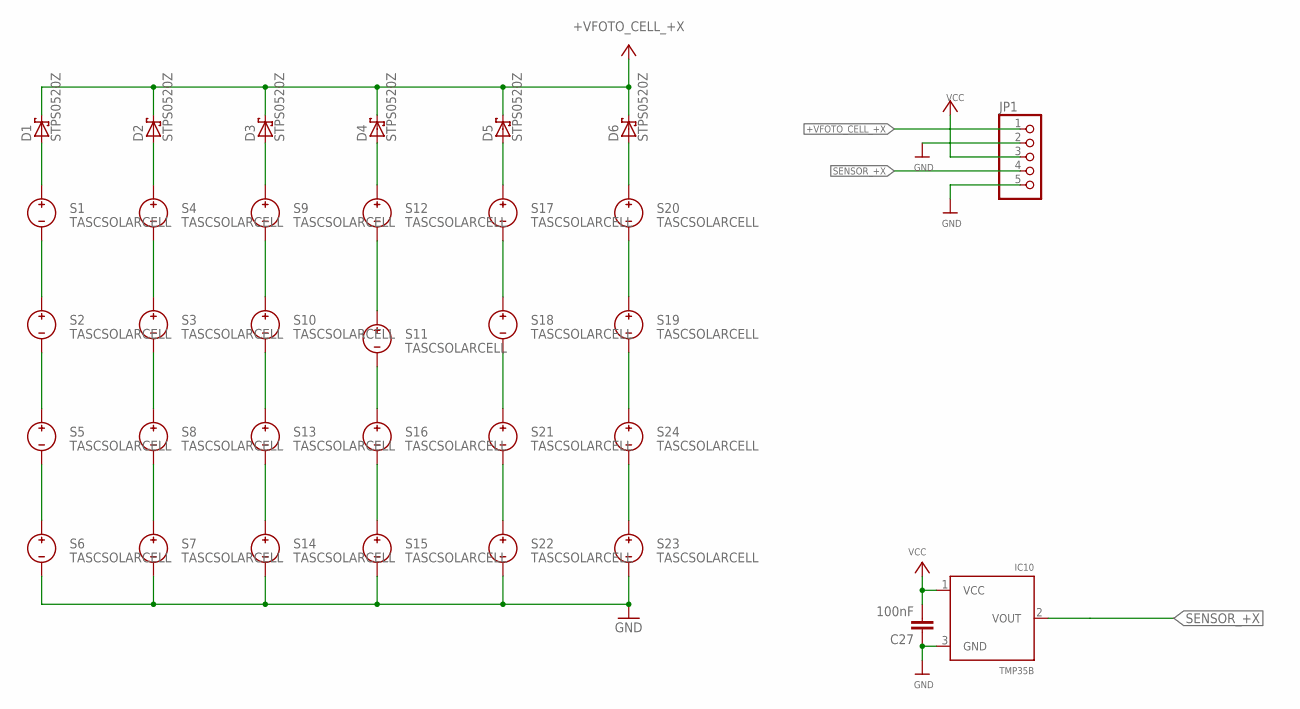
[picture p31: schematic Cubesat_Potencia_Painel_Solar.sch]

Parts:
C27: 100nF; C0805
D1, D2, D3, D4, D5, D6: STPS0520Z; SOD-123
IC10: TMP35B; TO92-LINE
JP1: HEADER-1X5SMT; 1X05_SMT
S1, S2, S3, S4, S5, S6, S7, S8, S9, S10, S11, S12, S13, S14, S15, S16, S17, S18, S19, S20, S21, S22, S23, S24: TASCSOLARCELL

Connections:
+VFOTO_CELL_+X: D1.C, D2.C, D3.C, D4.C, D5.C, D6.C, JP1.1
GND: C27.1, IC10.3 (GND), JP1.2, JP1.5, S6.N, S7.N, S14.N, S15.N, S22.N, S23.N
unnamed: D1.A, S1.P
unnamed: S1.N, S2.P
unnamed: S2.N, S5.P
unnamed: S5.N, S6.P
unnamed: S7.P, S8.N
unnamed: S3.N, S8.P
unnamed: S3.P, S4.N
unnamed: S13.N, S14.P
unnamed: S10.N, S13.P
unnamed: S9.N, S10.P
unnamed: S15.P, S16.N
unnamed: S11.N, S16.P
unnamed: S11.P, S12.N
unnamed: S21.N, S22.P
unnamed: S18.N, S21.P
unnamed: S17.N, S18.P
unnamed: S23.P, S24.N
unnamed: S19.N, S24.P
unnamed: S19.P, S20.N
unnamed: D2.A, S4.P
unnamed: D3.A, S9.P
unnamed: D4.A, S12.P
unnamed: D5.A, S17.P
unnamed: D6.A, S20.P
SENSOR_+X: IC10.2 (VOUT), JP1.4
VCC: C27.2, IC10.1 (VCC), JP1.3

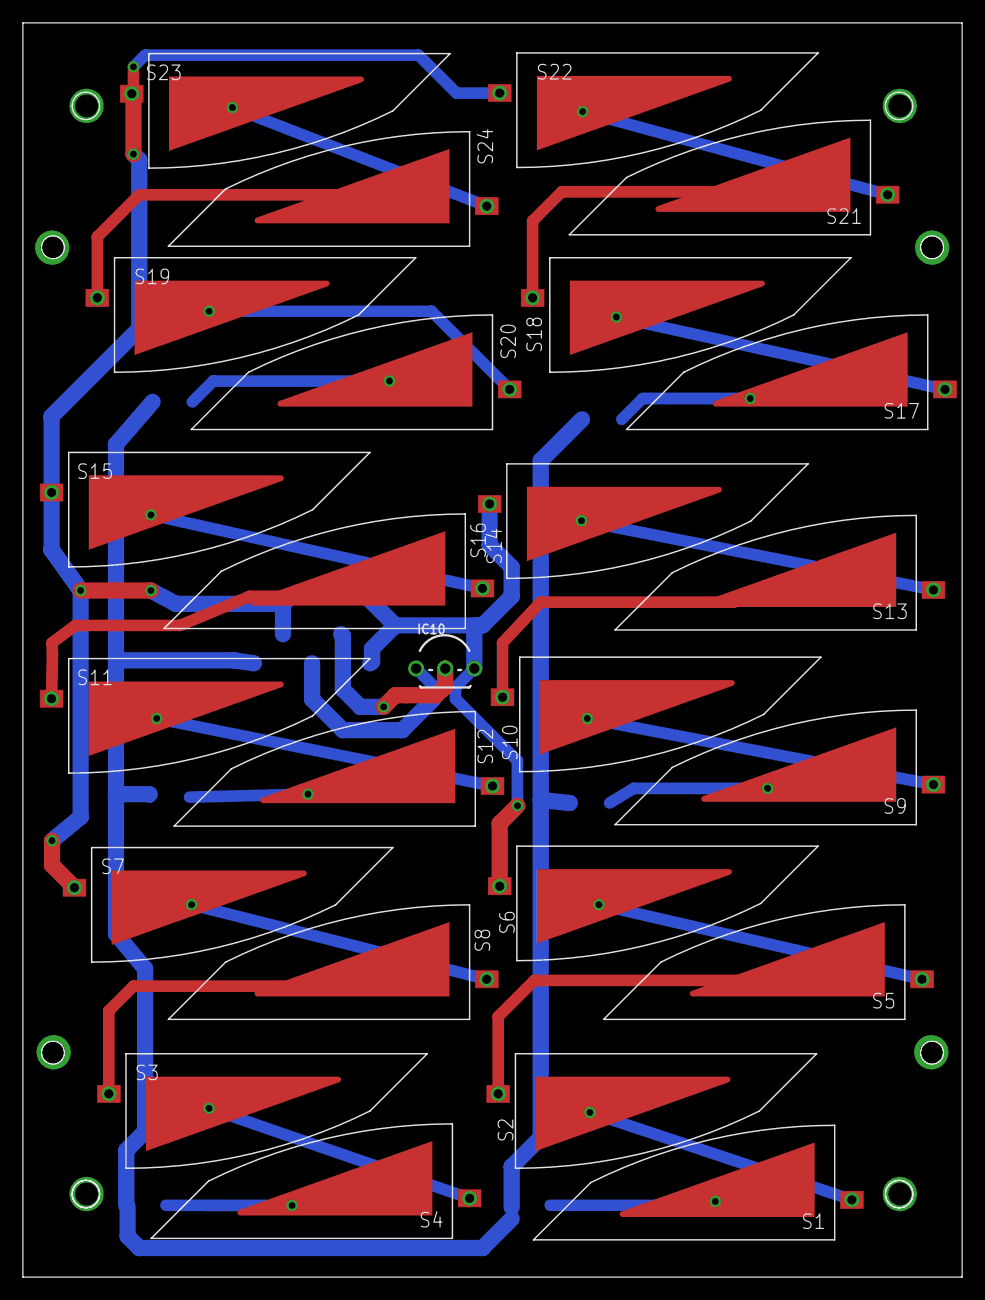
[picture p32: board Cubesat_Potencia_Painel_Solar.brd from above]

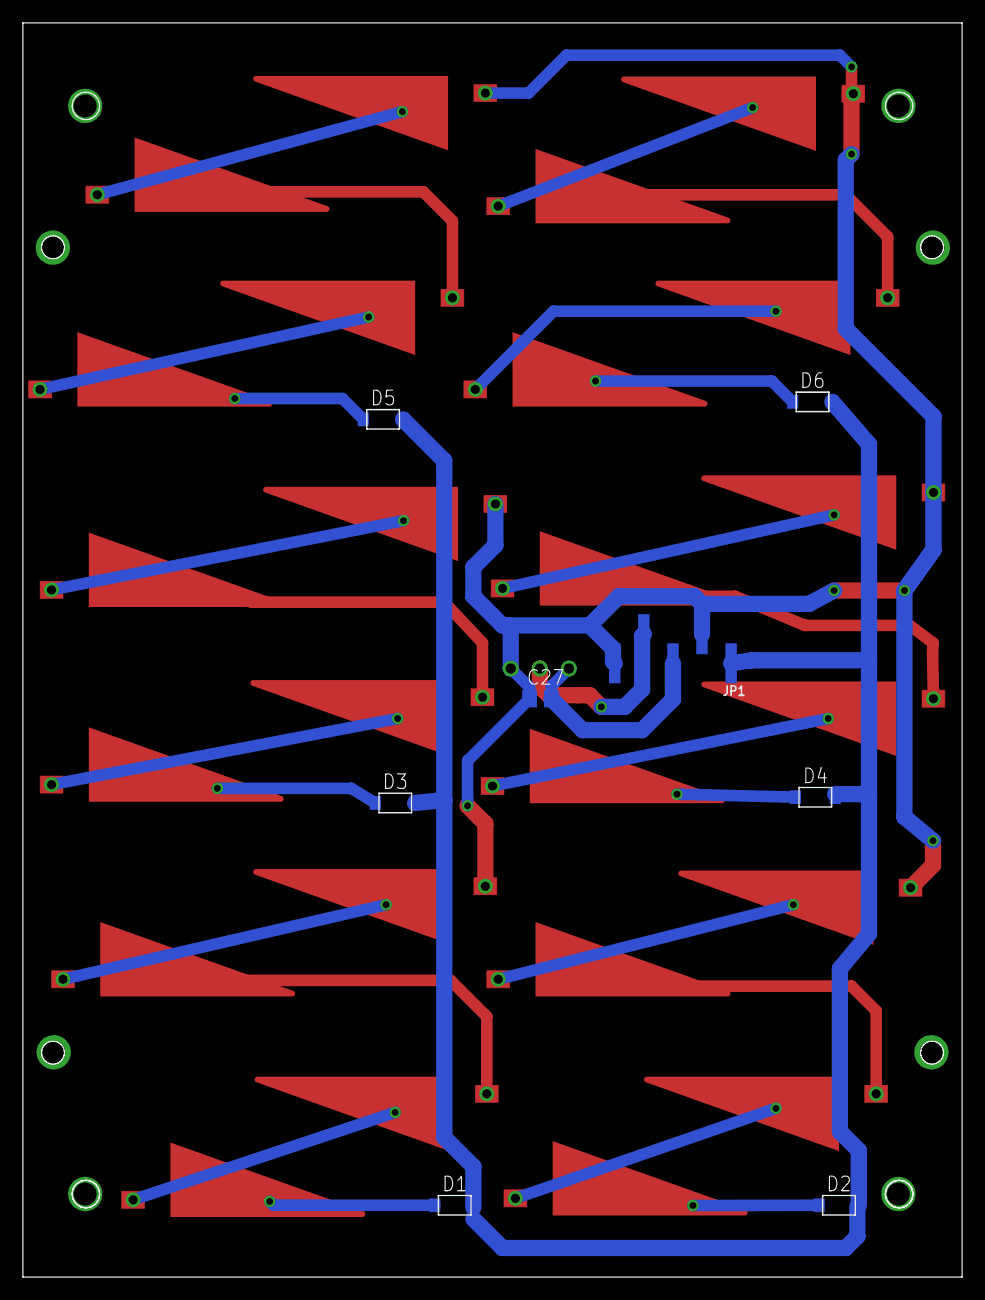
[picture p33: board Cubesat_Potencia_Painel_Solar.brd from below]

Board: 2 copper layers, 82.0 x 109.5 mm, 33 parts (8 on the bottom side), 28 nets.
